NathanSpalding/wdd2-pick-and-place-arm/docs/datasheets.md

# Datasheets and sources

Datasheets and papers are not stored here because they are copyrighted. Download them from the manufacturer or the supplier pages below. The full reference list is at the end of the report.

## Components

| Part | Datasheet from | Bought from |
|---|---|---|
| ESP32-S3-WROOM-1 (N16R8) | Espressif | [Micro Robotics](https://www.robotics.org.za/ESP32-S3-N16R8) |
| AS5600 magnetic encoder | ams OSRAM | [Amazon](https://www.amazon.com/dp/B0CM3C8KFT) |
| TCA9548A I²C multiplexer | Texas Instruments | [Takealot](https://www.takealot.com/tca9548a-i2c-iic-multiplexer-breakout-board-8-channel-expansion/PLID101395334) |
| INA219 current sensor | Texas Instruments | [Micro Robotics](https://www.robotics.org.za/INA219-MOD) |
| XL4016 buck converter | XLSEMI | [Micro Robotics](https://www.robotics.org.za/XL4016) |
| DS5180 servo (shoulder) | DSServo / ANNIMOS | [Micro Robotics](https://www.robotics.org.za/DS5180-270-FB) |
| DS3240 servo (base, elbow) | DSServo | [Micro Robotics](https://www.robotics.org.za/DS3240-270-FB) |
| DS3225 servo (wrist) | DSServo | [Amazon](https://www.amazon.com/dp/B0CNTG877G) |
| MG996R servo (gripper) | Tower Pro | [Takealot](https://www.takealot.com/cmu-mg996r-towerpro-11kg-metal-gear-rc-servo-motor-180-4-8-6-6v/PLID100881340) |
| KP08 pillow block | — | [Netram](https://www.netram.co.za/bearings/8997-kp08-pillow-block-8mm-bore-2-pack.html) |
| PBME16TR-M4AL emergency stop | — | [Communica](https://www.communica.co.za/products/pbme16tr-m4al) |
| Hyper PLA-CF filament | Creality technical data sheet | DIYElectronics |

## Key references

- Al Tahtawi et al. (2021), *Small-scale robot arm design with pick and place mission based on inverse kinematics*, https://doi.org/10.18196/jrc.26124 (the 54 mm benchmark).
- Budynas and Nisbett (2015), *Shigley's Mechanical Engineering Design*, 10th ed. (stress and bearing life).
- Craig (2005), *Introduction to Robotics: Mechanics and Control* (kinematics).
- ISO 9283:1998, *Manipulating industrial robots: performance criteria and related test methods* (accuracy and repeatability).
- Carpentier et al. (2019), Pinocchio, and Caron, Pink (inverse kinematics libraries used by the software).
