NathanSpalding/wdd2-pick-and-place-arm/electronics/schematic/ESP_S3_N16R8_Pinout.png

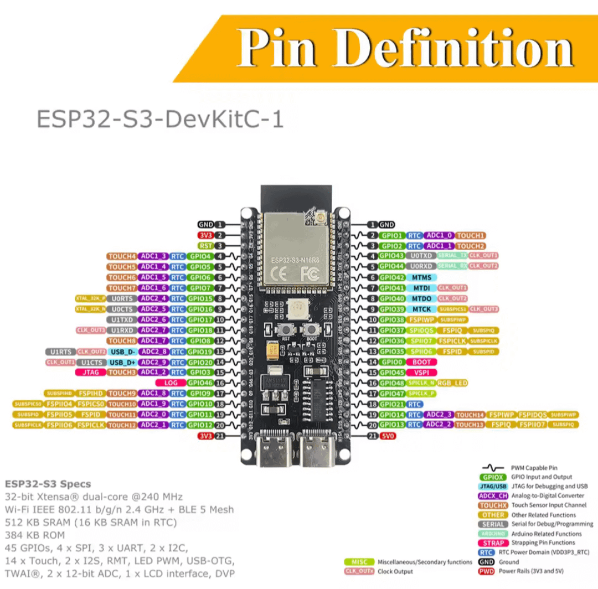
electronics/schematic/ESP_S3_N16R8_Pinout.png
