NathanSpalding/wdd2-pick-and-place-arm/electronics/BOM.xlsx

BOM
Description | QTY | UNIT PRICE | LINK | MATERIAL | INFILL | MASS PER PART (g) | LINE TOTAL (R)
Servo Motors
MG996R | 1 | R 129 | https://www.takealot.com/cmu-mg996r-towerpro-11kg-metal-gear-rc-servo-motor-180-4-8-6-6v/PLID100881340 |  |  |  | R 129.00
DS3225 | 1 | R 295 | https://www.amazon.com/dp/B0CNTG877G?ref=ppx_yo2ov_dt_b_fed_asin_title&th=1 |  |  |  | R 295.00
DS3240 | 2 | R 238 | https://www.robotics.org.za/DS3240-270-FB |  |  |  | R 476.00
DS5180 | 1 | R 398 | https://www.robotics.org.za/DS5180-270-FB |  |  |  | R 398.00
Servo Horns
25T for DS32 series | 3
18T for DS51 series | 1
Electrical
ESP S3 - N16R8 | 1 | R 178 | https://www.robotics.org.za/ESP32-S3-N16R8 |  |  |  | R 178.00
XL4016 Voltage Regulator | 3 | R 58 | https://www.robotics.org.za/XL4016 |  |  |  | R 174.00
INA219 Current Sensor | 1 | R 28 | https://www.robotics.org.za/INA219-MOD |  |  |  | R 28.00
TCA9548A I2C mux | 1 | R 63 | https://www.takealot.com/tca9548a-i2c-iic-multiplexer-breakout-board-8-channel-expansion/PLID101395334 |  |  |  | R 63.00
XT60 Connector | 1 | R 23 | https://www.robotics.org.za/XT60-KIT |  |  |  | R 23.00
3 Prong Plug | 1 | R 59 | https://www.builders.co.za/Electrical-and-Electronics/Plugs-Sockets-and-Switches/Multi-Plugs/Electricmate-Solid-Rubber-3-Prong-Plug-Top-Black-10-A/p/000000000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 |  |  |  | R 59.00
Cabtyre 1.5mm X3 Core | 3m | R 35 | https://www.builders.co.za/Electrical-and-Electronics/Wiring/Pre-Cut-Cables/waco-cabtyre-cable-black-3000-x-1-mm/p/000000850032252001 |  |  |  | R 35.00
Blade 30 A Fuse holder | 1 | R 12 | https://www.robotics.org.za/BLADE-30A-CAP |  |  |  | R 12.00
PBME16TR-M4AL Emergency Stop Switch 16mm 2c/o Latching Twist Reset | 1 | R 158 | https://www.communica.co.za/products/pbme16tr-m4al?variant=30700683788361 |  |  |  | R 158.00
12V 20A 300W DC Power Supply | 1 | R 211 | https://www.takealot.com/12v-20a-300w-professional-dc-power-supply/PLID95767010 |  |  |  | R 211.00
15A Blade Fuse | 5 | R 6.5 | https://www.takealot.com/motoquip-blade-fuses-15-amp/PLID40661066 |  |  |  | R 32.50
AS5600 Magnetic Encoder | 4 | R 41 | https://www.amazon.com/dp/B0CM3C8KFT?ref=ppx_yo2ov_dt_b_fed_asin_title |  |  |  | R 164.00
5V 1A Buck Regulator | 1 | R 16 | https://www.robotics.org.za/5V1A-BUCK-REG |  |  |  | R 16.00
5-Pin 12V DC 40A Vehicle Car Relay | 1 | R 299 | https://www.takealot.com/5-pin-12v-dc-40a-vehicle-car-relay/PLID99141473 |  |  |  | R 299.00
470 uF Capacitor | 1 |  | Electrical Labs
100nF Capacitor | 2 |  | Electrical Labs
10k ohm Resistor | 1 |  | Electrical Labs
1N4007 Diode 10 Pack | 1 | R 15 | https://www.robotics.org.za/1N4007-10 |  |  |  | R 15.00
Servo Wire Extension Kit | 2 | R 18 | https://www.robotics.org.za/SERVO-KIT |  |  |  | R 36.00
KF120 Screw Terminal Block Kit - 2.54mm (50 Pieces) | 1 | R 158 | https://www.robotics.org.za/KF120-KIT-50 |  |  |  | R 158.00
KF120 Screw Terminal Block 16 Pin - 2.54mm | 2 | R 14 | https://www.robotics.org.za/KF120-16P-254 |  |  |  | R 28.00
Screw Terminal Block 4 Pin - 5mm (10 Pack) | 1 | R 23 | https://www.robotics.org.za/KF301-4P |  |  |  | R 23.00
14 AWG (2.5mm²) Silicone Wire - Red, 1 m | 2 | R 30 | https://electromannsa.co.za/products/1meter-high-temperature-resistant-2-5mm-14awg-silicone-cable-red |  |  |  | R 60.00
14 AWG (2.5mm²) Silicone Wire - Black, 1 m | 2 | R 30 | https://electromannsa.co.za/products/1meter-high-temperature-resistant-2-5mm-14awg-silicone-cable-black |  |  |  | R 60.00
Protoboard 70 x 90mm (4 Pack) | 1 | R 70 | https://www.robotics.org.za/DS-7090-254 |  |  |  | R 70.00
Fasteners + shafts
350Pcs Threaded Inserts, M2-M6 Heat Set Inserts for 3D Printing | 1 | R 163 | https://www.amazon.com/dp/B0FVKYJ83G?ref=ppx_yo2ov_dt_b_fed_asin_title&th=1 |  |  |  | R 163.00
860Pcs M2-M5 Metric Screws, 12.9 Alloy Steel Hex Bolts & Nuts Kit | 1 | R 163 | https://www.amazon.com/dp/B0DBLCHK48?ref=ppx_yo2ov_dt_b_fed_asin_title&th=1 |  |  |  | R 163.00
8mm Aluminium Shaft | 4 |  | Mechanical Labs
Bearings
683ZZ Ball Bearing 3 x 7 x 3mm (10 Pack) | 2 | R 98 | https://www.robotics.org.za/683ZZ |  |  |  | R 196.00
KP08 Pillow Block Bearing 8mm Bore with Locking Collar (2 Pack, all 4 used) | 2 | R 75 | https://www.netram.co.za/bearings/8997-kp08-pillow-block-8mm-bore-2-pack.html |  |  |  | R 150.00
3D Printing
PLA-CF | R500/kg | R 500/kg
PETG | R350/kg | R 350/kg
End Effector
Base1 | 1 |  |  | PLA-CF |  | 4 | R 2.00
Base2 | 1 |  |  | PLA-CF |  | 3 | R 1.50
Link | 6 |  |  | PLA-CF |  | 1 | R 3.00
Claw | 4 |  |  | PLA-CF |  | 1 | R 2.00
EndPad | 2 |  |  | PLA-CF |  | 2 | R 2.00
ServoGear | 1 |  |  | PLA-CF |  | 2 | R 1.00
GearArm | 2 |  |  | PLA-CF |  | 1 | R 1.00
MotorHousing | 1 |  |  | PLA-CF |  | 4 | R 2.00
Bracket | 2 |  |  | PLA-CF |  | 1 | R 1.00
AS5600 Cover | 1 |  |  | PLA-CF |  | 3 | R 1.50
Wrist | 1 |  |  | PLA-CF |  | 60 | R 30.00
Servo end | 1 |  |  | PLA-CF |  | 1 | R 0.50
Assembled total: end effector + wrist + MG996R |  |  |  |  |  | 148
ForeArm
Link1 | 1 |  |  | PLA-CF |  | 127 | R 63.50
AS5600 Cover | 1 |  |  | PLA-CF |  | 3 | R 1.50
UpperArm
Link2 | 1 |  |  | PLA-CF |  | 145 | R 72.50
AS5600 Cover | 1 |  |  | PLA-CF |  | 3 | R 1.50
Turntable
Shoulder | 1 |  |  | PLA-CF |  | 255 | R 127.50
AS5600 Cover | 1 |  |  | PLA-CF |  | 3 | R 1.50
Base Coupling | 1 |  |  | PLA-CF |  | 157 | R 78.50
Base
Electrical Housing | 1 |  |  | PETG | 60% | 390 | R 136.50
Housing Cover 1 | 1 |  |  | PETG | 60% | 68 | R 23.80
Housing Cover 2 | 1 |  |  | PETG | 60% | 57 | R 19.95
COST SUMMARY
Servo motors |  |  |  |  |  |  | R 1298.00
Electrical |  |  |  |  |  |  | R 1902.50
Fasteners + shafts |  |  |  |  |  |  | R 326.00
Bearings |  |  |  |  |  |  | R 346.00
3D printing - PLA-CF |  |  |  |  |  |  | R 394.00
3D printing - PETG |  |  |  |  |  |  | R 180.25
3D printing total |  |  |  |  |  |  | R 574.25
TOTAL COST |  |  |  |  |  |  | R 4446.75
Printed mass - PLA-CF (g) |  |  |  |  |  |  | 788 g
Printed mass - PETG (g) |  |  |  |  |  |  | 515 g
Not costed: servo horns (no price), lab-supplied parts (free), print supports/failed prints
