NathanSpalding/wdd2-pick-and-place-arm/test-data/2026-10-13/WDD2_Test_Log.xlsx

Sheet: Overview
WDD2 Chapter 8 test log
Requirement map: section, method and result. Results update from the test sheets.
Req. | What | Section | Method | Result | Status and notes
R8 | Encoder accuracy ±1° | 8.2 | Test |  | Sweep 1 (up) 12 Oct against iPhone level (±0.5°) and protractor: max error 0.37–0.61°, no zero change needed. Base hunted between ±30° (touched to settle). Repeat sweeps optional.
R9 | Encoder finer and more accurate than the servo | 8.3 | Test |  | 12 Oct: encoder noise ≤ 1 count (0.09°); servo step resolution 0.27–0.78°, reversal deadband 0.6–3.6°; encoder max error 0.37–0.61° vs servo open-loop max 0.74–3.51°.
R11 | Control loop ≥ 200 Hz | 8.4 | Test |  | Earlier T runs: I²C 1.54–1.57 ms, loop exec max 1.85–4.45 ms, 0 overruns. Step test with trim on/off to do.
R10 | Grasp detection 9/10 | 8.5 | Test |  | 12 Oct: detection (K line) correct in 70/70 trials, empty to 500 g. With the hold during a 20° lift also required: 400 g 9/10 and 500 g 9/10 (one rotation slip each), all others 10/10. Grip current 0.10–0.21 A vs 0.009 A empty.
R12 | Positioning ±10 mm | 8.6 | Test |  | 13 Oct: 9 targets (r 250–350 mm, ±35–50°), 10 approaches each (30 at T9), pen tip as tool. Accuracy 3.1–6.4 mm, repeatability 4.7–7.0 mm, worst single approach 9.1 mm. Mean radial error −0.8 to −5.7 mm (always short); radial error grows over successive approaches (T9: −1.4 → −8.2 mm over 30). 500 g targets (T10, T11) not done.
R13 | Pick-and-place 9/10 within 15 s | 8.7 | Test |  | 13 Oct: 50 g 10/10 and 500 g 10/10 (plus 5 extra 500 g cycles, all successful). Cycle time 11.7-12.5 s. Place error 50 g 1.0-5.0 mm (mean 2.8), 500 g 1.4-8.0 mm (mean 3.7 over 15). Oscillation before the drop seen in 2/10 (50 g) and 9/15 (500 g) cycles; no significant effect on place error (p = 0.38).
R1 | Reach ≥ 300 mm | 8.7 | Test |  | Pick and place stations both at r 300 mm (±45°).
R3 | Payload 500 g | 8.7 | Test |  | 13 Oct: 500 g carried and placed in 15/15 cycles.
R2 | Hold 500 g at full extension | 8.8 | Test |  | 13 Oct: held 500 g at full extension (all joints 0°) for 5 min. Tip sag 15 mm (pad 65 → 50 mm); shoulder −0.75°, elbow −0.63° by encoder, both trims at the +5° clamp.
R5 | Rails within servo ratings | 8.8 | Test |  | 13 Oct, 500 g: idle / holding extended / lowest in an 8.7 cycle: shoulder 8.12 / 8.05 / 7.78 V, base+elbow 6.67 / 6.63 / 6.65 V, wrist+gripper 6.54 / 6.50 / 6.51 V, 5 V logic 5.15 / 5.06 / 5.15 V. No rail rose above idle. Multimeter only (~3 readings/s).
R4 | Servo temperatures | 8.8 | Test |  | 13 Oct (room 19.0 °C): after 25 cycles servos 19.4–29.8 °C; after 5 min holding 500 g extended elbow 54.5 °C (+35.5), shoulder 32.1 °C, others ≤ 23.4 °C. E-stop relay 41.7–42.8 °C. Limit 60 °C is assumed; check the DS3240 rating.
R6 | Fuse and protection | 8.8 | Test + inspection |  | Fuse intact after all tests (13 Oct). Polarity protection and transient suppression by inspection.
R7 | E-stop cuts servo power | 8.8 | Test |  | 13 Oct: 10/10 presses during motion cut every servo rail to 0 V, GUI showed the E-stop, arm stopped in 0.20–0.34 s; ESP and 5 V stayed on; restart only after latch release + GUI Reset. GPIO 41 wire off: relay still cut the rails, but on release the arm jerked to its last pose with no reset (restart interlock relies on the signal wire).
R14 | GUI | 8.2–8.8 | Demonstration | shown | Used throughout the tests.
R15 | Cost | App. | Analysis | see appendix | Techno-economic appendix.
R16 | Local sourcing | App. | Analysis | see appendix | Techno-economic appendix.
Suggested order
1. 8.4 loop rate (5 min, Serial Monitor only)
2. 8.3 part 1 noise and part 2 deadband (30 min)
3. 8.2 encoder calibration: one sweep, send it to me, update the zeros, then 3 verification sweeps (2–3 h)
4. 8.4 step test with the trim on and off (45 min)
5. 8.5 grasp trials (1 h)
6. 8.6 accuracy and repeatability (2–3 h, needs the mat and the pointer)
7. 8.7 pick-and-place cycles (1 h, film them)
8. 8.8 power, temperatures and E-stop (1 h, E-stop runs last, over something soft)

Sheet: 8.1 Setup
8.1 Test setup
Record once per test day. Not a test.
Legend: yellow cells = fill in during the test. Green cells = already measured during bring-up (keep or overwrite). White cells are formulas; do not type in them. The grey example row is not counted.
Item | Make and model | Resolution | Notes
Digital angle gauge / inclinometer
Calipers
Steel ruler
Kitchen scale
Multimeter
IR thermometer (if borrowed)
Phone (video)
Printed target mat |  |  | print at 100 %
Printed protractor for the base |  |  | 1° marks
Conditions
Item | Value | Unit | Notes
Test date
Room temperature |  | °C
12 V supply voltage (at the fuse) |  | V
Firmware |  |  | WDD2_firmware.ino, 12 Oct 2026 (S-curve, trim, X/O/T commands)
GUI |  |  | ui_app.py, 11 Oct 2026 (50 Hz J sender, 50 Hz log)
Encoder zeros (ZERO_RAW) |  |  | 1055, 117, 645, 444 (base, shoulder, elbow, wrist)
Export naming: save every GUI export as WDD2_<section>_<what>_<yyyymmdd>.xlsx, e.g. WDD2_8.6_accuracy_20261013.xlsx, and every Serial Monitor log as a .txt with the same name.

Sheet: 8.2 Encoder cal
8.2 Encoder calibration (R8: ±1°, Objective 3)
Shows that each AS5600 reads the true joint angle within ±1°, against an independent reference.
Method:
1. Serial Monitor, GUI closed. Move a joint with M,joint,angle,40 (0 base, 1 shoulder, 2 elbow, 3 wrist). Wait 2 s, then type O,joint,2: the "mean" it prints is the encoder angle (2 s average).
2. Reference: iPhone Measure → Level, phone on its long edge, zeroed on the table (±0.5°). The level shows magnitude only: readings below horizontal are entered as negative. Positive = up.
Shoulder: gauge on the upper arm. Elbow: gauge on the forearm AND on the upper arm (elbow = forearm − upper arm). Wrist: gauge on the gripper AND on the forearm. Base: printed protractor under the turntable with a pointer.
3. First do ONE upward sweep and send it to me: I work out any zero offset and update ZERO_RAW (and the servo fits, which use the same zero). Upload, then do the 3 verification sweeps below.
4. Each sweep: step up through the listed angles, then back down. Always approach in the stated direction.
Pass: maximum |error| ≤ 1.0° on every joint after calibration.
Legend: yellow cells = fill in during the test. Green cells = already measured during bring-up (keep or overwrite). White cells are formulas; do not type in them. The grey example row is not counted.
Joint | Sweep | Dir | Nominal (°) | Gauge on this link (°) | Gauge on parent link (°) | Reference (°) | Encoder (°) | Error (°) | |Error| | Error² | Note
elbow | ex | up | 20 | 21.6 | 1.2 |  | 20.6
base | 1 | up | -60 | -60.2 | — |  | -59.59
base | 1 | up | -50 | -49.7 | — |  | -50.19
base | 1 | up | -40 | -39.9 | — |  | -40.15
base | 1 | up | -30 | -30.2 | — |  | -30.06 |  |  |  | hunted; touched to settle
base | 1 | up | -20 | -19.7 | — |  | -20.13 |  |  |  | hunted; touched to settle
base | 1 | up | -10 | -9.9 | — |  | -10.02 |  |  |  | hunted; touched to settle
base | 1 | up | 0 | 0.2 | — |  | 0.26 |  |  |  | hunted; touched to settle
base | 1 | up | 10 | 9.8 | — |  | 9.93 |  |  |  | hunted; touched to settle
base | 1 | up | 20 | 19.8 | — |  | 19.61 |  |  |  | hunted; touched to settle
base | 1 | up | 30 | 29.7 | — |  | 29.79 |  |  |  | hunted; touched to settle
base | 1 | up | 40 | 40.2 | — |  | 40.08
base | 1 | up | 50 | 49.8 | — |  | 50.01
base | 1 | up | 60 | 60.1 | — |  | 60.03
base | 1 | down | 60 |  | —
base | 1 | down | 50 |  | —
base | 1 | down | 40 |  | —
base | 1 | down | 30 |  | —
base | 1 | down | 20 |  | —
base | 1 | down | 10 |  | —
base | 1 | down | 0 |  | —
base | 1 | down | -10 |  | —
base | 1 | down | -20 |  | —
base | 1 | down | -30 |  | —
base | 1 | down | -40 |  | —
base | 1 | down | -50 |  | —
base | 1 | down | -60 |  | —
base | 2 | up | -60 |  | —
base | 2 | up | -50 |  | —
base | 2 | up | -40 |  | —
base | 2 | up | -30 |  | —
base | 2 | up | -20 |  | —
base | 2 | up | -10 |  | —
base | 2 | up | 0 |  | —
base | 2 | up | 10 |  | —
base | 2 | up | 20 |  | —
base | 2 | up | 30 |  | —
base | 2 | up | 40 |  | —
base | 2 | up | 50 |  | —
base | 2 | up | 60 |  | —
base | 2 | down | 60 |  | —
base | 2 | down | 50 |  | —
base | 2 | down | 40 |  | —
base | 2 | down | 30 |  | —
base | 2 | down | 20 |  | —
base | 2 | down | 10 |  | —
base | 2 | down | 0 |  | —
base | 2 | down | -10 |  | —
base | 2 | down | -20 |  | —
base | 2 | down | -30 |  | —
base | 2 | down | -40 |  | —
base | 2 | down | -50 |  | —
base | 2 | down | -60 |  | —
base | 3 | up | -60 |  | —
base | 3 | up | -50 |  | —
base | 3 | up | -40 |  | —
base | 3 | up | -30 |  | —
base | 3 | up | -20 |  | —
base | 3 | up | -10 |  | —
base | 3 | up | 0 |  | —
base | 3 | up | 10 |  | —
base | 3 | up | 20 |  | —
base | 3 | up | 30 |  | —
base | 3 | up | 40 |  | —
base | 3 | up | 50 |  | —
base | 3 | up | 60 |  | —
base | 3 | down | 60 |  | —
base | 3 | down | 50 |  | —
base | 3 | down | 40 |  | —
base | 3 | down | 30 |  | —
base | 3 | down | 20 |  | —
base | 3 | down | 10 |  | —
base | 3 | down | 0 |  | —
base | 3 | down | -10 |  | —
base | 3 | down | -20 |  | —
base | 3 | down | -30 |  | —
base | 3 | down | -40 |  | —
base | 3 | down | -50 |  | —
base | 3 | down | -60 |  | —
shoulder | 1 | up | -30 | -29.6 | — |  | -29.97
shoulder | 1 | up | -20 | -20.4 | — |  | -20.31
shoulder | 1 | up | -10 | -9.8 | — |  | -9.76
shoulder | 1 | up | 0 | 0.5 | — |  | 0.22
shoulder | 1 | up | 10 | 10.3 | — |  | 10.64
shoulder | 1 | up | 20 | 19.8 | — |  | 19.92
shoulder | 1 | up | 30 | 29.8 | — |  | 30.08
shoulder | 1 | up | 40 | 40.2 | — |  | 40.34
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
wrist | 3 | up | -10
wrist | 3 | up | 0
wrist | 3 | up | 10
wrist | 3 | up | 20
wrist | 3 | up | 30
wrist | 3 | up | 40
wrist | 3 | up | 50
wrist | 3 | up | 60
wrist | 3 | up | 70
wrist | 3 | up | 80
wrist | 3 | up | 90
wrist | 3 | down | 90
wrist | 3 | down | 80
wrist | 3 | down | 70
wrist | 3 | down | 60
wrist | 3 | down | 50
wrist | 3 | down | 40
wrist | 3 | down | 30
wrist | 3 | down | 20
wrist | 3 | down | 10
wrist | 3 | down | 0
wrist | 3 | down | -10
wrist | 3 | down | -20
wrist | 3 | down | -30
wrist | 3 | down | -40
wrist | 3 | down | -50
wrist | 3 | down | -60
wrist | 3 | down | -70
wrist | 3 | down | -80
Summary
Joint | Points | RMS error (°) | Max |error| (°) | Hysteresis (°): mean down − mean up | Result
base
shoulder
elbow
wrist
All joints

Sheet: 8.3 Encoder vs servo
8.3 Encoder versus servo command (R9, Objective 4)
There is no servo feedback wire, so the encoder is compared with the servo command. Say so in the text.
Part 1, encoder resolution (firmware, Serial Monitor):
Move the joint to a mid pose (M,joint,angle,40), wait 3 s, then type O,joint,60. Record the std and peak-to-peak it prints.
Part 2, servo deadband (BRING-UP sketch, because it takes pulse widths in µs):
Approach the start pulse from 20 µs below (e.g. p2 1542 then p2 1562), type m<n>, then step DOWN 1 µs at a time (about 3 s each). The first pulse where the raw count changes and stays changed is the reversal point (deadband plus backlash). Keep stepping and note the µs between the next jumps: that is the step resolution.
Part 3, open-loop servo error: from the bring-up fits (pre-filled, green).
Pass: encoder std (part 1) < servo step resolution (part 2, in degrees), and encoder max error (8.2) < open-loop servo max error.
Legend: yellow cells = fill in during the test. Green cells = already measured during bring-up (keep or overwrite). White cells are formulas; do not type in them. The grey example row is not counted.
Part 1: encoder resolution (60 s hold)
Joint | Pose (°) | Std (°) | Peak-to-peak (°) | Theory: 1 count (°) | Note
example | 30 | 0.03 | 0.09
base | 30.000 | 0.000 | 0.090 |  | 12 Oct 2026, 60 s re-run (fixed firmware): std 0.00, p2p 0.00. First run flickered 1 count (0.09), kept as worst case
shoulder | 30.000 | 0.000 | 0.090 |  | 12 Oct 2026, 60 s re-run (fixed firmware): std 0.00, p2p 0.00. First run flickered 1 count (0.09), kept as worst case
elbow | 0.000 | 0.000 | 0.000 |  | 12 Oct 2026, 60 s
wrist | 0.000 | 0.000 | 0.000 |  | 12 Oct 2026, 60 s
Part 2: servo deadband (1 µs steps)
Joint | Start pulse (µs) | Reversal: first move (µs) | Step resolution (µs) | Slope k (°/µs) | Reversal deadband (°) | Step resolution (°) | Note
example | 1562 | 1556 | 2 | 0.1358
base | 1623 | 1618 | 4 | 0.1276 |  |  | Hunts ±0.7° for several s after each step (horn play); jumps every 3–5 µs
shoulder | 1558 | 1530 | 6 | 0.1292 |  |  | Stick-slip: 0.5–0.8° jumps, up to 2 s delay
elbow | 1582 | 1576 | 2 | 0.1358 |  |  | Start 1582 approached from below; step size from 1562→1564 up test
wrist | 1548 | 1539 | 3.5 | 0.1361 |  |  | 1 count creep at 1541; jumps every 3–4 µs
Slope k: magnitude of the bring-up fits (9 and 11 Oct 2026). Measured 12 Oct 2026 with the bring-up sketch, shoulder and elbow at 0°.
Part 3: open-loop servo error (bring-up fits) against encoder error (8.2)
Joint | Servo fit RMS (°) | Servo fit max (°) | Servo hysteresis (°) | Encoder max error, 8.2 (°) | Encoder std, part 1 (°) | Servo step resolution, part 2 (°) | Result
base | 0.45 | 0.74 | 0.5
shoulder | 1.60 | 2.96 | 3.2
elbow | 0.41 | 0.90 | 1.3
wrist | 1.26 | 3.51 | 0.7
All joints
Green: base fit 11 Oct (11 points, 2200 µs point excluded); shoulder, elbow and wrist fits 9 Oct 2026. Hysteresis = spread of readings at the same pulse.

Sheet: 8.4 Control loop
8.4 Control loop (R11: ≥ 200 Hz, Objective 6)
Loop timing, then a step test with the trim loop on and off.
Part 1, loop rate: Serial Monitor. Type T, wait at least 60 s (12 000 loops), type T again and copy the second output here. The firmware times every loop with micros().
Pass: mean period ≤ 5000 µs (≥ 200 Hz), every loop finishes inside its 5 ms (exec max < 5000 µs) and 0 overruns.
Part 2, step test (shoulder, elbow, wrist with and without 500 g; base without load, from 35° because it hunts inside ±30°):
X,joint,1 (trim on). M,joint,start,180, wait 3 s. M,joint,start+10,180, wait 5 s. Back to start. Repeat 3 times. Then X,joint,0 (trim off) and repeat. Then with 500 g in the gripper. Send me the Serial Monitor log: I extract settling time, overshoot and final error from the A lines and fill the yellow cells (or read final error with P).
Settling time: until the joint stays within ±0.5° of its final value. Final error: encoder − target, 5 s after the step.
Legend: yellow cells = fill in during the test. Green cells = already measured during bring-up (keep or overwrite). White cells are formulas; do not type in them. The grey example row is not counted.
Part 1: loop timing (from T)
Quantity | Value | Unit | Note
Loops measured | 22773
Mean loop period | 5000 | µs | 12 Oct 2026, 114 s run incl. moves
Min loop period | 4717 | µs
Max loop period | 5283 | µs
I²C read mean (4 encoders + INA219) | 1472 | µs | earlier: 1544–1565 µs
I²C read max | 1675 | µs | earlier: 1631–4062 µs
Loop exec max | 1965 | µs | earlier: 1852–4453 µs
Overruns | 0 |  | earlier: 0
Mean rate |  | Hz
Result
Part 2: step test (+10° steps)
Joint | Load | Trim | Rep | Start (°) | Settling time (s) | Overshoot (°) | Final error (°) | |Final error| | Return step (S+10 → S): settle s / overshoot / final error
example | 0 g | on | 1 | 20 | 0.45 | 0.6 | 0.2
base | 0 g | on | 1 | 35 | 0.32 | 1.01 | 0.08 |  | 0.52 s / 0.81° / -0.47°
base | 0 g | on | 2 | 35 | 0.36 | 1.03 | 0.11 |  | 0.7 s / 0.99° / -0.21°
base | 0 g | on | 3 | 35 | 0.30 | 0.83 | 0.18 |  | 0.52 s / 0.99° / -0.54°
base | 0 g | off | 1 | 35 | 0.32 | 1.08 | 0.00 |  | 0.76 s / 0.55° / -0.20°
base | 0 g | off | 2 | 35 | 0.28 | 0.79 | 0.18 |  | 0.78 s / 0.72° / -0.28°
base | 0 g | off | 3 | 35 | 0.28 | 0.79 | 0.26 |  | 0.78 s / 0.66° / -0.28°
shoulder | 0 g | on | 1 | 20 | 3.12 | 1.20 | -0.55 |  | 3.32 s / 1.19° / -1.12°
shoulder | 0 g | on | 2 | 20 | 2.62 | 1.29 | -0.38 |  | 0.4 s / 0.58° / -0.50°
shoulder | 0 g | on | 3 | 20 | 2.66 | 1.29 | -0.56 |  | 0.4 s / 0.0° / +0.30°
shoulder | 0 g | off | 1 | 20 | 0.42 | 0.00 | -2.40 |  | 0.32 s / 0.0° / +0.30°
shoulder | 0 g | off | 2 | 20 | 0.40 | 0.00 | -2.58 |  | 0.36 s / 0.22° / -0.22°
shoulder | 0 g | off | 3 | 20 | 0.38 | 0.00 | -2.40 |  | 0.36 s / 0.22° / -0.22°
shoulder | 500 g | on | 1 | 20 | 0.46 | 0.00 | -0.21 |  | 4.12 s / 1.1° / -1.02°
shoulder | 500 g | on | 2 | 20 | 0.48 | 0.00 | -0.47 |  | 0.36 s / 0.0° / +0.48°
shoulder | 500 g | on | 3 | 20 | 0.58 | 0.00 | -0.64 |  | 0.38 s / 0.0° / +0.57°
shoulder | 500 g | off | 1 | 20 | 0.42 | 0.00 | -5.65 |  | 0.34 s / 2.86° / -2.69°
shoulder | 500 g | off | 2 | 20 | 0.44 | 0.00 | -5.74 |  | 0.34 s / 2.77° / -2.68°
shoulder | 500 g | off | 3 | 20 | 0.44 | 0.00 | -5.57 |  | 0.36 s / 3.21° / -3.04°
elbow | 0 g | on | 1 | 20 | 0.36 | 0.17 | 0.13 |  | 0.24 s / 0.11° / +0.04°
elbow | 0 g | on | 2 | 20 | 0.28 | 0.50 | 0.15 |  | 0.24 s / 0.0° / +0.21°
elbow | 0 g | on | 3 | 20 | 0.36 | 0.50 | 0.32 |  | 0.24 s / 0.07° / +0.13°
elbow | 0 g | off | 1 | 20 | 0.26 | 0.00 | -3.72 |  | 0.22 s / 3.02° / -2.77°
elbow | 0 g | off | 2 | 20 | 0.26 | 0.00 | -3.49 |  | 0.22 s / 3.15° / -2.86°
elbow | 0 g | off | 3 | 20 | 0.26 | 0.00 | -3.63 |  | 0.22 s / 3.1° / -2.77°
elbow | 500 g | on | 1 | 20 | 0.50 | 1.29 | 0.27 |  | 0.38 s / 1.35° / -0.14°
elbow | 500 g | on | 2 | 20 | 1.74 | 1.03 | -0.03 |  | 0.64 s / 1.72° / -0.33°
elbow | 500 g | on | 3 | 20 | 0.76 | 1.38 | 0.23 |  | 0.64 s / 1.72° / -0.31°
elbow | 500 g | off | 1 | 20 | 0.30 | 0.00 | -4.07 |  | 0.38 s / 4.97° / -4.01°
elbow | 500 g | off | 2 | 20 | 0.30 | 0.00 | -4.34 |  | 0.38 s / 4.97° / -4.09°
elbow | 500 g | off | 3 | 20 | 0.30 | 0.00 | -4.60 |  | 0.38 s / 5.1° / -4.18°
wrist | 0 g | on | 1 | 20 | 0.24 | 0.15 | 0.15 |  | 0.32 s / 0.31° / -0.31°
wrist | 0 g | on | 2 | 20 | 2.76 | 0.41 | -0.21 |  | 0.68 s / 0.75° / -0.14°
wrist | 0 g | on | 3 | 20 | 1.80 | 0.41 | -0.21 |  | 0.84 s / 0.66° / -0.05°
wrist | 0 g | off | 1 | 20 | 0.26 | 0.00 | -1.00 |  | 0.26 s / 0.4° / -0.40°
wrist | 0 g | off | 2 | 20 | 0.24 | 0.00 | -1.79 |  | 0.26 s / 0.31° / -0.31°
wrist | 0 g | off | 3 | 20 | 0.22 | 0.00 | -1.41 |  | 0.26 s / 0.49° / -0.49°
wrist | 500 g | on | 1 | 20 | 0.28 | 0.39 | 0.35 |  | 0.4 s / 0.84° / -0.14°
wrist | 500 g | on | 2 | 20 | 0.48 | 1.29 | 0.11 |  | 0.4 s / 0.97° / -0.31°
wrist | 500 g | on | 3 | 20 | 0.54 | 1.11 | 0.06 |  | 0.28 s / 0.66° / -0.31°
wrist | 500 g | off | 1 | 20 | 0.28 | 0.00 | -1.61 |  | 0.56 s / 1.98° / -1.95°
wrist | 500 g | off | 2 | 20 | 0.30 | 0.00 | -1.88 |  | 0.26 s / 1.72° / -1.54°
wrist | 500 g | off | 3 | 20 | 1.42 | 0.00 | -1.70 |  | 0.24 s / 1.63° / -1.37°
Summary: mean |final error| (°)
Joint | Load | Trim on | Trim off | Improvement | Mean settle on (s) | Mean settle off (s)
base | 0 g
shoulder | 0 g
shoulder | 500 g
elbow | 0 g
elbow | 500 g
wrist | 0 g
wrist | 500 g
Improvement = error with the trim off − error with it on (positive = the trim loop helps).
Base (12 Oct): with the trim on, 3 of 6 holds hunted ±0.44° (0.56 s period) through the horn play; with it off, every hold was still (p2p ≤ 0.03°) and within 0.3°. The base trim is now off by default in the firmware.

Sheet: 8.5 Grasp
8.5 Grasp detection (R10: 9 of 10)
Detection rule in the firmware: wait 450 ms after G,1, then the median current over 200 ms must exceed 0.04 A.
Method (Serial Monitor): arm at the pick pose, gripper open (G,0). Place the payload between the jaws, send G,1 and note the K line (K,1 = grasp, K,0 = failed) and the median current it prints. Then lift 20° with the shoulder (M,1,<pose+20>,40), hold 3 s, come back, G,0.
Empty closures: G,1 with nothing in the jaws. Correct if the firmware answers K,0 (it re-opens by itself).
A "grasp detected" where the cube then slips counts as a failure.
Also export one current trace of a grasp and one of an empty closure (bring-up sketch: c 950) for the figure.
Pass: at least 9 of 10 correct for every payload and for the empty closures.
Legend: yellow cells = fill in during the test. Green cells = already measured during bring-up (keep or overwrite). White cells are formulas; do not type in them. The grey example row is not counted. |  |  |  |  |  |  |  | Payload make-up (masses weighed 12 Oct 2026)
Payload | Trial | K result (1 or 0) | Held during lift (Y/N) | Correct? | Median I (A) | Notes | Detection correct? | Payload | Items | Sum of items (g) | Weighed total (g)
50 g | ex | 1 | Y | yes | 0.11 |  |  | 50 g | cube + 1 oz #1
empty | 1 | 0 | — |  | 0.009 | 12 Oct 2026, all 10 K,0 and re-opened |  | 100 g | cube + bearing 1 + 2 oz
empty | 2 | 0 | — |  | 0.009 |  |  | 200 g | cube + 2 oz + 4 oz #3
empty | 3 | 0 | — |  | 0.009 |  |  | 300 g | cube + 4 oz #2 + 4 oz #3 + 2 oz
empty | 4 | 0 | — |  | 0.009 |  |  | 400 g | cube + 3 × 4 oz + 1 oz #2 + bearing 1
empty | 5 | 0 | — |  | 0.009 |  |  | 500 g | cube + 3 × 4 oz + 2 oz + 2 × 1 oz + 2 bearings
empty | 6 | 0 | — |  | 0.009 |  |  | Items: cube 24 g, bearings 10 g and 11 g, 1 oz 28 g and 27 g, 2 oz 60 g, 4 oz 116 g, 109 g, 113 g. Weigh each assembled payload (with its tape) and enter it in the yellow column.
empty | 7 | 0 | — |  | 0.009
empty | 8 | 0 | — |  | 0.009
empty | 9 | 0 | — |  | 0.009
empty | 10 | 0 | — |  | 0.009
50 g | 1 | 1 | Y |  | 0.115
50 g | 2 | 1 | Y |  | 0.128
50 g | 3 | 1 | Y |  | 0.134
50 g | 4 | 1 | Y |  | 0.145
50 g | 5 | 1 | Y |  | 0.128
50 g | 6 | 1 | Y |  | 0.118
50 g | 7 | 1 | Y |  | 0.114
50 g | 8 | 1 | Y |  | 0.102
50 g | 9 | 1 | Y |  | 0.122
50 g | 10 | 1 | Y |  | 0.116
100 g | 1 | 1 | Y |  | 0.116
100 g | 2 | 1 | Y |  | 0.109
100 g | 3 | 1 | Y |  | 0.14
100 g | 4 | 1 | Y |  | 0.111
100 g | 5 | 1 | Y |  | 0.121
100 g | 6 | 1 | Y |  | 0.11
100 g | 7 | 1 | Y |  | 0.105
100 g | 8 | 1 | Y |  | 0.124
100 g | 9 | 1 | Y |  | 0.122
100 g | 10 | 1 | Y |  | 0.115 | an 11th trial was also run: K,1, 0.108 A, held (11/11)
200 g | 1 | 1 | Y |  | 0.138
200 g | 2 | 1 | Y |  | 0.115
200 g | 3 | 1 | Y |  | 0.108
200 g | 4 | 1 | Y |  | 0.108
200 g | 5 | 1 | Y |  | 0.114
200 g | 6 | 1 | Y |  | 0.11
200 g | 7 | 1 | Y |  | 0.117
200 g | 8 | 1 | Y |  | 0.113
200 g | 9 | 1 | Y |  | 0.114
200 g | 10 | 1 | Y |  | 0.121
300 g | 1 | 1 | Y |  | 0.145
300 g | 2 | 1 | Y |  | 0.115
300 g | 3 | 1 | Y |  | 0.109
300 g | 4 | 1 | Y |  | 0.121
300 g | 5 | 1 | Y |  | 0.133
300 g | 6 | 1 | Y |  | 0.099
300 g | 7 | 1 | Y |  | 0.111
300 g | 8 | 1 | Y |  | 0.125
300 g | 9 | 1 | Y |  | 0.101
300 g | 10 | 1 | Y |  | 0.132
400 g | 1 | 1 | Y |  | 0.134
400 g | 2 | 1 | Y |  | 0.148
400 g | 3 | 1 | Y |  | 0.141
400 g | 4 | 1 | Y |  | 0.147
400 g | 5 | 1 | Y |  | 0.14
400 g | 6 | 1 | Y |  | 0.128
400 g | 7 | 1 | Y |  | 0.139
400 g | 8 | 1 | N |  | 0.12 | payload rotated about the jaw axis during the lift (no drop, no K,2)
400 g | 9 | 1 | Y |  | 0.124
400 g | 10 | 1 | Y |  | 0.125
500 g | 1 | 1 | Y |  | 0.16
500 g | 2 | 1 | Y |  | 0.162
500 g | 3 | 1 | Y |  | 0.212
500 g | 4 | 1 | Y |  | 0.167
500 g | 5 | 1 | Y |  | 0.14
500 g | 6 | 1 | N |  | 0.133 | payload slipped/rotated in the jaws during the lift (no drop, no K,2)
500 g | 7 | 1 | Y |  | 0.147
500 g | 8 | 1 | Y |  | 0.142
500 g | 9 | 1 | Y |  | 0.175
500 g | 10 | 1 | Y |  | 0.146
Summary
Payload | Trials done | Correct | Result | Detection only (K line right)
empty
50 g
100 g
200 g
300 g
400 g
500 g
All
Already measured (11 Oct 2026, c 950 capture): closing spike up to 2.5 A for 6–170 ms, a second burst at 195–240 ms (up to 3.1 A with no cube), empty closures back at idle (0.009 A) by about 350 ms; held cube 0.11–0.13 A. Hence the 450 ms delay.

Sheet: 8.6 Accuracy
8.6 Positioning accuracy and repeatability (R12: ±10 mm, Objective 7)
ISO 9283 style: accuracy = distance from the target to the mean position; repeatability = mean distance from the centroid + 3 standard deviations.
Setup: target mat with crosses measured from the BASE AXIS. A pointer (pin, dowel or pen) in the jaws with its tip at the TCP. Enter each target in the GUI (Cartesian target) and run it from the same home pose every time.
Each target: approaches from home via a point above the target. Read the tip offset from the cross along the target ray: radial (+ = beyond the target, − = short) and lateral (+ = right of the ray, − = left, seen from the base looking out along the ray), in mm.
Allow about 2 s for the base to settle before marking. T10 and T11 repeat T9 and T7 with 500 g in the gripper (sag).
Pass: accuracy ≤ 10 mm at every target. Compare with the 54 mm reported by Al Tahtawi et al.
Legend: yellow cells = fill in during the test. Green cells = already measured during bring-up (keep or overwrite). White cells are formulas; do not type in them. The grey example row is not counted.
Targets
Target |  | Radius (mm) | Base angle (°) | x (mm) | y (mm) | Gripper | Load | Notes
T1 |  | 250 | -50 |  |  | vertical | 0 g
T2 |  | 250 | -35 |  |  | vertical | 0 g
T3 |  | 250 | 35 |  |  | vertical | 0 g
T4 |  | 250 | 50 |  |  | vertical | 0 g
T5 |  | 350 | -50 |  |  | vertical | 0 g
T6 |  | 350 | -35 |  |  | vertical | 0 g
T7 |  | 350 | 35 |  |  | vertical | 0 g
T8 |  | 350 | 50 |  |  | vertical | 0 g
T9 |  | 300 | 45 |  |  | vertical | 0 g | R on the mat (repeatability target)
T10 |  | 300 | 45 |  |  | vertical | 500 g | T9 position with 500 g in the gripper
T11 |  | 350 | 35 |  |  | vertical | 500 g | T7 position (far) with 500 g: worst-case sag
Targets match WDD2_target_mat_A4x4.pdf. Robot frame: x forward from the base axis, y to the LEFT; base angle + = to the RIGHT (seen from behind the arm), so y = −r·sin(angle). All targets are outside ±30° on the base (horn-play hunting zone).
Approaches
Target | Trial | Radial (mm, + = beyond target) | Lateral (mm, + = right of ray) | Centroid radial | Centroid lateral | l = dist. to centroid | (l − mean l)² | Note
T1 | 1 | -2.0 | 6.0
T1 | 2 | -1.0 | 2.0
T1 | 3 | -1.0 | 4.0
T1 | 4 | -4.0 | 2.0
T1 | 5 | -5.0 | 2.0
T1 | 6 | -5.0 | 3.0
T1 | 7 | -6.0 | 2.0
T1 | 8 | -4.0 | 1.0
T1 | 9 | -2.0 | 0.0
T1 | 10 | 0.0 | 2.0
T2 | 1 | 0.0 | 0.0
T2 | 2 | -2.0 | -1.0
T2 | 3 | -3.0 | -3.0
T2 | 4 | -5.0 | -2.0
T2 | 5 | -3.0 | 0.0
T2 | 6 | -6.0 | 0.0
T2 | 7 | -1.0 | 2.0
T2 | 8 | -4.0 | 4.0
T2 | 9 | -4.0 | 2.0
T2 | 10 | -3.0 | 3.0
T3 | 1 | -1.0 | 0.0
T3 | 2 | -1.0 | -2.0
T3 | 3 | -4.0 | 0.0
T3 | 4 | -6.0 | 0.0
T3 | 5 | -6.0 | -2.0
T3 | 6 | -3.0 | 1.0
T3 | 7 | -5.0 | 1.0
T3 | 8 | -8.0 | 2.0
T3 | 9 | -4.0 | -2.0
T3 | 10 | -4.0 | 3.0
T4 | 1 | -4.0 | -1.0
T4 | 2 | -4.0 | 1.0
T4 | 3 | -4.0 | 3.0
T4 | 4 | -6.0 | 1.0
T4 | 5 | -5.0 | -1.0
T4 | 6 | -7.0 | 0.0
T4 | 7 | -8.0 | 2.0
T4 | 8 | -8.0 | 4.0
T4 | 9 | -3.0 | 4.0
T4 | 10 | -2.0 | 0.0
T5 | 1 | 1.0 | 4.0
T5 | 2 | 0.0 | 1.0
T5 | 3 | 0.0 | 3.0
T5 | 4 | 0.0 | 6.0
T5 | 5 | -2.0 | 3.0
T5 | 6 | -3.0 | 5.0
T5 | 7 | -4.0 | 7.0
T5 | 8 | -2.0 | 8.0
T5 | 9 | -4.0 | 4.0
T5 | 10 | -4.0 | 2.0
T6 | 1 | 1.0 | 5.0
T6 | 2 | 2.0 | 2.0
T6 | 3 | 3.0 | 4.0
T6 | 4 | 0.0 | 2.0
T6 | 5 | 0.0 | 4.0
T6 | 6 | -2.0 | 2.0
T6 | 7 | -2.0 | 4.0
T6 | 8 | -4.0 | 1.0
T6 | 9 | -4.0 | 3.0
T6 | 10 | -2.0 | 5.0
T7 | 1 | -2.0 | 2.0
T7 | 2 | -2.0 | 4.0
T7 | 3 | -2.0 | 1.0
T7 | 4 | -4.0 | 1.0
T7 | 5 | -4.0 | 3.0
T7 | 6 | -4.0 | 4.0
T7 | 7 | -6.0 | 3.0
T7 | 8 | -3.0 | -1.0
T7 | 9 | -6.0 | 5.0
T7 | 10 | -4.0 | -1.0
T8 | 1 | -6.0 | -1.0
T8 | 2 | -7.0 | 1.0
T8 | 3 | -6.0 | 2.0
T8 | 4 | -8.0 | 2.0
T8 | 5 | -4.0 | 2.0
T8 | 6 | -6.0 | 2.0
T8 | 7 | -7.0 | 4.0
T8 | 8 | -4.0 | 4.0
T8 | 9 | -6.0 | 6.0
T8 | 10 | -3.0 | 8.0
T9 | 1 | 0.0 | -2.0
T9 | 2 | -1.0 | -1.0
T9 | 3 | -2.0 | 1.0
T9 | 4 | -2.0 | -1.0
T9 | 5 | -2.0 | 3.0
T9 | 6 | -3.0 | -1.0
T9 | 7 | -3.0 | -2.0
T9 | 8 | -4.0 | -1.0
T9 | 9 | -4.0 | -3.0
T9 | 10 |  |  |  |  |  |  | lateral not recorded (radial −4); trial left out
T9 | 11 | -5.0 | 0.0
T9 | 12 | -5.0 | 2.0
T9 | 13 | -6.0 | -2.0
T9 | 14 | -6.0 | -1.0
T9 | 15 | -6.0 | 0.0
T9 | 16 | -6.0 | 1.0
T9 | 17 | -6.0 | 3.0
T9 | 18 | -6.0 | 4.0
T9 | 19 | -6.0 | 0.0
T9 | 20 | -6.0 | 1.0
T9 | 21 | -6.0 | 3.0
T9 | 22 | -7.0 | -4.0
T9 | 23 | -7.0 | -2.0
T9 | 24 | -7.0 | 0.0
T9 | 25 | -7.0 | 4.0
T9 | 26 | -8.0 | -3.0
T9 | 27 | -8.0 | 0.0
T9 | 28 | -8.0 | 2.0
T9 | 29 | -8.0 | 4.0
T9 | 30 | -9.0 | 1.0
T10 | 1
T10 | 2
T10 | 3
T10 | 4
T10 | 5
T10 | 6
T10 | 7
T10 | 8
T10 | 9
T10 | 10
T11 | 1
T11 | 2
T11 | 3
T11 | 4
T11 | 5
T11 | 6
T11 | 7
T11 | 8
T11 | 9
T11 | 10
Summary
Target | n | Mean radial (mm) | Mean lateral (mm) | Accuracy (mm) | Mean l (mm) | Std l (mm) | Repeatability (mm) | Result
T1
T2
T3
T4
T5
T6
T7
T8
T9
T10
T11
All (T1–T9)
"All" covers T1–T9 at 0 g (worst accuracy and worst repeatability). T10 and T11 (500 g) are reported separately to show the sag under load.
Measured 13 Oct 2026. Pen tip as tool point (185 mm from the wrist axis), gripper taped around the pen holder, targets commanded as joint angles (W command), each approach home → 50–70 mm above → target, tip hovering 6 mm above the mat. Readings to the nearest 1 mm by eye.

Sheet: 8.7 Cycles
8.7 Pick-and-place cycles (R13; also R1, R3, R14)
Saved JSON sequence in sequence mode, cycle times from the GUI cycle report.
Setup: pick spot ≥ 300 mm from the base axis (R1), place spot at another base angle (both beyond ±25° of base home). Mark both on the mat. Wait times at pick and place ≥ 2 s (base settling).
Success: the cube is picked, carried and released upright within the tolerance below of the place mark. Decide the tolerance before starting.
Runs: 10 cycles with 50 g, 10 with 500 g. Film them. Export the GUI data after each set.
Pass: at least 9 of 10 successful cycles per payload, each within 15 s.
Legend: yellow cells = fill in during the test. Green cells = already measured during bring-up (keep or overwrite). White cells are formulas; do not type in them. The grey example row is not counted.
Place tolerance (mm) |  | 10 | decide before testing
Max cycle time (s) |  | 15
Payload | Cycle | Picked and placed upright (Y/N) | Place error (mm) | Cycle time (s) | Success? | Notes
50 g | ex | Y | 6 | 12.4 | yes
50 g | 1 | Y | 2.8 | 11.7 |  | radial +2, lateral -2 mm; GUI cycle 3, finished 21:37:38; gripper holding 0.127 A (meas)
50 g | 2 | Y | 3.6 | 11.8 |  | radial +3, lateral -2 mm; GUI cycle 4, finished 21:39:12; gripper holding 0.129 A (meas)
50 g | 3 | Y | 2.8 | 11.8 |  | radial +2, lateral -2 mm; GUI cycle 5, finished 21:42:06; gripper holding 0.105 A (meas)
50 g | 4 | Y | 1.0 | 12.1 |  | radial +0, lateral -1 mm; GUI cycle 6, finished 21:42:52; gripper holding 0.115 A (meas)
50 g | 5 | Y | 3.0 | 11.8 |  | radial +3, lateral +0 mm; GUI cycle 7, finished 21:43:41; gripper holding 0.118 A (meas)
50 g | 6 | Y | 5.0 | 11.8 |  | radial +4, lateral -3 mm; GUI cycle 8, finished 21:44:30; gripper holding 0.127 A (meas); big oscillation on the way down
50 g | 7 | Y | 4.5 | 12.4 |  | radial +4, lateral -2 mm; GUI cycle 10, finished 21:45:34; gripper holding 0.122 A (meas); big oscillation on the way down
50 g | 8 | Y | 2.2 | 11.9 |  | radial +2, lateral -1 mm; GUI cycle 11, finished 21:46:27; gripper holding 0.125 A (meas)
50 g | 9 | Y | 1.0 | 12.2 |  | radial +0, lateral -1 mm; GUI cycle 12, finished 21:47:12; gripper holding 0.119 A (meas)
50 g | 10 | Y | 2.2 | 12.5 |  | radial +2, lateral -1 mm; GUI cycle 13, finished 21:48:17; gripper holding 0.103 A (meas)
500 g | 1 | Y | 5.7 | 12.4 |  | radial -4, lateral +4 mm; GUI cycle 1; gripper holding 0.131 A (meas); big oscillation before drop
500 g | 2 | Y | 2.0 | 12.0 |  | radial +0, lateral +2 mm; GUI cycle 3; gripper holding 0.157 A (meas)
500 g | 3 | Y | 8.0 | 11.9 |  | radial +0, lateral +8 mm; GUI cycle 4; gripper holding 0.139 A (meas); big oscillation before drop
500 g | 4 | Y | 2.2 | 12.4 |  | radial +1, lateral +2 mm; GUI cycle 5; gripper holding 0.145 A (meas)
500 g | 5 | Y | 4.0 | 11.9 |  | radial +0, lateral +4 mm; GUI cycle 6; gripper holding 0.136 A (meas)
500 g | 6 | Y | 4.2 | 12.2 |  | radial +3, lateral +3 mm; GUI cycle 7; gripper holding 0.141 A (meas); big oscillation before drop
500 g | 7 | Y | 5.7 | 12.1 |  | radial +4, lateral +4 mm; GUI cycle 8; gripper holding 0.138 A (meas); big oscillation before drop
500 g | 8 | Y | 2.8 | 12.3 |  | radial -2, lateral +2 mm; GUI cycle 9; gripper holding 0.317 A (meas); big oscillation before drop
500 g | 9 | Y | 1.4 | 11.9 |  | radial -1, lateral +1 mm; GUI cycle 11; gripper holding 0.129 A (meas); big oscillation before drop
500 g | 10 | Y | 2.8 | 12.2 |  | radial +2, lateral +2 mm; GUI cycle 12; gripper holding 0.132 A (meas); big oscillation before drop
Summary
Payload | Cycles done | Successes | Mean time (s) | Max time (s) | Result
50 g
500 g
All
13 Oct, 50 g, sequence test87_side_transfer (pick right station r 300 mm at -45 deg, place left station r 300 mm at +45 deg, above points z 100, 2 s waits). Export arm_export_20261013_215029.xlsx holds 13 GUI cycles: cycle 1 and 9 stopped (miss runs), cycle 2 = trial run before the set; cycles 3-8 and 10-13 are the 10 counted cycles. Model current columns in that export used cube mass 0.5 kg (GUI setting), not 50 g.
Place error = sqrt(radial^2 + lateral^2) from the two components measured on the mat (8.6 convention: radial + beyond / - short, lateral + right / - left of the ray, seen from the base).
Extra 500 g trials (run to check whether the oscillation affects accuracy; not counted in the summary above)
Payload | Cycle | Picked and placed upright (Y/N) | Place error (mm) | Cycle time (s) | Success? | Notes
500 g | 11 | Y | 2.0 | 12.3 |  | radial +0, lateral +2 mm; GUI cycle 13; gripper holding 0.132 A (meas)
500 g | 12 | Y | 3.0 | 12.4 |  | radial +0, lateral +3 mm; GUI cycle 14; gripper holding 0.134 A (meas); big oscillation before drop
500 g | 13 | Y | 3.6 | 11.9 |  | radial +2, lateral +3 mm; GUI cycle 15; gripper holding 0.134 A (meas)
500 g | 14 | Y | 5.0 | 12.0 |  | radial -3, lateral +4 mm; GUI cycle 16; gripper holding 0.239 A (meas)
500 g | 15 | Y | 3.0 | 12.0 |  | radial +0, lateral +3 mm; GUI cycle 17; gripper holding 0.139 A (meas); big oscillation before drop
Oscillation check (all 25 cycles, place error = sqrt(radial^2 + lateral^2))
Group | n | Mean error (mm) | Max error (mm) | Mean radial (mm) | Mean lateral (mm)
50 g, no oscillation seen | 8 | 2.3 | 3.6 | 1.8 | -1.3
50 g, oscillation seen | 2 | 4.7 | 5 | 4 | -2.5
500 g, no oscillation seen | 6 | 3.1 | 5 | 0 | 2.8
500 g, oscillation seen | 9 | 4.1 | 8 | 0.2 | 3.3
500 g with vs without oscillation: Mann-Whitney p = 0.38 (no significant difference). Every cycle is within the 10 mm tolerance. The GUI data log shows the commanded descent overshoots in every cycle (model tip dips 10-20 mm below the place height and rebounds; commanded shoulder swings 4-8 deg), and the release comes 0.6-1.0 s after the descent starts, so the cube is released while the arm is still settling. Lateral error differs between payloads (50 g mean -1.5 mm, 500 g mean +3.1 mm, p < 0.001) and follows the base encoder angle at release (Spearman 0.76): it is set by where the base settles (base trim off), not by the oscillation.

Sheet: 8.8 Power & safety
8.8 Power, temperature and safety (R2, R4, R5, R6, R7, Objective 2)
Do the E-stop runs over something soft: the arm drops when servo power is cut.
Full extension (R2): hold 500 g with the arm fully extended for 30 s. Record whether it holds, the sag and the servo case temperatures afterwards.
Rails (R5): multimeter at idle, while holding 500 g extended, and the lowest reading during a fast move. Check the rating limits against each datasheet before testing.
E-stop (R7): press it 10 times during motion. Then one run with the E-stop signal wire to GPIO 41 disconnected: the relay must still cut the servo power.
Fuse (R6): confirm it never blew. Polarity protection and transient suppression: by inspection only (do not reverse the supply).
Legend: yellow cells = fill in during the test. Green cells = already measured during bring-up (keep or overwrite). White cells are formulas; do not type in them. The grey example row is not counted.
Full extension hold (R2)
Quantity | Value | Unit | Note
Held 500 g for 30 s (Y/N) | Y |  | 13 Oct: W,0,0,0,0 (all joints horizontal), 500 g cube, grasp confirmed (median 0.142 A), still holding at the check (0.109 A).
Sag at the tip | 15 | mm | Pad centre 65 mm above table empty, 50 mm loaded (ruler).
Shoulder encoder change | -0.75 | ° | 0.13 -> -0.62 deg; trim at its +5.00 deg clamp (was +2.33 empty)
Elbow encoder change | -0.63 | ° | -0.25 -> -0.88 deg; trim at its +5.00 deg clamp (was +2.39 empty). Wrist -0.09 -> -0.18 deg, trim -0.23 -> +1.72.
Result
Encoder changes account for ~9 mm of the 15 mm sag (0.75 deg x 453 mm + 0.63 deg x 278 mm + 0.09 deg x 133 mm); the rest is bending/play downstream of the encoders (wrist bracket, gripper, cube in the pads). Shoulder and elbow trims saturate at the 5 deg clamp, so this pose with 500 g is at the limit of what the trim loop can correct.
Rail voltages (R5)
Rail | Rating min (V) | Rating max (V) | Idle (V) | Holding 500 g extended (V) | Lowest in fast move (V) | Result | Notes
#1 shoulder (DS5180), 8.0 V | 6.00 | 8.40 | 8.12 | 8.05 | 7.78 |  | idle: bring-up 9 Oct; holding: 13 Oct W,0,0,0,0 + 500 g; fast move: one 8.7 cycle with 500 g, phone video of the meter: min 7.78 V in the side transfer, max 8.08 V while lowering the cube
#2 base and elbow (DS3240), 6.7 V | 4.80 | 6.80 | 6.67 | 6.63 | 6.65 |  | idle: bring-up 9 Oct; holding: 13 Oct W,0,0,0,0 + 500 g; fast move: one 8.7 cycle with 500 g, phone video of the meter: 6.65-6.66 V throughout (elbow loads on the descents, base on the side transfer, so the peaks do not coincide)
#3 wrist and gripper (DS3225, MG996R), 6.5 V | 4.80 | 6.80 | 6.54 | 6.50 | 6.51 |  | idle: bring-up 9 Oct; holding: 13 Oct W,0,0,0,0 + 500 g; fast move: one 8.7 cycle with 500 g, phone video of the meter: min 6.51 V in the side transfer, max 6.53 V on the descents and pickup
5 V logic | 4.75 | 5.25 | 5.15 | 5.06 | 5.15 |  | idle: bring-up 9 Oct; holding: 13 Oct 5.06 V; fast move: flat at 5.15 V over one 8.7 cycle with 500 g (phone video of the meter)
All rails
Ratings B19:C22 are the typical published ranges (DS5180 6.0-8.4 V; DS3240 and DS3225 4.8-6.8 V; MG996R 4.8-7.2 V so rail 3 uses the narrower DS3225 range; 5 V USB-level input 4.75-5.25 V). Confirm each against your own datasheet before quoting. Fast-move values: lowest/highest reading on a handheld multimeter (display ~3 updates/s, phone video), so short transients are not captured.
Servo case temperatures
Servo | After 10 cycles (°C) | After 5 min hold extended (°C) | Limit (°C) | Result | Baseline, holding home (°C) | Rise over room (°C) | Rise over room after cycles (°C) | Rise over room after 5 min hold (°C)
Base (DS3240) | 19.5 | 21.3 | 60 |  | 21.3
Shoulder (DS5180) | 23.9 | 32.1 | 60 |  | 23.3
Elbow (DS3240) | 29.8 | 54.5 | 60 |  | 27.7
Wrist (DS3225) | 19.4 | 23.4 | 60 |  | 20.9
Gripper (MG996R) | 19.7 | 21.7 | 60 |  | 21.0
All servos
Limit 60 °C is an assumed safe case temperature for PLA-CF mounts and the servos; change it if you use a datasheet value. After 5 min hold = W,0,0,0,0 with 500 g for 5 min (13 Oct), room 19.0 °C (H54). Elbow 54.5 °C is the closest to the limit.
After 10 cycles = measured ~5 min after the last 8.7 cycle (13 Oct, 25 cycles in total incl. 15 with 500 g), room 19.0 °C (E54).
E-stop (R7)
Press | Servo rail after press (V) | 5 V logic stays on (Y/N) | GUI shows E-stop (Y/N) | No restart until Reset (Y/N) | Result | Stop time (s, phone video) | Notes
1 | 0.00 | Y | Y | Y |  | 0.20–0.34 over the 10 presses | 13 Oct: pressed during motion; 0 V on each servo rail every time, GUI showed E-stop every time; ESP and 5 V stayed on throughout; arm only resumed after the E-stop latch was released AND Reset was pressed in the GUI.
2 | 0.00 | Y | Y | Y
3 | 0.00 | Y | Y | Y
4 | 0.00 | Y | Y | Y
5 | 0.00 | Y | Y | Y
6 | 0.00 | Y | Y | Y
7 | 0.00 | Y | Y | Y
8 | 0.00 | Y | Y | Y
9 | 0.00 | Y | Y | Y
10 | 0.00 | Y | Y | Y
signal wire disconnected | 0.00 | Y | — | N |  |  | Relay still cut all servo rails to 0 V (hardware cut works without the ESP). GUI unaware (expected). On releasing the E-stop the rails came back with no reset and the arm jerked to its last commanded pose: the restart interlock depends on the GPIO 41 signal.
All presses
Bring-up 9 Oct 2026: with the E-stop pressed the servo rails read 0.01 V and the ESP kept running.
Fuse intact after all tests (Y/N) | Y |  | 13 Oct, after all tests
Thermal baseline (Fluke VT02, 13 Oct 2026, before testing) |  |  |  | After 8.7 (~5 min after the last cycle) |  |  | After 5 min hold, 500 g extended
Room (°C) | 19.9 |  | Rise over room (°C) → | 19 |  | ← rise over room (°C) | 19
Buck converter #1, shoulder rail (°C) | 27.3 |  |  | 28 |  |  | 29.1
Buck converter #2, base + elbow rail (°C) | 25.2 |  |  | 26.2 |  |  | 29.8
Buck converter #3, wrist + gripper rail (°C) | 22.6 |  |  | 27.1 |  |  | 24.8
Bench power supply (°C) | 30.3 |  |  | 30.2 |  |  | 31.3
ESP32 and INA219 not imaged: buried in the wiring loom. Both dissipate < 0.5 W (ESP32 ≈ 0.33 W, INA219 shunt ≈ 2 mW at 0.15 A).
E-stop relay (°C) |  |  |  | 42.8 |  |  | 41.7
Relay not imaged at baseline. Hottest part after 8.7 (42.8 °C, +23.8 °C over room): coil held energised the whole time the arm runs, plus servo current through the contacts.
