NathanSpalding/wdd2-pick-and-place-arm/test-data/2026-10-12/WDD2_Test_Log.xlsx

Sheet: Overview
WDD2 Chapter 8 test log
Requirement map: section, method and result. Results update from the test sheets.
Req. | What | Section | Method | Result | Status and notes
R8 | Encoder accuracy ±1° | 8.2 | Test | not done | Bring-up fits compared encoder with pulse (servo, not encoder): needs the gauge sweeps. Base zero re-set 11 Oct (raw 1055).
R9 | Encoder finer and more accurate than the servo | 8.3 | Test | not done | Open-loop servo error known from the bring-up fits. Encoder noise seen ≤ 1 count. Deadband test to do.
R11 | Control loop ≥ 200 Hz | 8.4 | Test | not done | Earlier T runs: I²C 1.54–1.57 ms, loop exec max 1.85–4.45 ms, 0 overruns. Step test with trim on/off to do.
R10 | Grasp detection 9/10 | 8.5 | Test | not done | Spike captured 11 Oct; settling delay 450 ms + 200 ms median, threshold 0.04 A. Trials to do.
R12 | Positioning ±10 mm | 8.6 | Test | not done | Needs the target mat and a TCP pointer.
R13 | Pick-and-place 9/10 within 15 s | 8.7 | Test | not done | Demo 2 sequence ran correctly on 12 Oct (informal).
R1 | Reach ≥ 300 mm | 8.7 | Test | not done | Pick spot placed ≥ 300 mm from the base axis.
R3 | Payload 500 g | 8.7 | Test | not done | 500 g cycle set.
R2 | Hold 500 g at full extension | 8.8 | Test | not done
R5 | Rails within servo ratings | 8.8 | Test | not done | Idle values from bring-up pre-filled; ratings to fill from datasheets.
R4 | Servo temperatures | 8.8 | Test | not done
R6 | Fuse and protection | 8.8 | Test + inspection | not done | Polarity protection and transient suppression by inspection.
R7 | E-stop cuts servo power | 8.8 | Test | not done | Bring-up: 0.01 V with E-stop pressed.
R14 | GUI | 8.2–8.8 | Demonstration | shown | Used throughout the tests.
R15 | Cost | App. | Analysis | see appendix | Techno-economic appendix.
R16 | Local sourcing | App. | Analysis | see appendix | Techno-economic appendix.
Suggested order
1. 8.4 loop rate (5 min, Serial Monitor only)
2. 8.3 part 1 noise and part 2 deadband (30 min)
3. 8.2 encoder calibration: one sweep, send it to me, update the zeros, then 3 verification sweeps (2–3 h)
4. 8.4 step test with the trim on and off (45 min)
5. 8.5 grasp trials (1 h)
6. 8.6 accuracy and repeatability (2–3 h, needs the mat and the pointer)
7. 8.7 pick-and-place cycles (1 h, film them)
8. 8.8 power, temperatures and E-stop (1 h, E-stop runs last, over something soft)

Sheet: 8.1 Setup
8.1 Test setup
Record once per test day. Not a test.
Legend: yellow cells = fill in during the test. Green cells = already measured during bring-up (keep or overwrite). White cells are formulas; do not type in them. The grey example row is not counted.
Item | Make and model | Resolution | Notes
Digital angle gauge / inclinometer
Calipers
Steel ruler
Kitchen scale
Multimeter
IR thermometer (if borrowed)
Phone (video)
Printed target mat |  |  | print at 100 %
Printed protractor for the base |  |  | 1° marks
Conditions
Item | Value | Unit | Notes
Test date
Room temperature |  | °C
12 V supply voltage (at the fuse) |  | V
Firmware |  |  | WDD2_firmware.ino, 12 Oct 2026 (S-curve, trim, X/O/T commands)
GUI |  |  | ui_app.py, 11 Oct 2026 (50 Hz J sender, 50 Hz log)
Encoder zeros (ZERO_RAW) |  |  | 1055, 117, 645, 444 (base, shoulder, elbow, wrist)
Export naming: save every GUI export as WDD2_<section>_<what>_<yyyymmdd>.xlsx, e.g. WDD2_8.6_accuracy_20261013.xlsx, and every Serial Monitor log as a .txt with the same name.

Sheet: 8.2 Encoder cal
8.2 Encoder calibration (R8: ±1°, Objective 3)
Shows that each AS5600 reads the true joint angle within ±1°, against an independent reference.
Method:
1. Serial Monitor, GUI closed. Move a joint with M,joint,angle,40 (0 base, 1 shoulder, 2 elbow, 3 wrist). Wait 2 s, then type O,joint,2: the "mean" it prints is the encoder angle (2 s average).
2. Reference, angles positive = up: zero the gauge on a level surface first.
Shoulder: gauge on the upper arm. Elbow: gauge on the forearm AND on the upper arm (elbow = forearm − upper arm). Wrist: gauge on the gripper AND on the forearm. Base: printed protractor under the turntable with a pointer.
3. First do ONE upward sweep and send it to me: I work out any zero offset and update ZERO_RAW (and the servo fits, which use the same zero). Upload, then do the 3 verification sweeps below.
4. Each sweep: step up through the listed angles, then back down. Always approach in the stated direction.
Pass: maximum |error| ≤ 1.0° on every joint after calibration.
Legend: yellow cells = fill in during the test. Green cells = already measured during bring-up (keep or overwrite). White cells are formulas; do not type in them. The grey example row is not counted.
Joint | Sweep | Dir | Nominal (°) | Gauge on this link (°) | Gauge on parent link (°) | Reference (°) | Encoder (°) | Error (°) | |Error| | Error²
elbow | ex | up | 20 | 21.6 | 1.2 | 20.40 | 20.6 | 0.20
base | 1 | up | -60 |  | —
base | 1 | up | -50 |  | —
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
wrist | 3 | down | -80
Summary
Joint | Points | RMS error (°) | Max |error| (°) | Hysteresis (°): mean down − mean up | Result
base | 0 |  |  |  | not done
shoulder | 0 |  |  |  | not done
elbow | 0 |  |  |  | not done
wrist | 0 |  |  |  | not done
All joints |  |  |  |  | not done

Sheet: 8.3 Encoder vs servo
8.3 Encoder versus servo command (R9, Objective 4)
There is no servo feedback wire, so the encoder is compared with the servo command. Say so in the text.
Part 1, encoder resolution (firmware, Serial Monitor):
Move the joint to a mid pose (M,joint,angle,40), wait 3 s, then type O,joint,60. Record the std and peak-to-peak it prints.
Part 2, servo deadband (BRING-UP sketch, because it takes pulse widths in µs):
Start the joint near 0° (p1 1558, p2 1562, p3 1548, p0 1623), type m<n>, then raise the pulse 1 µs at a time (e.g. p2 1563, p2 1564, …) until the encoder angle changes. Record the pulse where it first moved. Repeat going down.
Part 3, open-loop servo error: from the bring-up fits (pre-filled, green).
Pass: encoder std < servo deadband (in degrees), and encoder max error (8.2) < open-loop servo max error.
Legend: yellow cells = fill in during the test. Green cells = already measured during bring-up (keep or overwrite). White cells are formulas; do not type in them. The grey example row is not counted.
Part 1: encoder resolution (60 s hold)
Joint | Pose (°) | Std (°) | Peak-to-peak (°) | Theory: 1 count (°) | Note
example | 30 | 0.03 | 0.09 | 0.088
base |  |  |  | 0.088
shoulder |  |  |  | 0.088
elbow |  |  |  | 0.088
wrist |  |  |  | 0.088
Part 2: servo deadband (1 µs steps)
Joint | Start pulse (µs) | First move going up (µs) | First move going down (µs) | Slope k (°/µs) | Deadband up (°) | Deadband down (°) | Mean (°)
example | 1562 | 1565 | 1558 | 0.1358
base | 1623 |  |  | 0.1276
shoulder | 1558 |  |  | 0.1292
elbow | 1562 |  |  | 0.1358
wrist | 1548 |  |  | 0.1361
Slope k: magnitude of the bring-up fits (9 and 11 Oct 2026).
Part 3: open-loop servo error (bring-up fits) against encoder error (8.2)
Joint | Servo fit RMS (°) | Servo fit max (°) | Servo hysteresis (°) | Encoder max error, 8.2 (°) | Encoder std, part 1 (°) | Servo deadband, part 2 (°) | Result
base | 0.45 | 0.74 | 0.5 |  | 0.000 |  | not done
shoulder | 1.60 | 2.96 | 3.2 |  | 0.000 |  | not done
elbow | 0.41 | 0.90 | 1.3 |  | 0.000 |  | not done
wrist | 1.26 | 3.51 | 0.7 |  | 0.000 |  | not done
All joints |  |  |  |  |  |  | not done
Green: base fit 11 Oct (11 points, 2200 µs point excluded); shoulder, elbow and wrist fits 9 Oct 2026. Hysteresis = spread of readings at the same pulse.

Sheet: 8.4 Control loop
8.4 Control loop (R11: ≥ 200 Hz, Objective 6)
Loop timing, then a step test with the trim loop on and off.
Part 1, loop rate: Serial Monitor. Type T, wait at least 60 s (12 000 loops), type T again and copy the second output here. The firmware times every loop with micros().
Pass: mean period ≤ 5000 µs (≥ 200 Hz), every loop finishes inside its 5 ms (exec max < 5000 µs) and 0 overruns.
Part 2, step test (shoulder, elbow, wrist; base without load only):
X,joint,1 (trim on). M,joint,start,180, wait 3 s. M,joint,start+10,180, wait 5 s. Back to start. Repeat 3 times. Then X,joint,0 (trim off) and repeat. Then with 500 g in the gripper. Send me the Serial Monitor log: I extract settling time, overshoot and final error from the A lines and fill the yellow cells (or read final error with P).
Settling time: until the joint stays within ±0.5° of its final value. Final error: encoder − target, 5 s after the step.
Legend: yellow cells = fill in during the test. Green cells = already measured during bring-up (keep or overwrite). White cells are formulas; do not type in them. The grey example row is not counted.
Part 1: loop timing (from T)
Quantity | Value | Unit | Note
Loops measured
Mean loop period |  | µs
Min loop period |  | µs
Max loop period |  | µs
I²C read mean (4 encoders + INA219) |  | µs | earlier: 1544–1565 µs
I²C read max |  | µs | earlier: 1631–4062 µs
Loop exec max |  | µs | earlier: 1852–4453 µs
Overruns |  |  | earlier: 0
Mean rate |  | Hz
Result | not done
Part 2: step test (+10° steps)
Joint | Load | Trim | Rep | Start (°) | Settling time (s) | Overshoot (°) | Final error (°) | |Final error
example | 0 g | on | 1 | 20 | 0.45 | 0.6 | 0.2
base | 0 g | on | 1 | 0
base | 0 g | on | 2 | 0
base | 0 g | on | 3 | 0
base | 0 g | off | 1 | 0
base | 0 g | off | 2 | 0
base | 0 g | off | 3 | 0
shoulder | 0 g | on | 1 | 20
shoulder | 0 g | on | 2 | 20
shoulder | 0 g | on | 3 | 20
shoulder | 0 g | off | 1 | 20
shoulder | 0 g | off | 2 | 20
shoulder | 0 g | off | 3 | 20
shoulder | 500 g | on | 1 | 20
shoulder | 500 g | on | 2 | 20
shoulder | 500 g | on | 3 | 20
shoulder | 500 g | off | 1 | 20
shoulder | 500 g | off | 2 | 20
shoulder | 500 g | off | 3 | 20
elbow | 0 g | on | 1 | 20
elbow | 0 g | on | 2 | 20
elbow | 0 g | on | 3 | 20
elbow | 0 g | off | 1 | 20
elbow | 0 g | off | 2 | 20
elbow | 0 g | off | 3 | 20
elbow | 500 g | on | 1 | 20
elbow | 500 g | on | 2 | 20
elbow | 500 g | on | 3 | 20
elbow | 500 g | off | 1 | 20
elbow | 500 g | off | 2 | 20
elbow | 500 g | off | 3 | 20
wrist | 0 g | on | 1 | 20
wrist | 0 g | on | 2 | 20
wrist | 0 g | on | 3 | 20
wrist | 0 g | off | 1 | 20
wrist | 0 g | off | 2 | 20
wrist | 0 g | off | 3 | 20
wrist | 500 g | on | 1 | 20
wrist | 500 g | on | 2 | 20
wrist | 500 g | on | 3 | 20
wrist | 500 g | off | 1 | 20
wrist | 500 g | off | 2 | 20
wrist | 500 g | off | 3 | 20
Summary: mean |final error| (°)
Joint | Load | Trim on | Trim off | Improvement | Mean settle on (s) | Mean settle off (s)
base | 0 g
shoulder | 0 g
shoulder | 500 g
elbow | 0 g
elbow | 500 g
wrist | 0 g
wrist | 500 g
Improvement = error with the trim off − error with it on (positive = the trim loop helps).

Sheet: 8.5 Grasp
8.5 Grasp detection (R10: 9 of 10)
Detection rule in the firmware: wait 450 ms after G,1, then the median current over 200 ms must exceed 0.04 A.
Method (Serial Monitor or GUI): place the cube between the open jaws, send G,1 and note the K line (K,1 = grasp, K,0 = failed). Then lift (e.g. M,1,<current + 15>,40) and note whether the cube stays held. G,0 to release.
Empty closures: G,1 with nothing in the jaws. Correct if the firmware answers K,0 (it re-opens by itself).
A "grasp detected" where the cube then slips counts as a failure.
Also export one current trace of a grasp and one of an empty closure (bring-up sketch: c 950) for the figure.
Pass: at least 9 of 10 correct for every payload and for the empty closures.
Legend: yellow cells = fill in during the test. Green cells = already measured during bring-up (keep or overwrite). White cells are formulas; do not type in them. The grey example row is not counted.
Payload | Trial | K result (1 or 0) | Held during lift (Y/N) | Correct? | Median I (A) | Notes
50 g | ex | 1 | Y | yes | 0.11
empty | 1 |  | —
empty | 2 |  | —
empty | 3 |  | —
empty | 4 |  | —
empty | 5 |  | —
empty | 6 |  | —
empty | 7 |  | —
empty | 8 |  | —
empty | 9 |  | —
empty | 10 |  | —
50 g | 1
50 g | 2
50 g | 3
50 g | 4
50 g | 5
50 g | 6
50 g | 7
50 g | 8
50 g | 9
50 g | 10
100 g | 1
100 g | 2
100 g | 3
100 g | 4
100 g | 5
100 g | 6
100 g | 7
100 g | 8
100 g | 9
100 g | 10
200 g | 1
200 g | 2
200 g | 3
200 g | 4
200 g | 5
200 g | 6
200 g | 7
200 g | 8
200 g | 9
200 g | 10
500 g | 1
500 g | 2
500 g | 3
500 g | 4
500 g | 5
500 g | 6
500 g | 7
500 g | 8
500 g | 9
500 g | 10
Summary
Payload | Trials done | Correct | Result
empty | 0 | 0 | not done
50 g | 0 | 0 | not done
100 g | 0 | 0 | not done
200 g | 0 | 0 | not done
500 g | 0 | 0 | not done
All |  |  | not done
Already measured (11 Oct 2026, c 950 capture): closing spike up to 2.5 A for 6–170 ms, a second burst at 195–240 ms (up to 3.1 A with no cube), empty closures back at idle (0.009 A) by about 350 ms; held cube 0.11–0.13 A. Hence the 450 ms delay.

Sheet: 8.6 Accuracy
8.6 Positioning accuracy and repeatability (R12: ±10 mm, Objective 7)
ISO 9283 style: accuracy = distance from the target to the mean position; repeatability = mean distance from the centroid + 3 standard deviations.
Setup: target mat with crosses measured from the BASE AXIS. A pointer (pin, dowel or pen) in the jaws with its tip at the TCP. Enter each target in the GUI (Cartesian target) and run it from the same home pose every time.
Each target: 10 approaches from home. Measure the tip offset from the cross: dx along the radius (away from the base = +), dy across it (counter-clockwise seen from above = +), in mm. Or dot the paper with a pen and measure later.
Allow about 2 s for the base to settle before marking. T11 = the far target again with 500 g in the gripper (sag).
Pass: accuracy ≤ 10 mm at every target. Compare with the 54 mm reported by Al Tahtawi et al.
Legend: yellow cells = fill in during the test. Green cells = already measured during bring-up (keep or overwrite). White cells are formulas; do not type in them. The grey example row is not counted.
Targets
Target |  | Radius (mm) | Base angle (°) | x (mm) | y (mm) | Gripper | Load | Notes
T1 |  | 280 | 0 | 280.0 | 0.0 | vertical | 0 g
T2 |  | 280 | 45 | 198.0 | 198.0 | vertical | 0 g
T3 |  | 280 | -45 | 198.0 | -198.0 | vertical | 0 g
T4 |  | 320 | 0 | 320.0 | 0.0 | vertical | 0 g
T5 |  | 320 | 45 | 226.3 | 226.3 | vertical | 0 g
T6 |  | 320 | -45 | 226.3 | -226.3 | vertical | 0 g
T7 |  | 360 | 0 | 360.0 | 0.0 | vertical | 0 g
T8 |  | 360 | 45 | 254.6 | 254.6 | vertical | 0 g
T9 |  | 360 | -45 | 254.6 | -254.6 | vertical | 0 g
T10 |  | 450 | 0 | 450.0 | 0.0 | tilted | 0 g
T11 |  | 360 | 0 | 360.0 | 0.0 | vertical | 500 g
Base angle 0° = straight ahead. ±45° keeps well clear of the base home angle, where it can still wobble.
Approaches
Target | Trial | dx (mm) | dy (mm) | Centroid dx | Centroid dy | l = dist. to centroid | (l − mean l)²
ex | 1 | 2.5 | -1
T1 | 1
T1 | 2
T1 | 3
T1 | 4
T1 | 5
T1 | 6
T1 | 7
T1 | 8
T1 | 9
T1 | 10
T2 | 1
T2 | 2
T2 | 3
T2 | 4
T2 | 5
T2 | 6
T2 | 7
T2 | 8
T2 | 9
T2 | 10
T3 | 1
T3 | 2
T3 | 3
T3 | 4
T3 | 5
T3 | 6
T3 | 7
T3 | 8
T3 | 9
T3 | 10
T4 | 1
T4 | 2
T4 | 3
T4 | 4
T4 | 5
T4 | 6
T4 | 7
T4 | 8
T4 | 9
T4 | 10
T5 | 1
T5 | 2
T5 | 3
T5 | 4
T5 | 5
T5 | 6
T5 | 7
T5 | 8
T5 | 9
T5 | 10
T6 | 1
T6 | 2
T6 | 3
T6 | 4
T6 | 5
T6 | 6
T6 | 7
T6 | 8
T6 | 9
T6 | 10
T7 | 1
T7 | 2
T7 | 3
T7 | 4
T7 | 5
T7 | 6
T7 | 7
T7 | 8
T7 | 9
T7 | 10
T8 | 1
T8 | 2
T8 | 3
T8 | 4
T8 | 5
T8 | 6
T8 | 7
T8 | 8
T8 | 9
T8 | 10
T9 | 1
T9 | 2
T9 | 3
T9 | 4
T9 | 5
T9 | 6
T9 | 7
T9 | 8
T9 | 9
T9 | 10
T10 | 1
T10 | 2
T10 | 3
T10 | 4
T10 | 5
T10 | 6
T10 | 7
T10 | 8
T10 | 9
T10 | 10
T11 | 1
T11 | 2
T11 | 3
T11 | 4
T11 | 5
T11 | 6
T11 | 7
T11 | 8
T11 | 9
T11 | 10
Summary
Target | n | Mean dx (mm) | Mean dy (mm) | Accuracy (mm) | Mean l (mm) | Std l (mm) | Repeatability (mm) | Result
T1 | 0 |  |  |  |  |  |  | not done
T2 | 0 |  |  |  |  |  |  | not done
T3 | 0 |  |  |  |  |  |  | not done
T4 | 0 |  |  |  |  |  |  | not done
T5 | 0 |  |  |  |  |  |  | not done
T6 | 0 |  |  |  |  |  |  | not done
T7 | 0 |  |  |  |  |  |  | not done
T8 | 0 |  |  |  |  |  |  | not done
T9 | 0 |  |  |  |  |  |  | not done
T10 | 0 |  |  |  |  |  |  | not done
T11 | 0 |  |  |  |  |  |  | not done
All |  |  |  |  |  |  |  | not done
"All" covers T1–T10 (worst accuracy and worst repeatability). T11 (500 g) shows the sag and is reported separately.

Sheet: 8.7 Cycles
8.7 Pick-and-place cycles (R13; also R1, R3, R14)
Saved JSON sequence in sequence mode, cycle times from the GUI cycle report.
Setup: pick spot ≥ 300 mm from the base axis (R1), place spot at another base angle (both beyond ±25° of base home). Mark both on the mat. Wait times at pick and place ≥ 2 s (base settling).
Success: the cube is picked, carried and released upright within the tolerance below of the place mark. Decide the tolerance before starting.
Runs: 10 cycles with 50 g, 10 with 500 g. Film them. Export the GUI data after each set.
Pass: at least 9 of 10 successful cycles per payload, each within 15 s.
Legend: yellow cells = fill in during the test. Green cells = already measured during bring-up (keep or overwrite). White cells are formulas; do not type in them. The grey example row is not counted.
Place tolerance (mm) |  | 10 | decide before testing
Max cycle time (s) |  | 15
Payload | Cycle | Picked and placed upright (Y/N) | Place error (mm) | Cycle time (s) | Success? | Notes
50 g | ex | Y | 6 | 12.4 | yes
50 g | 1
50 g | 2
50 g | 3
50 g | 4
50 g | 5
50 g | 6
50 g | 7
50 g | 8
50 g | 9
50 g | 10
500 g | 1
500 g | 2
500 g | 3
500 g | 4
500 g | 5
500 g | 6
500 g | 7
500 g | 8
500 g | 9
500 g | 10
Summary
Payload | Cycles done | Successes | Mean time (s) | Max time (s) | Result
50 g | 0 | 0 |  |  | not done
500 g | 0 | 0 |  |  | not done
All |  |  |  |  | not done

Sheet: 8.8 Power & safety
8.8 Power, temperature and safety (R2, R4, R5, R6, R7, Objective 2)
Do the E-stop runs over something soft: the arm drops when servo power is cut.
Full extension (R2): hold 500 g with the arm fully extended for 30 s. Record whether it holds, the sag and the servo case temperatures afterwards.
Rails (R5): multimeter at idle, while holding 500 g extended, and the lowest reading during a fast move. Check the rating limits against each datasheet before testing.
E-stop (R7): press it 10 times during motion. Then one run with the E-stop signal wire to GPIO 41 disconnected: the relay must still cut the servo power.
Fuse (R6): confirm it never blew. Polarity protection and transient suppression: by inspection only (do not reverse the supply).
Legend: yellow cells = fill in during the test. Green cells = already measured during bring-up (keep or overwrite). White cells are formulas; do not type in them. The grey example row is not counted.
Full extension hold (R2)
Quantity | Value | Unit | Note
Held 500 g for 30 s (Y/N)
Sag at the tip |  | mm
Shoulder encoder change |  | °
Elbow encoder change |  | °
Result | not done
Rail voltages (R5)
Rail | Rating min (V) | Rating max (V) | Idle (V) | Holding 500 g extended (V) | Lowest in fast move (V) | Result | Notes
#1 shoulder (DS5180), 8.0 V |  |  | 8.12 |  |  | not done | idle: bring-up 9 Oct 2026
#2 base and elbow (DS3240), 6.7 V |  |  | 6.67 |  |  | not done | idle: bring-up 9 Oct 2026
#3 wrist and gripper (DS3225, MG996R), 6.5 V |  |  | 6.54 |  |  | not done | idle: bring-up 9 Oct 2026
5 V logic |  |  | 5.15 |  |  | not done | idle: bring-up 9 Oct 2026
All rails |  |  |  |  |  | not done
Servo case temperatures
Servo | After 10 cycles (°C) | After 5 min hold extended (°C) | Limit (°C) | Result
Base (DS3240) |  |  | 60 | not done
Shoulder (DS5180) |  |  | 60 | not done
Elbow (DS3240) |  |  | 60 | not done
Wrist (DS3225) |  |  | 60 | not done
Gripper (MG996R) |  |  | 60 | not done
All servos |  |  |  | not done
Limit 60 °C is an assumed safe case temperature for PLA-CF mounts and the servos; change it if you use a datasheet value.
E-stop (R7)
Press | Servo rail after press (V) | 5 V logic stays on (Y/N) | GUI shows E-stop (Y/N) | No restart until Reset (Y/N) | Result |  | Notes
1 |  |  |  |  | not done
2 |  |  |  |  | not done
3 |  |  |  |  | not done
4 |  |  |  |  | not done
5 |  |  |  |  | not done
6 |  |  |  |  | not done
7 |  |  |  |  | not done
8 |  |  |  |  | not done
9 |  |  |  |  | not done
10 |  |  |  |  | not done
signal wire disconnected |  |  | — |  | not done |  | GUI cannot see it with the wire off
All presses |  |  |  |  | not done
Bring-up 9 Oct 2026: with the E-stop pressed the servo rails read 0.01 V and the ESP kept running.
Fuse intact after all tests (Y/N) |  | not done
