NathanSpalding/wdd2-pick-and-place-arm/cad/prints/MotorHousing-Print.stl

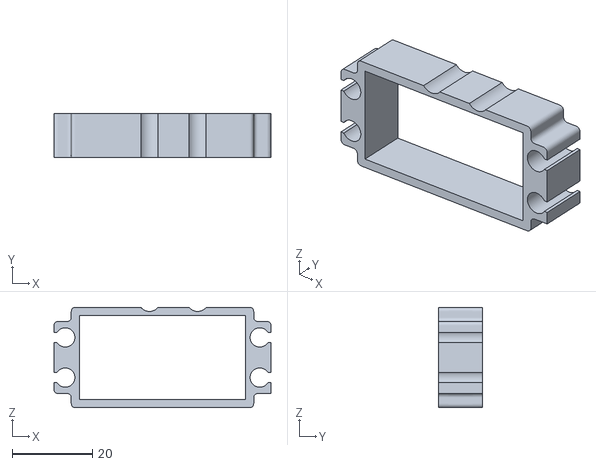
[picture p3: CAD file, 2026-10-21]
cad/prints/MotorHousing-Print.stl
54.1 x 11.0 x 25.0
