NathanSpalding/wdd2-pick-and-place-arm/software/arm_sim/WDD2_URDF_Export_description/meshes/base_link.stl

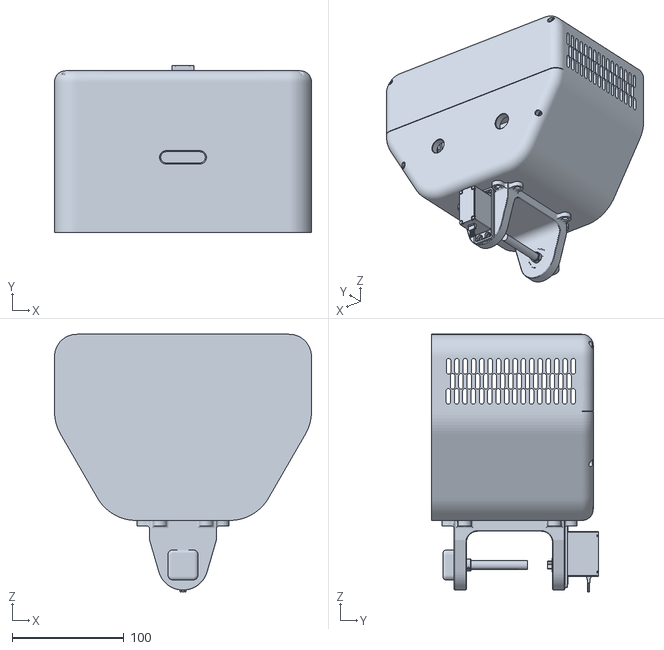
[picture p4: CAD file, 2026-10-21]
software/arm_sim/WDD2_URDF_Export_description/meshes/base_link.stl
230.0 x 149.9 x 230.5
