NathanSpalding/wdd2-pick-and-place-arm/cad/prints/EndPad-Print.stl

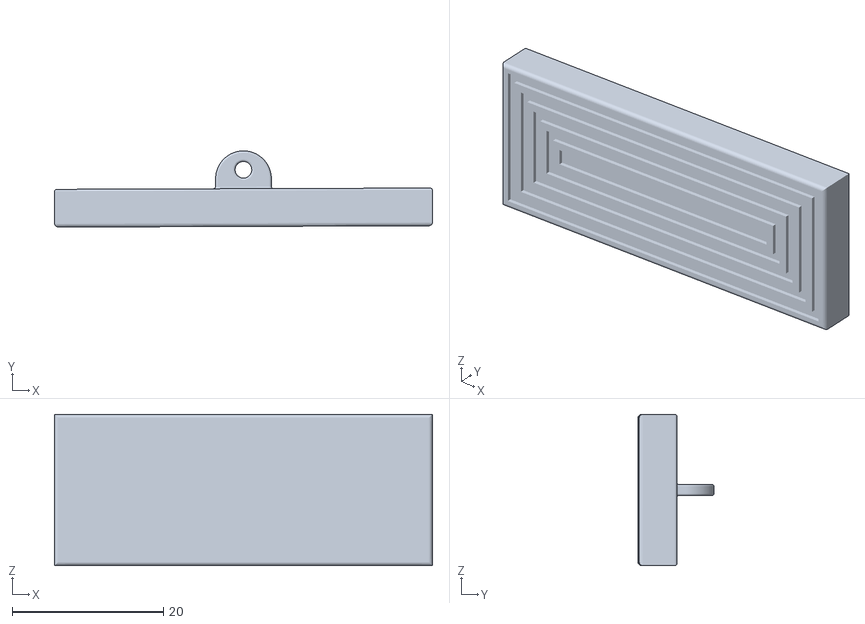
[picture p5: CAD file, 2026-10-21]
cad/prints/EndPad-Print.stl
50.0 x 10.1 x 20.0
