NathanSpalding/wdd2-pick-and-place-arm/software/arm_sim/WDD2_URDF_Export_description/meshes/turntable_link_1.stl

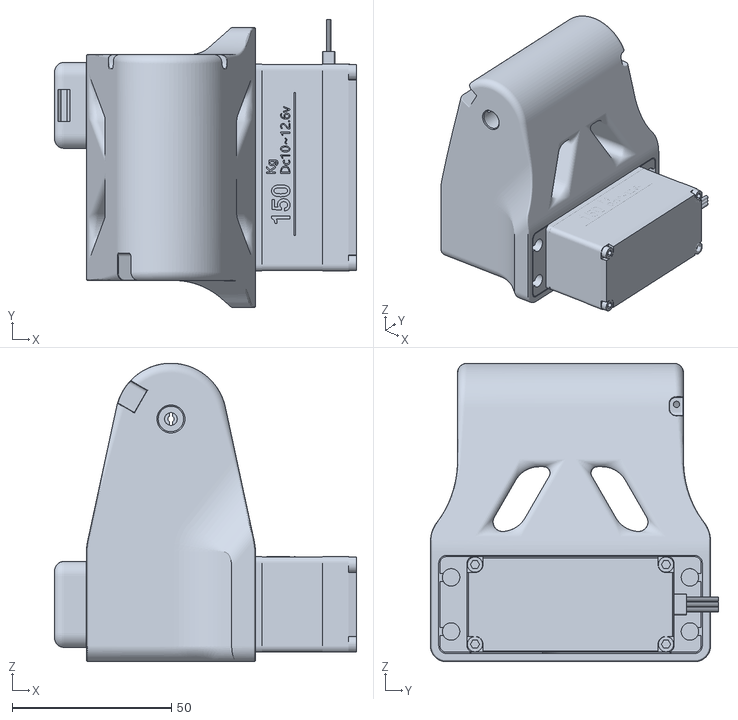
[picture p6: CAD file, 2026-10-21]
software/arm_sim/WDD2_URDF_Export_description/meshes/turntable_link_1.stl
94.8 x 90.5 x 93.7
