NathanSpalding/wdd2-pick-and-place-arm/cad/prints/Part8 - Print.stl

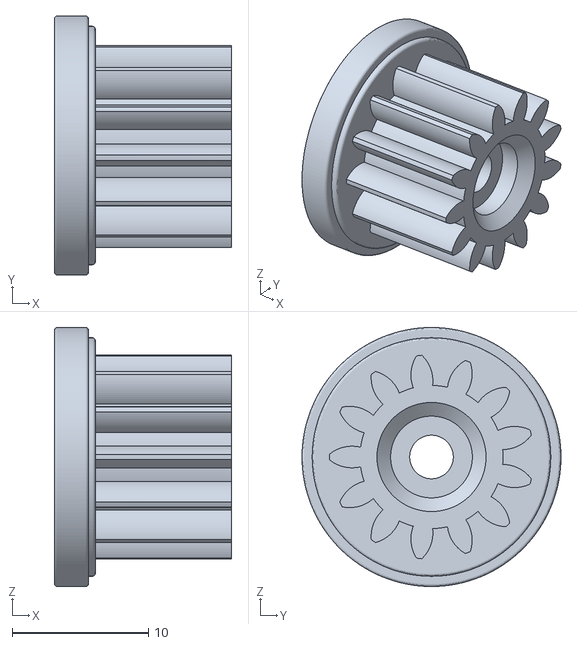
[picture p7: CAD file, 2026-10-21]
cad/prints/Part8 - Print.stl
13.0 x 19.0 x 19.0
