NathanSpalding/wdd2-pick-and-place-arm/software/arm_sim/WDD2_URDF_Export_description/meshes/gripper_link_1.stl

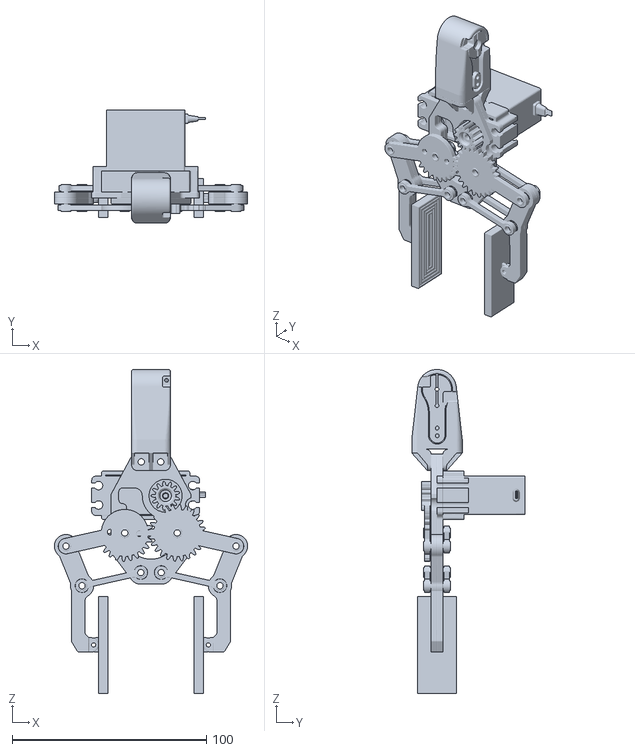
[picture p8: CAD file, 2026-10-21]
software/arm_sim/WDD2_URDF_Export_description/meshes/gripper_link_1.stl
99.5 x 58.4 x 166.7
