NathanSpalding/wdd2-pick-and-place-arm/cad/prints/ElecHousing-print.step

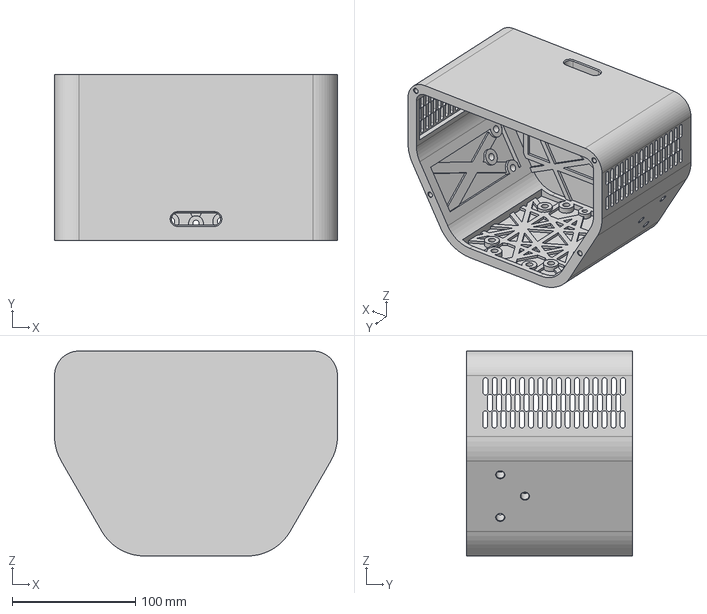
[picture p9: CAD file, 2026-10-21]
cad/prints/ElecHousing-print.step
230.0 x 135.0 x 166.6 mm
