NathanSpalding/wdd2-pick-and-place-arm/software/arm_sim/WDD2_URDF_Export_description/meshes/forearm_link_1.stl

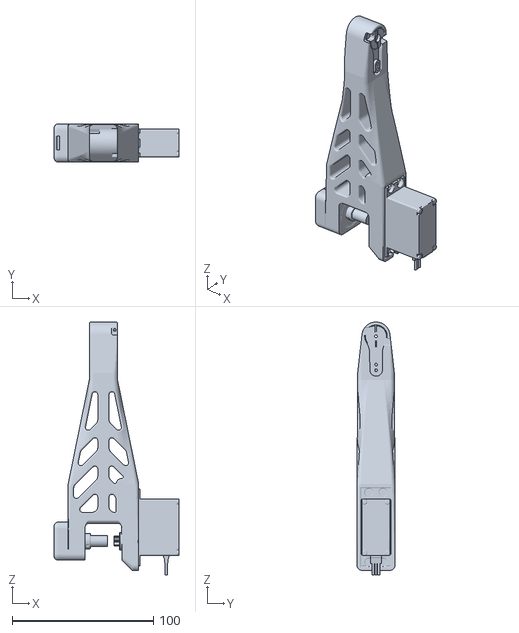
[picture p10: CAD file, 2026-10-21]
software/arm_sim/WDD2_URDF_Export_description/meshes/forearm_link_1.stl
88.5 x 27.0 x 179.1
