NathanSpalding/wdd2-pick-and-place-arm/cad/prints/Base2-Print.stl

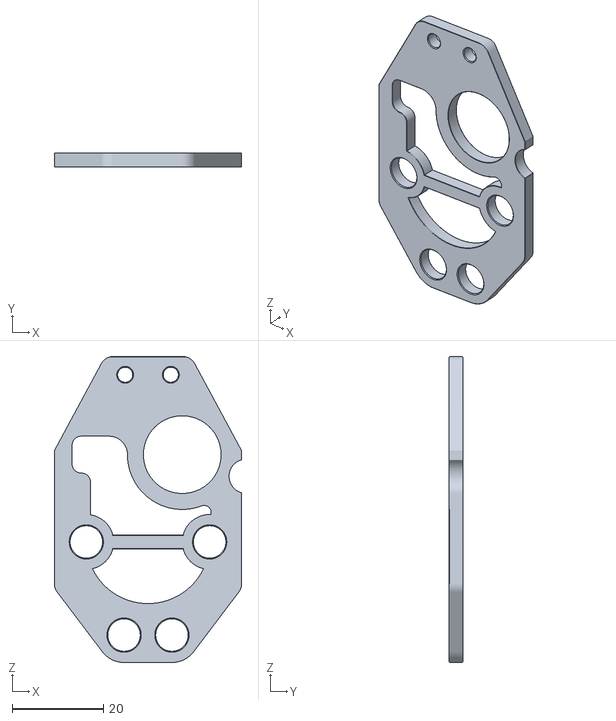
[picture p11: CAD file, 2026-10-21]
cad/prints/Base2-Print.stl
41.0 x 3.00 x 67.0
