NathanSpalding/wdd2-pick-and-place-arm/software/arm_sim/WDD2_URDF_Export_description/meshes/upper_arm_link_1.stl

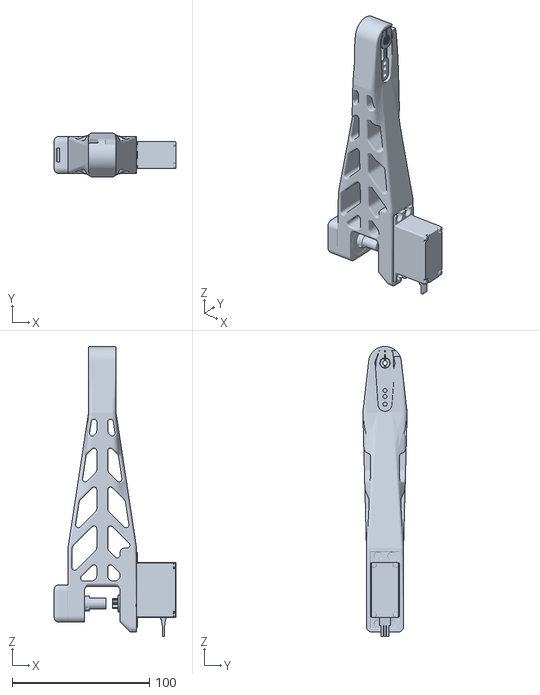
[picture p12: CAD file, 2026-10-21]
software/arm_sim/WDD2_URDF_Export_description/meshes/upper_arm_link_1.stl
88.5 x 32.3 x 211.1
