NathanSpalding/wdd2-pick-and-place-arm/cad/prints/EndPad_Body1_print.stl

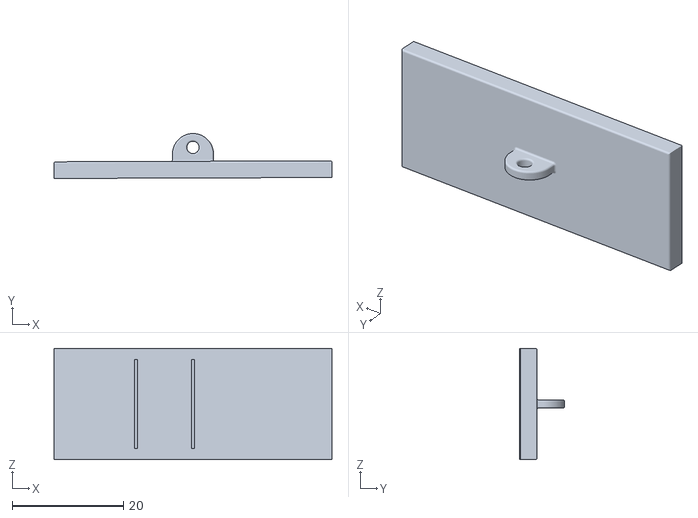
[picture p13: CAD file, 2026-10-21]
cad/prints/EndPad_Body1_print.stl
50.0 x 8.09 x 20.0
