NathanSpalding/wdd2-pick-and-place-arm/cad/prints/EndPad-Body2-Print.stl

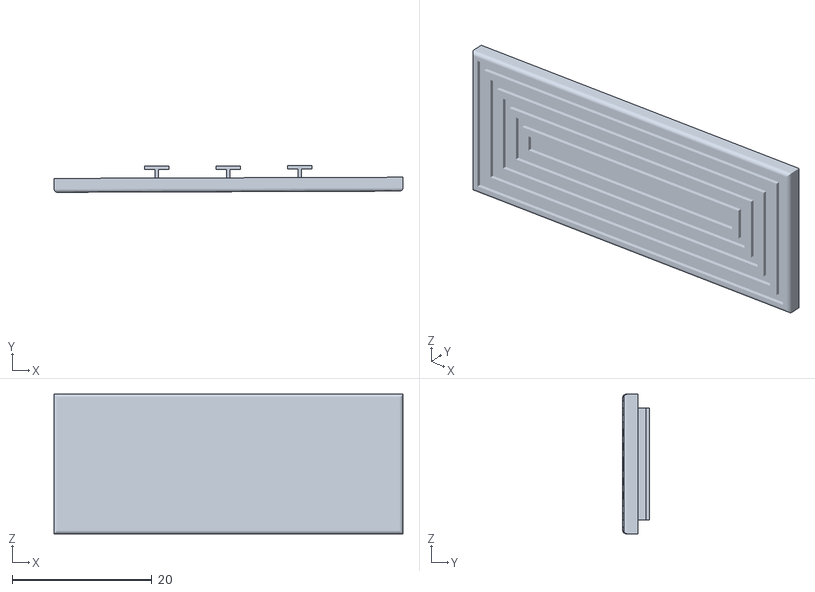
[picture p14: CAD file, 2026-10-21]
cad/prints/EndPad-Body2-Print.stl
50.0 x 3.83 x 20.0
