NathanSpalding/wdd2-pick-and-place-arm/cad/prints/ElecHousing2-print.step

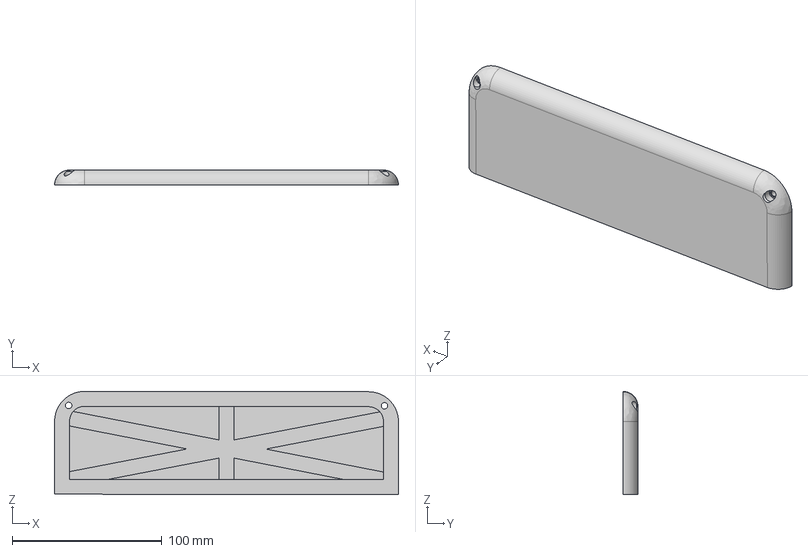
[picture p15: CAD file, 2026-10-21]
cad/prints/ElecHousing2-print.step
230.1 x 10.0 x 69.0 mm
