NathanSpalding/wdd2-pick-and-place-arm/cad/prints/Link-Print.stl

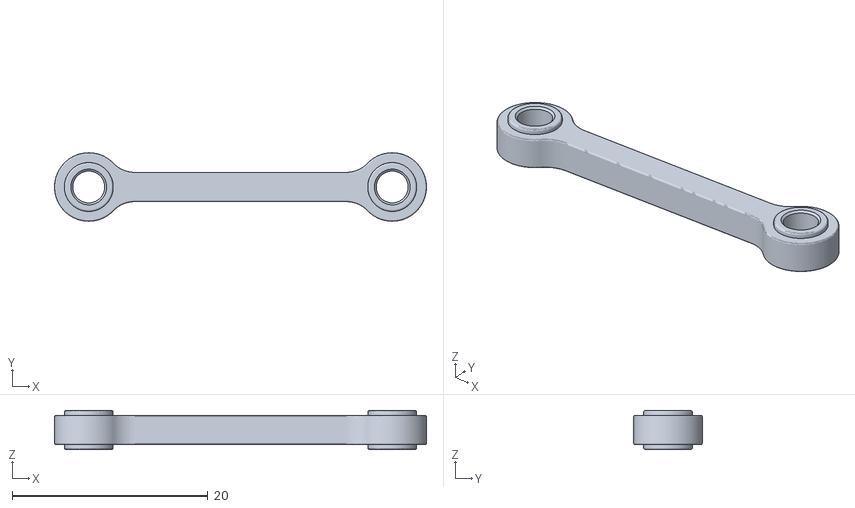
[picture p16: CAD file, 2026-10-21]
cad/prints/Link-Print.stl
38.0 x 7.00 x 4.00
