NathanSpalding/wdd2-pick-and-place-arm/cad/prints/Base1.stp

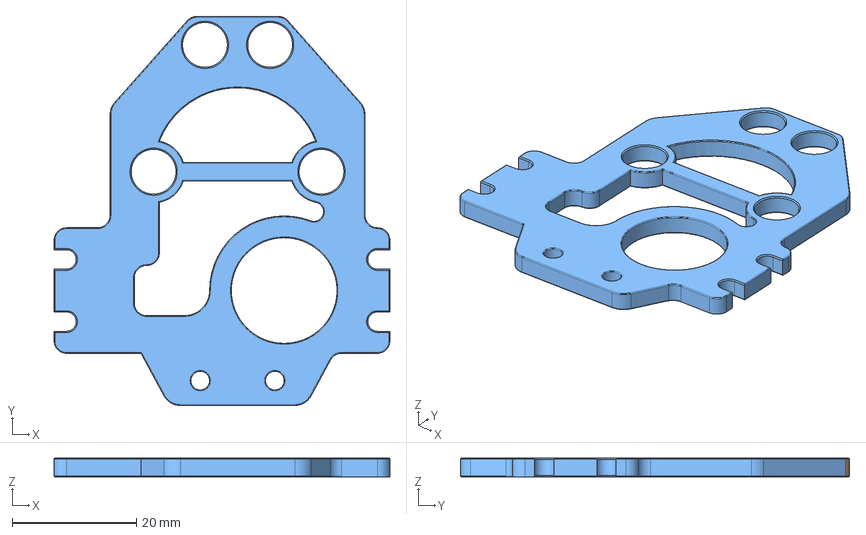
[picture p17: CAD file, 2026-10-21]
cad/prints/Base1.stp
54.0 x 62.6 x 3.00 mm
