NathanSpalding/wdd2-pick-and-place-arm/cad/prints/Part5-1 - ISO - Spur Gear .stp

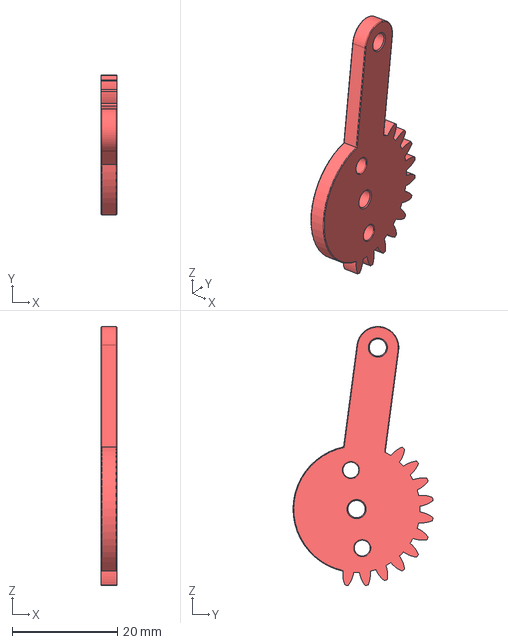
[picture p18: CAD file, 2026-10-21]
cad/prints/Part5-1 - ISO - Spur Gear .stp
3.00 x 26.6 x 49.3 mm
