NathanSpalding/wdd2-pick-and-place-arm/cad/prints/Part5 - ISO - Spur Gear- Print.stl

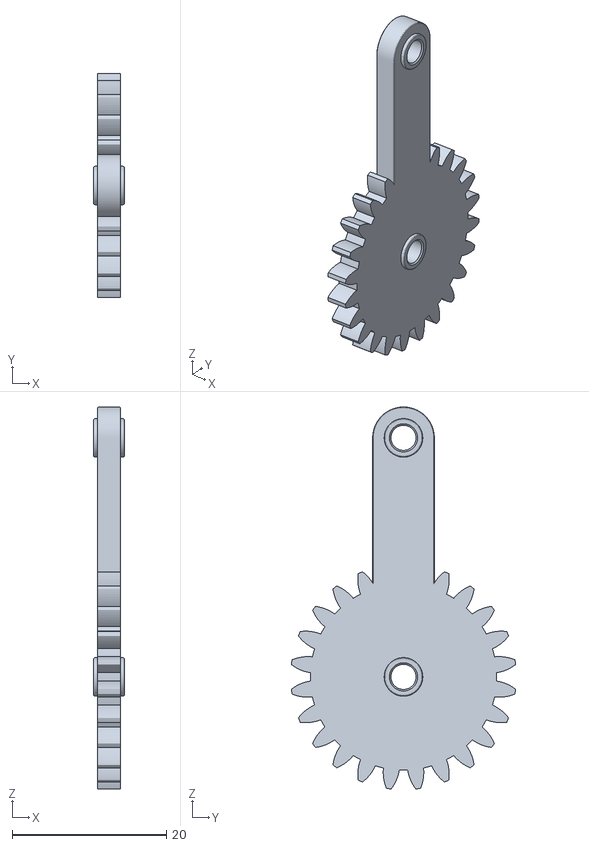
[picture p19: CAD file, 2026-10-21]
cad/prints/Part5 - ISO - Spur Gear- Print.stl
4.00 x 29.1 x 49.5
