NathanSpalding/wdd2-pick-and-place-arm/cad/prints/Part7-Print.stl

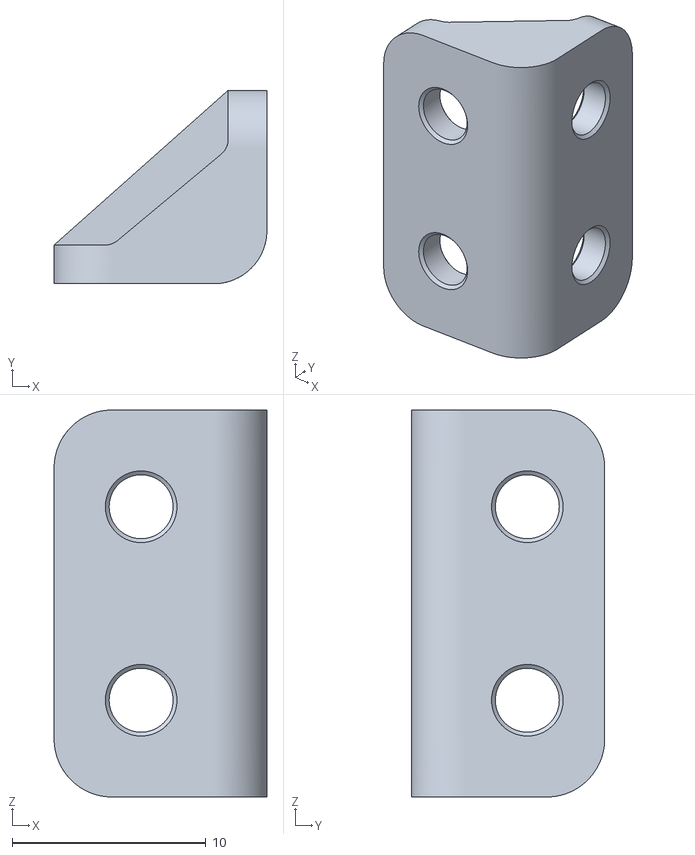
[picture p20: CAD file, 2026-10-21]
cad/prints/Part7-Print.stl
11.0 x 10.0 x 20.0
