NathanSpalding/wdd2-pick-and-place-arm/cad/prints/Wrist-Print.stl

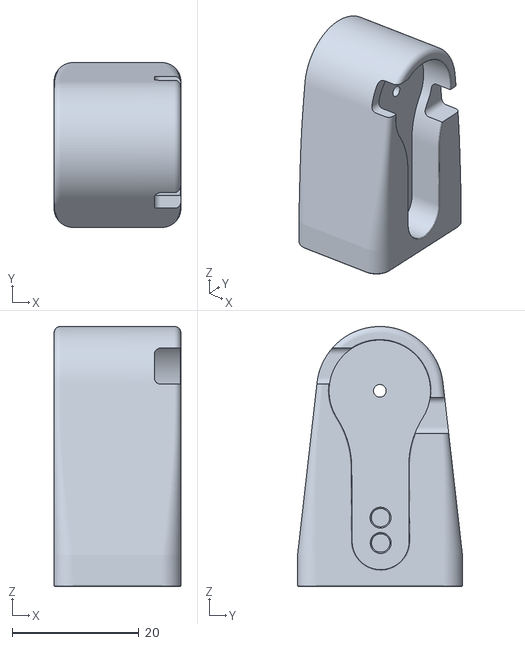
[picture p21: CAD file, 2026-10-21]
cad/prints/Wrist-Print.stl
20.0 x 26.0 x 41.0
