NathanSpalding/wdd2-pick-and-place-arm/cad/prints/SupportLeg_L.step

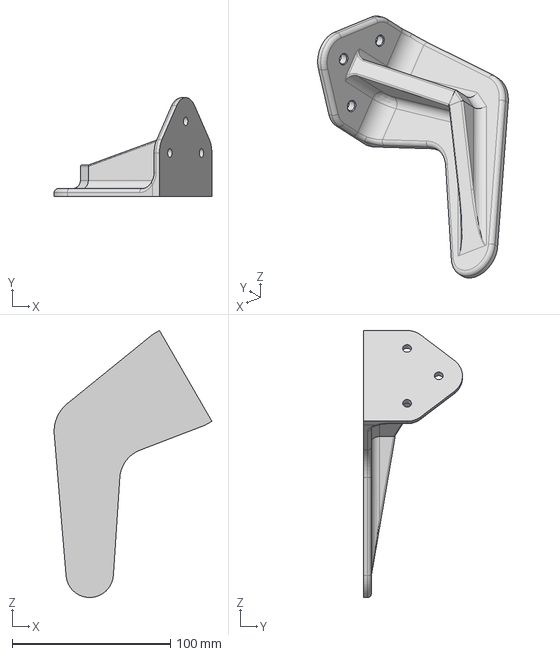
[picture p22: CAD file, 2026-10-21]
cad/prints/SupportLeg_L.step
99.7 x 62.5 x 168.7 mm
