NathanSpalding/wdd2-pick-and-place-arm/cad/prints/AS5600Cover-print.step

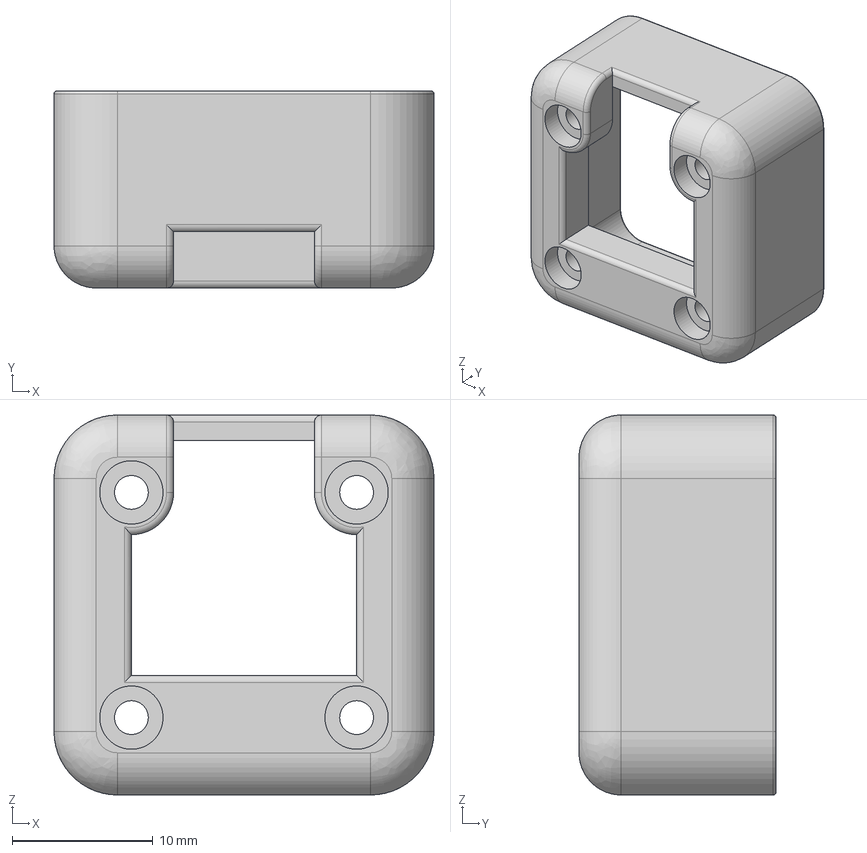
[picture p23: CAD file, 2026-10-21]
cad/prints/AS5600Cover-print.step
27.0 x 14.0 x 27.0 mm
