NathanSpalding/wdd2-pick-and-place-arm/cad/prints/Claw.stp

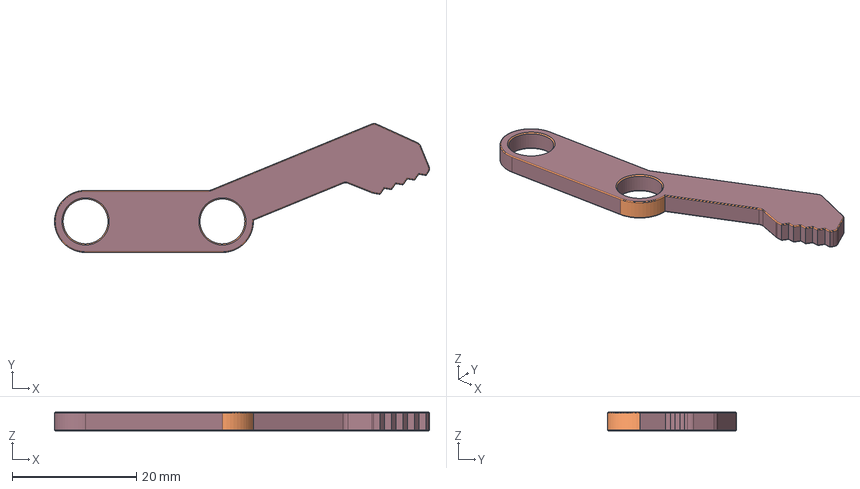
[picture p24: CAD file, 2026-10-21]
cad/prints/Claw.stp
60.3 x 20.7 x 3.00 mm
