NathanSpalding/wdd2-pick-and-place-arm/cad/prints/BaseCoupling-print.step

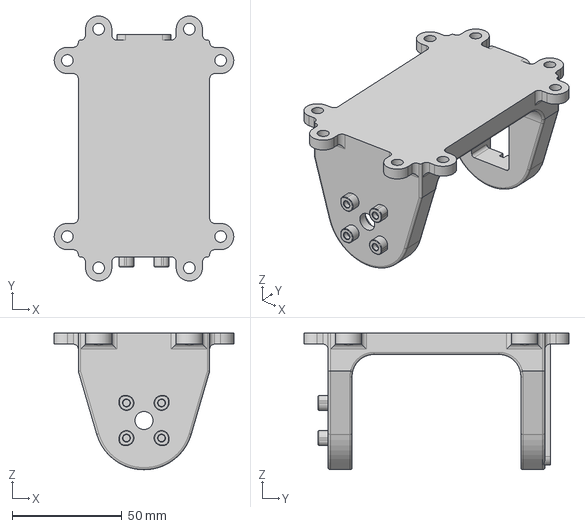
[picture p25: CAD file, 2026-10-21]
cad/prints/BaseCoupling-print.step
82.0 x 121.0 x 62.3 mm
