NathanSpalding/wdd2-pick-and-place-arm/cad/prints/Base1-print1.stl

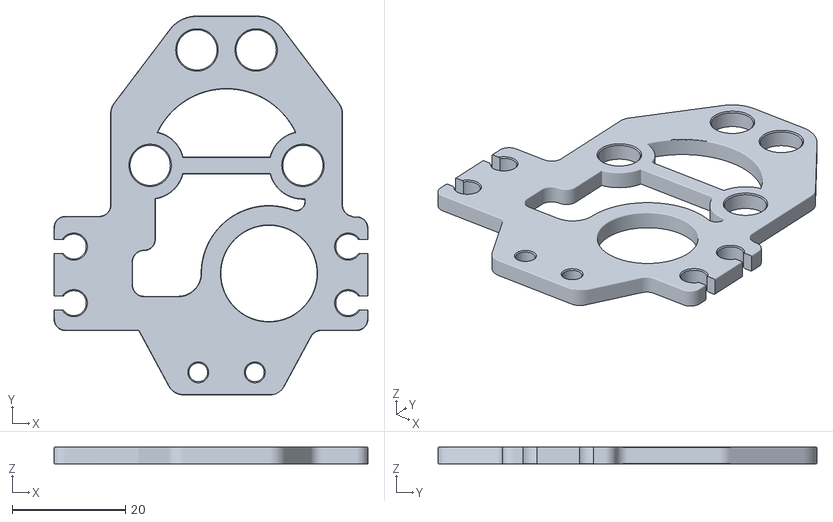
[picture p26: CAD file, 2026-10-21]
cad/prints/Base1-print1.stl
55.5 x 67.0 x 3.00
