NathanSpalding/wdd2-pick-and-place-arm/cad/prints/ElecHousing1-print.step

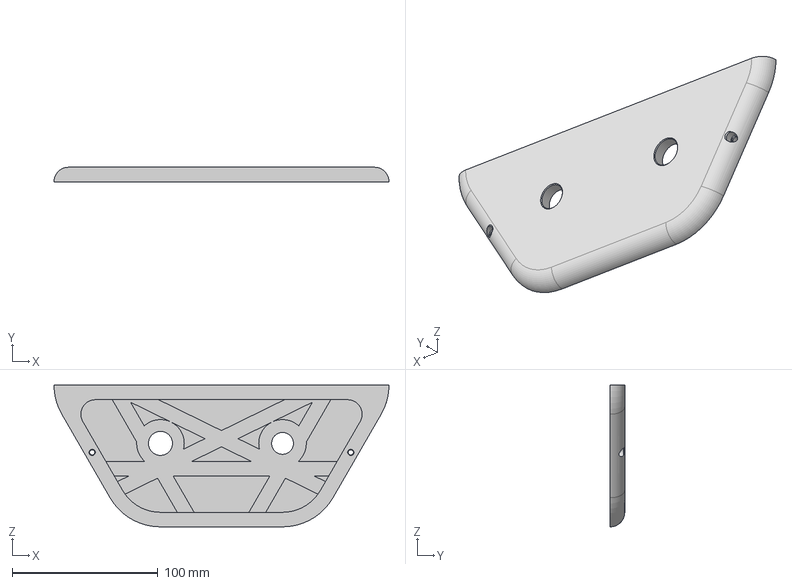
[picture p27: CAD file, 2026-10-21]
cad/prints/ElecHousing1-print.step
230.0 x 10.0 x 97.3 mm
