NathanSpalding/wdd2-pick-and-place-arm/cad/prints/Claw-Print.stl

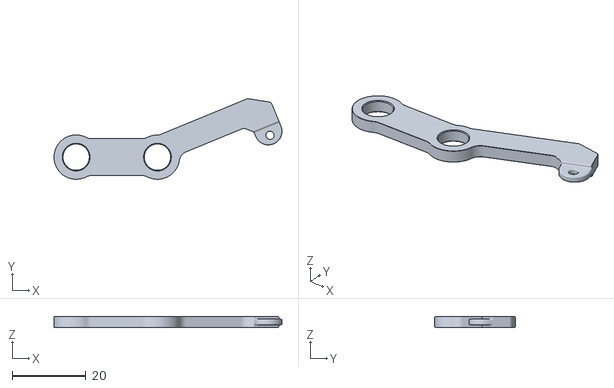
[picture p28: CAD file, 2026-10-21]
cad/prints/Claw-Print.stl
61.7 x 21.8 x 3.00
