NathanSpalding/wdd2-pick-and-place-arm/cad/prints/Pin-Print.stl

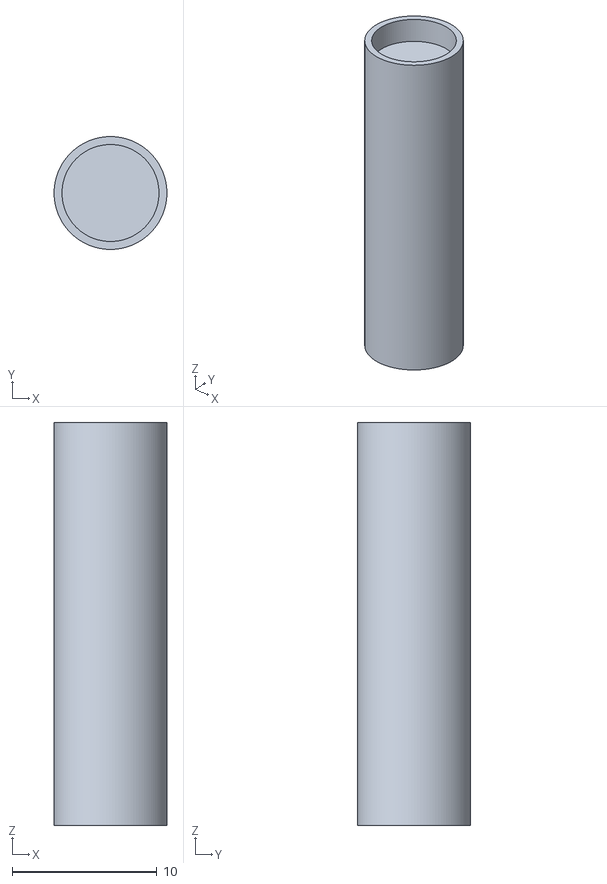
[picture p29: CAD file, 2026-10-21]
cad/prints/Pin-Print.stl
7.80 x 7.80 x 27.9
