NathanSpalding/wdd2-pick-and-place-arm/cad/prints/Link.stp

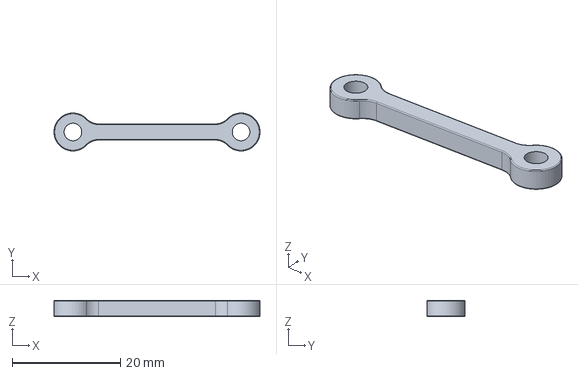
[picture p30: CAD file, 2026-10-21]
cad/prints/Link.stp
38.0 x 6.99 x 3.00 mm
