NathanSpalding/wdd2-pick-and-place-arm/cad/prints/Link2-Print.stl

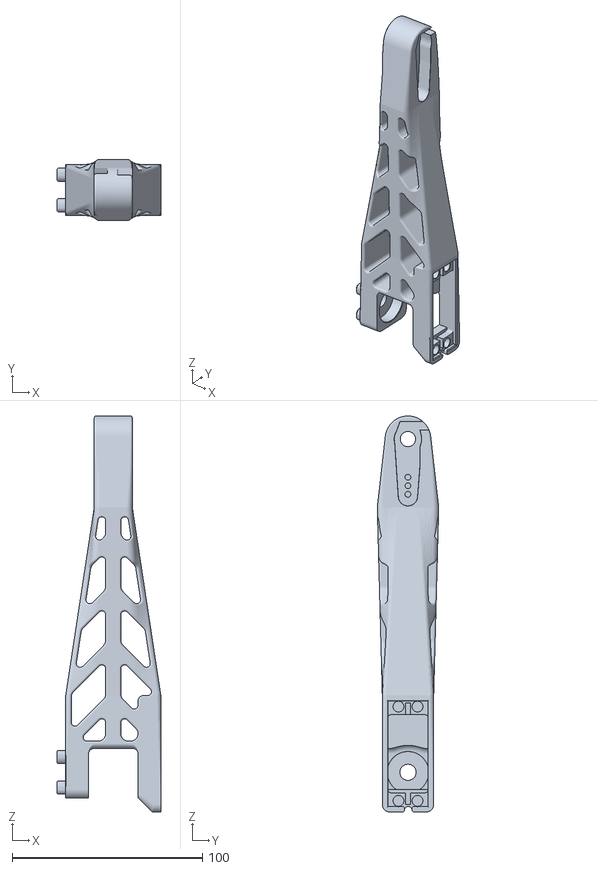
[picture p31: CAD file, 2026-10-21]
cad/prints/Link2-Print.stl
54.5 x 32.3 x 208.0
