NathanSpalding/wdd2-pick-and-place-arm/cad/prints/Part5-1 - ISO - Spur Gear - Print.stl

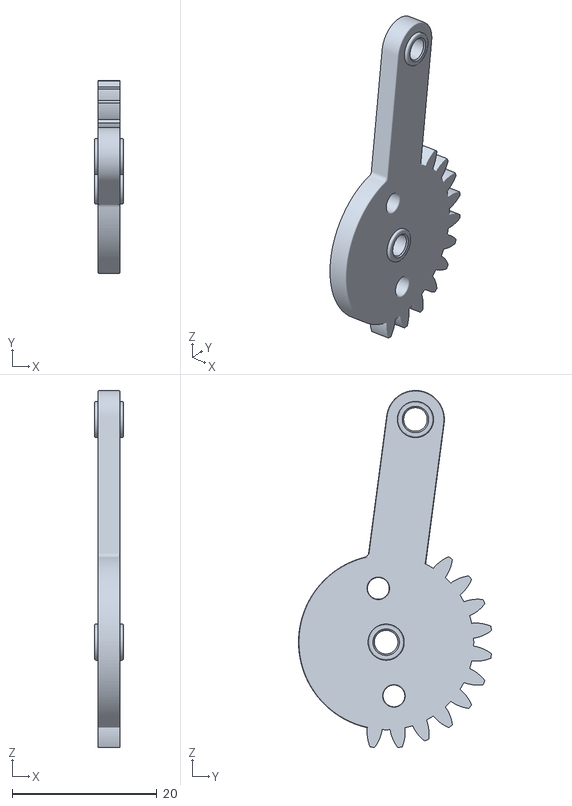
[picture p32: CAD file, 2026-10-21]
cad/prints/Part5-1 - ISO - Spur Gear - Print.stl
4.00 x 26.6 x 49.3
