NathanSpalding/wdd2-pick-and-place-arm/cad/prints/Shoulder-print.step

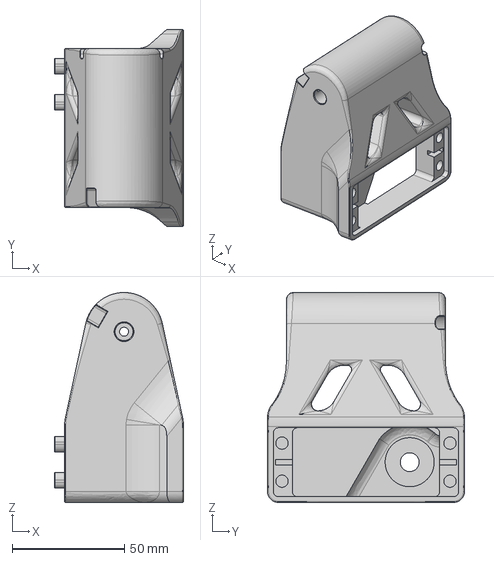
[picture p33: CAD file, 2026-10-21]
cad/prints/Shoulder-print.step
57.6 x 88.0 x 93.7 mm
