NathanSpalding/wdd2-pick-and-place-arm/cad/prints/End.stp

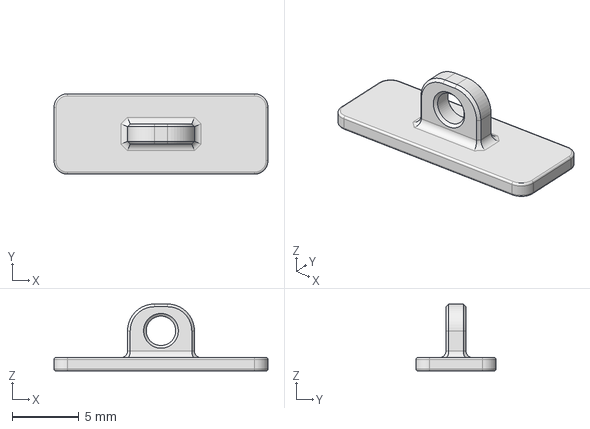
[picture p34: CAD file, 2026-10-21]
cad/prints/End.stp
16.0 x 6.00 x 5.00 mm
