NathanSpalding/wdd2-pick-and-place-arm/cad/prints/Motorhousing.stp

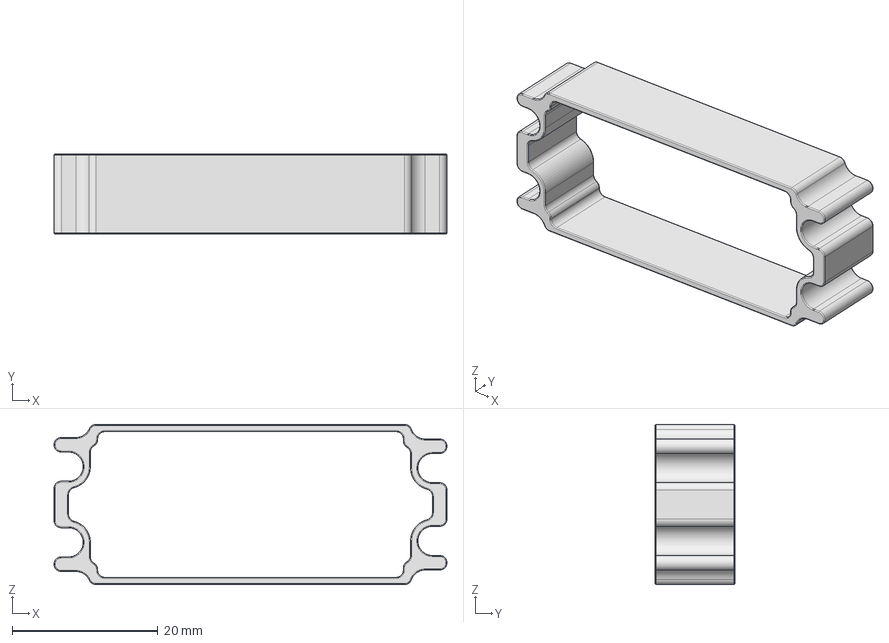
[picture p35: CAD file, 2026-10-21]
cad/prints/Motorhousing.stp
54.0 x 11.0 x 22.0 mm
