NathanSpalding/wdd2-pick-and-place-arm/cad/prints/Base2.stp

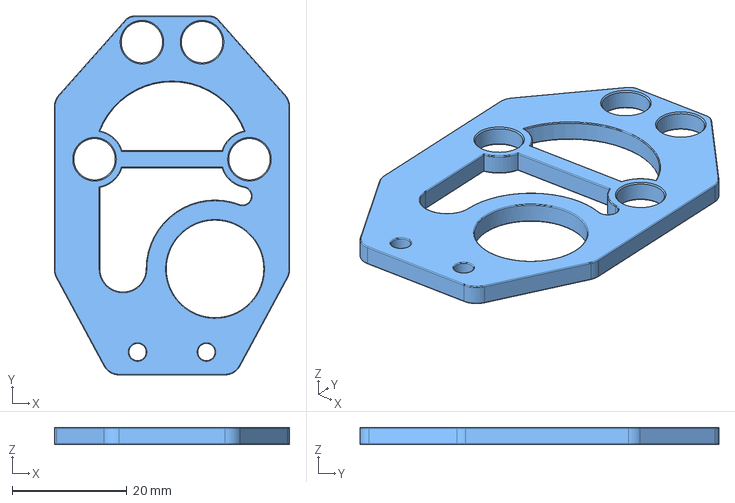
[picture p36: CAD file, 2026-10-21]
cad/prints/Base2.stp
41.0 x 62.6 x 3.00 mm
