NathanSpalding/wdd2-pick-and-place-arm/cad/prints/Link1-Print.stl

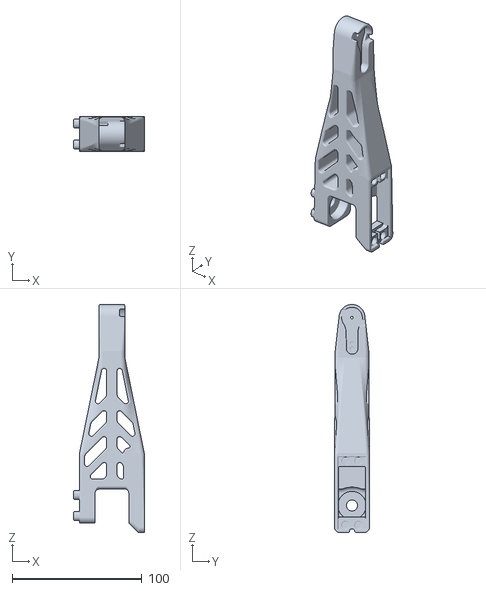
[picture p37: CAD file, 2026-10-21]
cad/prints/Link1-Print.stl
54.5 x 27.0 x 176.0
