NathanSpalding/wdd2-pick-and-place-arm/(list of files, cad)

Other CAD files:
cad/prints/Part8 - ISO - Spur gear 1M 13T 20PA 10FW ---S13A75H50L0.8N.stp
cad/prints/SupportLeg_R.step
cad/fusion/wdd2-pick-and-place-arm.f3z
cad/prints/AS5600Cover-Print.stl
cad/prints/Link (1).stp
