NathanSpalding/wdd2-pick-and-place-arm/test-data/2026-10-12/raw_logs/8.4_step_base_0g.txt

step_base_0g
# test move: shoulder to 30.0 deg at 40 deg/s
# test move: elbow to 0.0 deg at 40 deg/s
# test move: wrist to 0.0 deg at 40 deg/s
# trim loop: base on, shoulder on, elbow on, wrist on
# test move: base to 35.0 deg at 40 deg/s
# telemetry (A and I lines, 1 s E heartbeat): on
E,0
A,34.80,30.23,0.00,0.07
I,0.009
A,34.80,30.23,0.02,0.07
I,0.009
A,34.80,30.23,0.00,0.07
I,0.009
A,34.80,30.23,0.02,0.09
I,0.009
A,34.78,30.23,0.00,0.09
I,0.009
A,34.78,30.23,0.04,0.07
I,0.009
A,34.80,30.23,0.04,0.09
I,0.009
A,34.80,30.23,0.00,0.07
I,0.009
A,34.80,30.23,0.02,0.09
I,0.009
A,34.76,30.23,0.07,0.09
I,0.009
A,34.80,30.23,0.00,0.07
I,0.009
A,34.80,30.23,0.02,0.09
I,0.009
A,34.80,30.23,0.00,0.02
I,0.009
A,34.80,30.23,0.00,0.07
I,0.009
A,34.80,30.23,0.00,0.09
I,0.009
A,34.80,30.23,0.00,0.09
I,0.009
A,34.80,30.23,0.04,0.07
I,0.009
A,34.80,30.23,0.00,0.07
I,0.009
A,34.80,30.23,0.04,0.09
I,0.009
A,34.78,30.23,0.00,0.07
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
# test move: base to 45.0 deg at 180 deg/s
A,34.80,30.23,0.00,0.04
I,0.009
A,34.80,30.23,0.00,0.04
I,0.009
A,34.80,30.23,0.00,0.07
I,0.009
A,34.80,30.23,0.00,0.07
I,0.009
A,34.83,30.23,0.07,0.07
I,0.009
A,35.18,30.28,0.07,0.07
I,0.009
A,35.93,30.32,0.09,0.04
I,0.009
A,37.20,30.34,0.09,0.09
I,0.009
A,38.80,30.32,0.09,0.04
I,0.009
A,40.69,30.30,0.09,0.09
I,0.009
A,42.65,30.21,0.07,0.02
I,0.009
A,44.45,30.15,0.00,0.04
I,0.009
A,45.57,30.06,0.09,0.07
I,0.009
A,46.01,30.06,0.09,0.02
I,0.009
A,45.90,30.08,0.09,0.04
I,0.009
A,45.66,30.15,0.09,0.04
I,0.009
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
I,0.009
A,34.72,30.23,0.09,0.00
I,0.009
A,34.72,30.23,0.09,0.00
I,0.009
A,34.72,30.23,0.09,0.00
I,0.009
A,34.72,30.23,0.09,0.00
I,0.009
A,34.72,30.23,0.09,0.00
I,0.009
A,34.72,30.23,0.09,0.00
I,0.009
A,34.72,30.23,0.09,0.00
I,0.009
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
# telemetry (A and I lines, 1 s E heartbeat): off
