NathanSpalding/wdd2-pick-and-place-arm/test-data/2026-10-12/raw_logs/8.4_step_elbow_0g.txt

step_elbow_0g
# trim loop: base on, shoulder on, elbow on, wrist on
# test move: shoulder to 20.0 deg at 40 deg/s
K,1
# grasp confirmed, median 0.133 A
K,1
# grasp confirmed, median 0.107 A
# telemetry (A and I lines, 1 s E heartbeat): on
E,0
A,41.31,19.64,-0.44,-0.18
I,0.074
A,41.31,19.64,-0.48,-0.18
I,0.072
A,41.31,19.62,-0.46,-0.18
I,0.073
A,41.31,19.67,-0.46,-0.18
I,0.071
A,41.31,19.67,-0.44,-0.18
I,0.073
A,41.31,19.62,-0.48,-0.18
I,0.072
A,41.31,19.62,-0.46,-0.18
I,0.072
A,41.31,19.69,-0.46,-0.18
I,0.074
A,41.31,19.64,-0.44,-0.18
I,0.071
A,41.31,19.60,-0.48,-0.18
I,0.075
A,41.31,19.64,-0.51,-0.18
I,0.131
A,41.31,19.62,-0.48,-0.18
I,0.073
A,41.31,19.69,-0.46,-0.18
I,0.073
A,41.31,19.60,-0.51,-0.18
I,0.072
A,41.31,19.62,-0.46,-0.18
I,0.072
A,41.31,19.64,-0.44,-0.18
I,0.073
A,41.31,19.64,-0.46,-0.18
I,0.139
A,41.31,19.67,-0.44,-0.18
I,0.092
A,41.31,19.69,-0.46,-0.18
I,0.071
A,41.31,19.67,-0.46,-0.18
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
# test move: shoulder to 30.0 deg at 180 deg/s
A,41.31,19.67,-0.44,-0.18
I,0.072
A,41.31,19.64,-0.44,-0.18
I,0.074
A,41.31,19.64,-0.44,-0.18
I,0.072
A,41.31,19.69,-0.44,-0.18
I,0.073
A,41.31,19.64,-0.44,-0.18
I,0.076
A,41.31,19.67,-0.48,-0.18
I,0.072
A,41.31,19.82,-0.66,-0.26
I,0.078
A,41.31,20.13,-0.83,-0.26
I,0.071
A,41.31,20.57,-0.97,-0.35
I,0.072
A,41.31,21.12,-1.05,-0.42
I,0.075
A,41.31,21.71,-1.03,-0.44
I,0.070
A,41.31,22.35,-0.97,-0.35
I,0.072
A,41.31,23.12,-0.86,-0.35
I,0.074
A,41.31,23.91,-0.79,-0.35
I,0.070
A,41.31,24.76,-0.75,-0.35
I,0.075
A,41.31,25.58,-0.57,-0.35
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
I,0.009
A,41.31,29.88,17.69,0.00
I,0.009
A,41.31,29.88,17.73,0.00
I,0.009
A,41.31,29.88,17.75,0.00
I,0.009
A,41.31,29.88,17.84,0.00
I,0.009
A,41.31,29.88,17.86,0.00
I,0.009
A,41.31,29.88,17.93,0.00
I,0.009
A,41.31,29.88,18.02,0.00
I,0.009
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
# telemetry (A and I lines, 1 s E heartbeat): off
