NathanSpalding/wdd2-pick-and-place-arm/test-data/2026-10-12/raw_logs/8.4_step_elbow_500g.txt

step_elbow_500g
# test move: shoulder to 30.0 deg at 40 deg/s
# test move: wrist to 0.0 deg at 40 deg/s
# trim loop: base on, shoulder on, elbow on, wrist on
# test move: elbow to 20.0 deg at 40 deg/s
K,1
# grasp confirmed, median 0.146 A
# telemetry (A and I lines, 1 s E heartbeat): on
E,0
A,41.40,29.44,19.78,-0.18
I,0.115
A,41.40,29.44,19.78,-0.18
I,0.115
A,41.40,29.44,19.78,-0.18
I,0.117
A,41.40,29.44,19.78,-0.18
I,0.118
A,41.40,29.44,19.78,-0.18
I,0.124
A,41.40,29.44,19.78,-0.18
I,0.118
A,41.40,29.44,19.78,-0.18
I,0.119
A,41.40,29.44,19.78,-0.18
I,0.122
A,41.40,29.44,19.78,-0.18
I,0.122
A,41.40,29.44,19.78,-0.18
I,0.121
A,41.40,29.44,19.78,-0.18
I,0.115
A,41.40,29.44,19.78,-0.18
I,0.194
A,41.40,29.44,19.78,-0.18
I,0.120
A,41.40,29.44,19.78,-0.18
I,0.121
A,41.40,29.44,19.78,-0.18
I,0.125
A,41.40,29.44,19.78,-0.18
I,0.116
A,41.40,29.44,19.78,-0.18
I,0.117
A,41.40,29.44,19.78,-0.18
I,0.116
A,41.40,29.44,19.78,-0.18
I,0.119
A,41.40,29.44,19.78,-0.18
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
# test move: elbow to 30.0 deg at 180 deg/s
A,41.40,29.44,19.78,-0.18
I,0.118
A,41.40,29.44,19.78,-0.18
I,0.117
A,41.40,29.44,19.73,-0.18
I,0.126
A,41.40,29.44,19.78,-0.18
I,0.119
A,41.40,29.44,19.82,-0.18
I,0.117
A,41.40,29.44,20.06,-0.18
I,0.126
A,41.40,29.40,20.52,-0.26
I,0.102
A,41.40,29.29,21.27,-0.40
I,0.097
A,41.40,29.18,22.35,-0.53
I,0.114
A,41.40,29.14,23.55,-0.62
I,0.119
A,41.40,29.20,24.81,-0.57
I,0.113
A,41.40,29.31,26.19,-0.51
I,0.114
A,41.40,29.49,27.60,-0.37
I,0.123
A,41.40,29.75,28.72,-0.18
I,0.120
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
I,0.075
A,41.40,28.83,16.11,0.00
I,0.137
A,41.40,28.83,16.17,0.00
I,0.074
A,41.40,28.83,16.26,0.00
I,0.073
A,41.40,28.83,16.46,0.00
I,0.072
A,41.40,28.83,16.66,0.00
I,0.075
A,41.40,28.83,16.79,0.00
I,0.076
A,41.40,28.83,16.98,0.00
I,0.076
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
# telemetry (A and I lines, 1 s E heartbeat): off
