NathanSpalding/wdd2-pick-and-place-arm/test-data/2026-10-12/raw_logs/8.4_step_shoulder_0g.txt

mands: J,b,s,e,w | G,1 | G,0 | S | R | M,j,deg,v test move | D,j,gain damping | Q,j,amp re-settle | O,j[,s] swing | X,j,0/1 trim | V,0/1 telemetry | T timing | P status | H help
E,1
E,0
# E-stop released: servos limp until the next J or R
# WDD2 firmware ready, mode IDLE, telemetry off (V,1 = on)
# commands: J,b,s,e,w | G,1 | G,0 | S | R | M,j,deg,v test move | D,j,gain damping | Q,j,amp re-settle | O,j[,s] swing | X,j,0/1 trim | V,0/1 telemetry | T timing | P status | H help
# WDD2 firmware ready: servos limp until the first J or R
# commands: J,b,s,e,w | G,1 | G,0 | S | R | M,j,deg,v test move | D,j,gain damping | Q,j,amp re-settle | O,j[,s] swing | X,j,0/1 trim | V,0/1 telemetry | T timing | P status | H help
E,0

# armed
# test move: shoulder to 30.0 deg at 40 deg/s
# test move: elbow to 0.0 deg at 40 deg/s
# test move: wrist to 0.0 deg at 40 deg/s
# telemetry (A and I lines, 1 s E heartbeat): on
E,0
A,41.31,29.88,0.02,0.00
I,0.004
A,41.31,29.88,0.04,0.00
I,0.004
A,41.31,29.88,0.04,0.00
I,0.004
A,41.31,29.88,0.00,0.00
I,0.004
A,41.31,29.88,0.02,0.00
I,0.004
A,41.31,29.88,0.04,0.00
I,0.004
A,41.31,29.88,0.02,0.00
I,0.004
A,41.31,29.88,0.02,0.00
I,0.004
A,41.31,29.88,0.02,0.00
I,0.004
A,41.31,29.88,0.02,0.00
I,0.004
A,41.31,29.88,0.02,0.00
I,0.004
A,41.31,29.88,0.04,0.00
I,0.004
A,41.31,29.88,0.07,0.00
I,0.004
A,41.31,29.88,0.04,0.00
I,0.004
A,41.31,29.88,0.04,0.00
I,0.004
A,41.31,29.88,0.02,0.00
I,0.004
A,41.31,29.88,0.00,0.00
I,0.004
A,41.31,29.88,0.07,0.00
I,0.004
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
A,41.31,23.93,0.18,0.00
I,0.004
A,41.31,24.70,0.18,0.00
I,0.004
A,41.31,25.29,0.18,0.00
I,0.004
A,41.31,25.73,0.18,0.00
I,0.004
A,41.31,26.15,0.18,0.00
I,0.004
A,41.31,26.39,0.18,0.00
I,0.004
A,41.31,26.65,0.18,0.00
I,0.004
A,41.31,26.89,0.18,0.00
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
# test move: shoulder to 20.0 deg at 180 deg/s
A,41.31,27.42,0.18,0.00
I,0.004
A,41.31,27.42,0.18,0.00
I,0.004
A,41.31,27.42,0.18,0.00
I,0.004
A,41.31,27.42,0.18,0.00
I,0.004
A,41.31,27.42,0.18,0.00
I,0.004
A,41.31,27.42,0.18,0.00
I,0.004
A,41.31,27.42,0.18,0.00
I,0.004
A,41.31,27.20,0.24,0.00
I,0.004
A,41.31,26.74,0.42,0.00
I,0.004
A,41.31,26.02,0.46,0.00
I,0.004
A,41.31,25.00,0.40,0.00
I,0.004
A,41.31,23.88,0.24,0.00
I,0.004
A,41.31,22.83,0.00,0.00
I,0.004
A,41.31,21.97,-0.09,0.00
I,0.004
A,41.31,21.31,-0.09,0.00
I,0.004
A,41.31,20.87,-0.04,0.00
I,0.004
A,41.31,20.63,0.00,0.00
I,0.004
A,41.31,20.41,0.00,0.00
I,0.004
A,41.31,20.21,0.00,0.00
I,0.004
A,41.31,20.04,0.00,0.00
I,0.004
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
