NathanSpalding/wdd2-pick-and-place-arm/test-data/2026-10-12/raw_logs/8.4_step_wrist_0g.txt

step_wrist_0g
# test move: shoulder to 30.0 deg at 40 deg/s
# test move: elbow to 0.0 deg at 40 deg/s
# trim loop: base on, shoulder on, elbow on, wrist on
# test move: wrist to 20.0 deg at 40 deg/s
# telemetry (A and I lines, 1 s E heartbeat): on
E,0
A,41.40,30.06,0.18,20.17
I,0.009
A,41.40,30.08,0.18,20.19
I,0.009
A,41.40,30.08,0.18,20.21
I,0.009
A,41.40,30.06,0.18,20.15
I,0.009
A,41.40,30.08,0.18,20.17
I,0.009
A,41.40,30.06,0.18,20.19
I,0.009
A,41.40,30.08,0.18,20.17
I,0.009
A,41.40,30.10,0.18,20.15
I,0.009
A,41.40,30.06,0.18,20.21
I,0.009
A,41.40,30.08,0.18,20.17
I,0.009
A,41.40,30.10,0.18,20.19
I,0.009
A,41.40,30.08,0.18,20.21
I,0.009
A,41.40,30.06,0.18,20.21
I,0.009
A,41.40,30.06,0.18,20.21
I,0.009
A,41.40,30.08,0.18,20.19
I,0.009
A,41.40,30.10,0.18,20.19
I,0.009
A,41.40,30.15,0.18,20.21
I,0.009
A,41.40,30.06,0.18,20.21
I,0.009
A,41.40,30.10,0.18,20.21
I,0.009
A,41.40,30.10,0.18,20.19
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
# test move: wrist to 30.0 deg at 180 deg/s
A,41.40,30.08,0.18,20.21
I,0.009
A,41.40,30.08,0.18,20.21
I,0.009
A,41.40,30.10,0.18,20.21
I,0.009
A,41.40,30.08,0.18,20.24
I,0.009
A,41.40,30.08,0.18,20.43
I,0.009
A,41.40,30.08,0.18,20.81
I,0.009
A,41.40,30.08,0.18,21.82
I,0.009
A,41.40,30.06,0.18,23.40
I,0.009
A,41.40,30.06,0.18,25.11
I,0.009
A,41.40,30.12,0.18,26.48
I,0.009
A,41.40,30.15,0.18,27.73
I,0.009
A,41.40,30.10,0.18,28.89
I,0.009
A,41.40,30.12,0.18,29.69
I,0.009
A,41.40,30.10,0.18,29.95
I,0.009
E,0
A,41.40,30.10,0.18,29.97
I,0.009
A,41.40,30.12,0.18,29.97
I,0.009
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
I,0.009
A,41.40,30.15,0.18,19.51
I,0.009
A,41.40,30.15,0.18,19.51
I,0.009
A,41.40,30.15,0.18,19.51
I,0.009
A,41.40,30.15,0.18,19.51
I,0.009
A,41.40,30.15,0.18,19.51
I,0.009
A,41.40,30.15,0.18,19.51
I,0.009
A,41.40,30.15,0.18,19.51
I,0.009
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
# telemetry (A and I lines, 1 s E heartbeat): off
