NathanSpalding/wdd2-pick-and-place-arm/test-data/2026-10-12/raw_logs/8.4_step_wrist_500g.txt

step_wrist_500g
# test move: shoulder to 30.0 deg at 40 deg/s
# test move: elbow to 0.0 deg at 40 deg/s
# trim loop: base on, shoulder on, elbow on, wrist on
# test move: wrist to 20.0 deg at 40 deg/s
K,1
# grasp confirmed, median 0.148 A
# telemetry (A and I lines, 1 s E heartbeat): on
E,0
A,41.33,29.71,-0.15,19.86
I,0.118
A,41.33,29.71,-0.13,19.86
I,0.116
A,41.31,29.71,-0.15,19.86
I,0.124
A,41.31,29.71,-0.13,19.86
I,0.124
A,41.33,29.71,-0.13,19.86
I,0.116
A,41.31,29.71,-0.11,19.86
I,0.119
A,41.31,29.71,-0.13,19.86
I,0.120
A,41.31,29.71,-0.11,19.86
I,0.120
A,41.31,29.71,-0.15,19.86
I,0.119
A,41.31,29.71,-0.15,19.86
I,0.117
A,41.31,29.71,-0.09,19.86
I,0.118
A,41.31,29.71,-0.13,19.86
I,0.121
A,41.31,29.71,-0.15,19.86
I,0.117
A,41.31,29.71,-0.13,19.86
I,0.121
A,41.31,29.71,-0.11,19.86
I,0.118
A,41.31,29.71,-0.11,19.86
I,0.117
A,41.31,29.71,-0.11,19.86
I,0.123
A,41.31,29.71,-0.13,19.86
I,0.120
A,41.31,29.71,-0.15,19.86
I,0.123
A,41.31,29.71,-0.11,19.86
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
# test move: wrist to 30.0 deg at 180 deg/s
A,41.31,29.71,-0.11,19.86
I,0.116
A,41.31,29.71,-0.13,19.86
I,0.114
A,41.31,29.71,-0.11,19.89
I,0.118
A,41.31,29.71,-0.13,20.04
I,0.117
A,41.31,29.71,-0.09,20.24
I,0.119
A,41.31,29.71,-0.13,20.52
I,0.119
A,41.31,29.71,-0.15,21.16
I,0.119
A,41.31,29.66,-0.26,22.52
I,0.110
A,41.31,29.55,-0.35,23.99
I,0.190
A,41.31,29.53,-0.35,25.40
I,0.119
A,41.31,29.55,-0.33,26.65
I,0.119
A,41.33,29.62,-0.22,27.58
I,0.115
A,41.31,29.71,-0.09,28.85
I,0.120
A,41.31,29.71,0.09,29.77
I,0.120
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
I,0.089
A,41.31,30.23,-0.11,18.98
I,0.092
A,41.31,30.23,-0.09,18.98
I,0.094
A,41.31,30.23,-0.09,18.98
I,0.088
A,41.31,30.23,-0.09,18.98
I,0.094
A,41.31,30.23,-0.09,18.98
I,0.091
A,41.31,30.23,-0.09,18.98
I,0.088
A,41.31,30.23,-0.09,18.98
I,0.097
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
# telemetry (A and I lines, 1 s E heartbeat): off
