NathanSpalding/wdd2-pick-and-place-arm/test-data/2026-10-12/csv/8.3_encoder_noise_60s.csv

joint | pose_deg | std_deg | peak_to_peak_deg | one_count_deg | note
base | 30 | 0 | 0.09 | 0.0879 | 12 Oct 2026, 60 s re-run (fixed firmware): std 0.00, p2p 0.00. First run flickered 1 count (0.09), kept as worst case
shoulder | 30 | 0 | 0.09 | 0.0879 | 12 Oct 2026, 60 s re-run (fixed firmware): std 0.00, p2p 0.00. First run flickered 1 count (0.09), kept as worst case
elbow | 0 | 0 | 0 | 0.0879 | 12 Oct 2026, 60 s
wrist | 0 | 0 | 0 | 0.0879 | 12 Oct 2026, 60 s
