NathanSpalding/wdd2-pick-and-place-arm/test-data/2026-10-09_bringup/WDD2_bringup_data_2026-10-09.xlsx

Sheet: Wrist
Wrist (DS3225, 6.5 V), after horn re-seat. Fit: angle = 210.70 + (-0.1361) x pulse; 0 deg at 1548 us; RMS 1.26 deg
Step | Pulse (us) | Measured angle (deg) | Fit angle (deg) | Residual (deg) | Used in fit
1 | 1500 | 6.68 | 6.56 | 0.12 | yes
2 | 1200 | 47.37 | 47.39 | -0.02 | yes
3 | 1100 | 60.29 | 61 | -0.71 | yes
4 | 1000 | 74.09 | 74.61 | -0.52 | yes
5 | 950 | 80.16 | 81.41 | -1.25 | yes
6 | 900 | 88.07 | 88.22 | -0.15 | yes
7 | 875 | 91.67 | 91.62 | 0.05 | yes
8 | 850 | 94.66 | 95.02 | -0.36 | yes
9 | 825 | 99.49 | 98.43 | 1.06 | yes
10 | 1500 | 7.38 | 6.56 | 0.82 | yes
11 | 1800 | -30.76 | -34.27 | 3.51 | yes
12 | 2000 | -60.38 | -61.49 | 1.11 | yes
13 | 2100 | -75.41 | -75.1 | -0.31 | yes
14 | 2200 | -90 | -88.71 | -1.29 | yes
15 | 2150 | -83.94 | -81.9 | -2.04 | yes
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
