NathanSpalding/wdd2-pick-and-place-arm/test-data/2026-10-11_gui-trials/arm_export_20261011_154308.xlsx

Sheet: Summary
Item | Value
Exported | 2026-10-11 15:43:06

Sheet: Data log
time_s | mode | estop | holding_cube | target_x_mm | target_y_mm | target_z_mm | tip_x_mm | tip_y_mm | tip_z_mm | base_cmd_deg | shoulder_cmd_deg | elbow_cmd_deg | wrist_cmd_deg | base_meas_deg | shoulder_meas_deg | elbow_meas_deg | wrist_meas_deg | base_torque_Nm | shoulder_torque_Nm | elbow_torque_Nm | wrist_torque_Nm | base_I_model_A | shoulder_I_model_A | elbow_I_model_A | wrist_I_model_A | gripper_I_model_A | gripper_I_meas_A | I_total_model_A | gripper_angle_deg | angles_source | gripper_current_source
0 | Manual | 0 | 0 | 255.1 | 7.1 | 96.9 | 255.1 | 7.1 | 96.9 | 0 | 72 | -82 | -80 | 0.35 | 72.25 | -82 | -79.98 | 0 | 0.7772 | 0.4871 | 0.013 | 0.15 | 0.6514 | 0.5857 | 0.1622 | 0.009 | 0.004 | 1.5584 | -90 | ESP | ESP
0.021 | Manual | 0 | 0 | 255.1 | 7.1 | 96.9 | 255.1 | 7.1 | 96.9 | 0 | 72 | -82 | -80 | 0.35 | 72.25 | -82 | -79.98 | 0 | 0.7772 | 0.4871 | 0.013 | 0.15 | 0.6514 | 0.5857 | 0.1622 | 0.009 | 0.004 | 1.5584 | -90 | ESP | ESP
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
