NathanSpalding/wdd2-pick-and-place-arm/test-data/2026-10-16_base-ringing/arm_export_20261016_230755.xlsx

Sheet: Summary
Item | Value
Exported | 2026-10-16 23:07:54
Units | positions in mm, angles in degrees, currents in A

Sheet: Data log
time_s | mode | estop | holding_cube | target_x_mm | target_y_mm | target_z_mm | tip_x_mm | tip_y_mm | tip_z_mm | base_cmd_deg | shoulder_cmd_deg | elbow_cmd_deg | wrist_cmd_deg | base_meas_deg | shoulder_meas_deg | elbow_meas_deg | wrist_meas_deg | base_torque_Nm | shoulder_torque_Nm | elbow_torque_Nm | wrist_torque_Nm | base_I_model_A | shoulder_I_model_A | elbow_I_model_A | wrist_I_model_A | gripper_I_model_A | gripper_I_meas_A | I_total_model_A | gripper_angle_deg | angles_source | gripper_current_source
3.02 | Manual | 0 | 0 | 255.1 | 7.1 | 96.9 | 255.1 | 7.1 | 96.9 | 0 | 72 | -82 | -80 | 1.07 | 70.35 | -83.07 | -78.83 | 0 | 0.7772 | 0.4871 | 0.013 | 0.15 | 0.6514 | 0.5857 | 0.1622 | 0.009 | 0.032 | 1.5584 | -90 | fictitious | fictitious
3.646 | Manual | 0 | 0 | 255.1 | 7.1 | 96.9 | 255.1 | 7.1 | 96.9 | 0 | 72 | -82 | -80 | 1.09 | 70.17 | -82.86 | -78.63 | 0 | 0.7772 | 0.4871 | 0.013 | 0.15 | 0.6514 | 0.5857 | 0.1622 | 0.009 | 0.0261 | 1.5584 | -90 | fictitious | fictitious
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
