NathanSpalding/wdd2-pick-and-place-arm/test-data/2026-10-12/csv/8.2_encoder_vs_reference_sweep1.csv

joint | commanded_deg | gauge_this_link_deg | gauge_parent_link_deg | reference_deg | encoder_deg | error_deg | note
base | -60 | -60.2 |  | -60.2 | -59.59 | 0.61
base | -50 | -49.7 |  | -49.7 | -50.19 | -0.49
base | -40 | -39.9 |  | -39.9 | -40.15 | -0.25
base | -30 | -30.2 |  | -30.2 | -30.06 | 0.14 | hunted; touched to settle
base | -20 | -19.7 |  | -19.7 | -20.13 | -0.43 | hunted; touched to settle
base | -10 | -9.9 |  | -9.9 | -10.02 | -0.12 | hunted; touched to settle
base | 0 | 0.2 |  | 0.2 | 0.26 | 0.06 | hunted; touched to settle
base | 10 | 9.8 |  | 9.8 | 9.93 | 0.13 | hunted; touched to settle
base | 20 | 19.8 |  | 19.8 | 19.61 | -0.19 | hunted; touched to settle
base | 30 | 29.7 |  | 29.7 | 29.79 | 0.09 | hunted; touched to settle
base | 40 | 40.2 |  | 40.2 | 40.08 | -0.12
base | 50 | 49.8 |  | 49.8 | 50.01 | 0.21
base | 60 | 60.1 |  | 60.1 | 60.03 | -0.07
shoulder | -30 | -29.6 |  | -29.6 | -29.97 | -0.37
shoulder | -20 | -20.4 |  | -20.4 | -20.31 | 0.09
shoulder | -10 | -9.8 |  | -9.8 | -9.76 | 0.04
shoulder | 0 | 0.5 |  | 0.5 | 0.22 | -0.28
shoulder | 10 | 10.3 |  | 10.3 | 10.64 | 0.34
shoulder | 20 | 19.8 |  | 19.8 | 19.92 | 0.12
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
