NathanSpalding/wdd2-pick-and-place-arm/test-data/2026-10-12/csv/8.4_timeseries_base_0g.csv

t_s | base_deg | shoulder_deg | elbow_deg | wrist_deg | gripper_A | event
0.0 | 34.80 | 30.23 | 0.00 | 0.07 |  | test move: shoulder to 30.0 deg at 40 deg/s | test move: elbow to 0.0 deg at 40 deg/s | test move: wrist to 0.0 deg at 40 deg/s | trim loop: base on, shoulder on, elbow on, wrist on | test move: base to 35.0 deg at 40 deg/s | telemetry (A and I lines, 1 s E heartbeat): on
0.02 | 34.80 | 30.23 | 0.02 | 0.07 | 0.009
0.04 | 34.80 | 30.23 | 0.00 | 0.07 | 0.009
0.06 | 34.80 | 30.23 | 0.02 | 0.09 | 0.009
0.08 | 34.78 | 30.23 | 0.00 | 0.09 | 0.009
0.1 | 34.78 | 30.23 | 0.04 | 0.07 | 0.009
0.12 | 34.80 | 30.23 | 0.04 | 0.09 | 0.009
0.14 | 34.80 | 30.23 | 0.00 | 0.07 | 0.009
0.16 | 34.80 | 30.23 | 0.02 | 0.09 | 0.009
0.18 | 34.76 | 30.23 | 0.07 | 0.09 | 0.009
0.2 | 34.80 | 30.23 | 0.00 | 0.07 | 0.009
0.22 | 34.80 | 30.23 | 0.02 | 0.09 | 0.009
0.24 | 34.80 | 30.23 | 0.00 | 0.02 | 0.009
0.26 | 34.80 | 30.23 | 0.00 | 0.07 | 0.009
0.28 | 34.80 | 30.23 | 0.00 | 0.09 | 0.009
0.3 | 34.80 | 30.23 | 0.00 | 0.09 | 0.009
0.32 | 34.80 | 30.23 | 0.04 | 0.07 | 0.009
0.34 | 34.80 | 30.23 | 0.00 | 0.07 | 0.009
0.36 | 34.80 | 30.23 | 0.04 | 0.09 | 0.009
0.38 | 34.78 | 30.23 | 0.00 | 0.07 | 0.009
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
