NathanSpalding/wdd2-pick-and-place-arm/test-data/2026-10-12/csv/8.4_timeseries_elbow_0g.csv

t_s | base_deg | shoulder_deg | elbow_deg | wrist_deg | gripper_A | event
0.0 | 41.31 | 19.64 | -0.44 | -0.18 |  | trim loop: base on, shoulder on, elbow on, wrist on | test move: shoulder to 20.0 deg at 40 deg/s | K,1 | grasp confirmed, median 0.133 A | K,1 | grasp confirmed, median 0.107 A | telemetry (A and I lines, 1 s E heartbeat): on
0.02 | 41.31 | 19.64 | -0.48 | -0.18 | 0.074
0.04 | 41.31 | 19.62 | -0.46 | -0.18 | 0.072
0.06 | 41.31 | 19.67 | -0.46 | -0.18 | 0.073
0.08 | 41.31 | 19.67 | -0.44 | -0.18 | 0.071
0.1 | 41.31 | 19.62 | -0.48 | -0.18 | 0.073
0.12 | 41.31 | 19.62 | -0.46 | -0.18 | 0.072
0.14 | 41.31 | 19.69 | -0.46 | -0.18 | 0.072
0.16 | 41.31 | 19.64 | -0.44 | -0.18 | 0.074
0.18 | 41.31 | 19.60 | -0.48 | -0.18 | 0.071
0.2 | 41.31 | 19.64 | -0.51 | -0.18 | 0.075
0.22 | 41.31 | 19.62 | -0.48 | -0.18 | 0.131
0.24 | 41.31 | 19.69 | -0.46 | -0.18 | 0.073
0.26 | 41.31 | 19.60 | -0.51 | -0.18 | 0.073
0.28 | 41.31 | 19.62 | -0.46 | -0.18 | 0.072
0.3 | 41.31 | 19.64 | -0.44 | -0.18 | 0.072
0.32 | 41.31 | 19.64 | -0.46 | -0.18 | 0.073
0.34 | 41.31 | 19.67 | -0.44 | -0.18 | 0.139
0.36 | 41.31 | 19.69 | -0.46 | -0.18 | 0.092
0.38 | 41.31 | 19.67 | -0.46 | -0.18 | 0.071
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
