NathanSpalding/wdd2-pick-and-place-arm/electronics/schematic_redrawn.pdf

## 1. Supply and power input

## 3. Servo rails

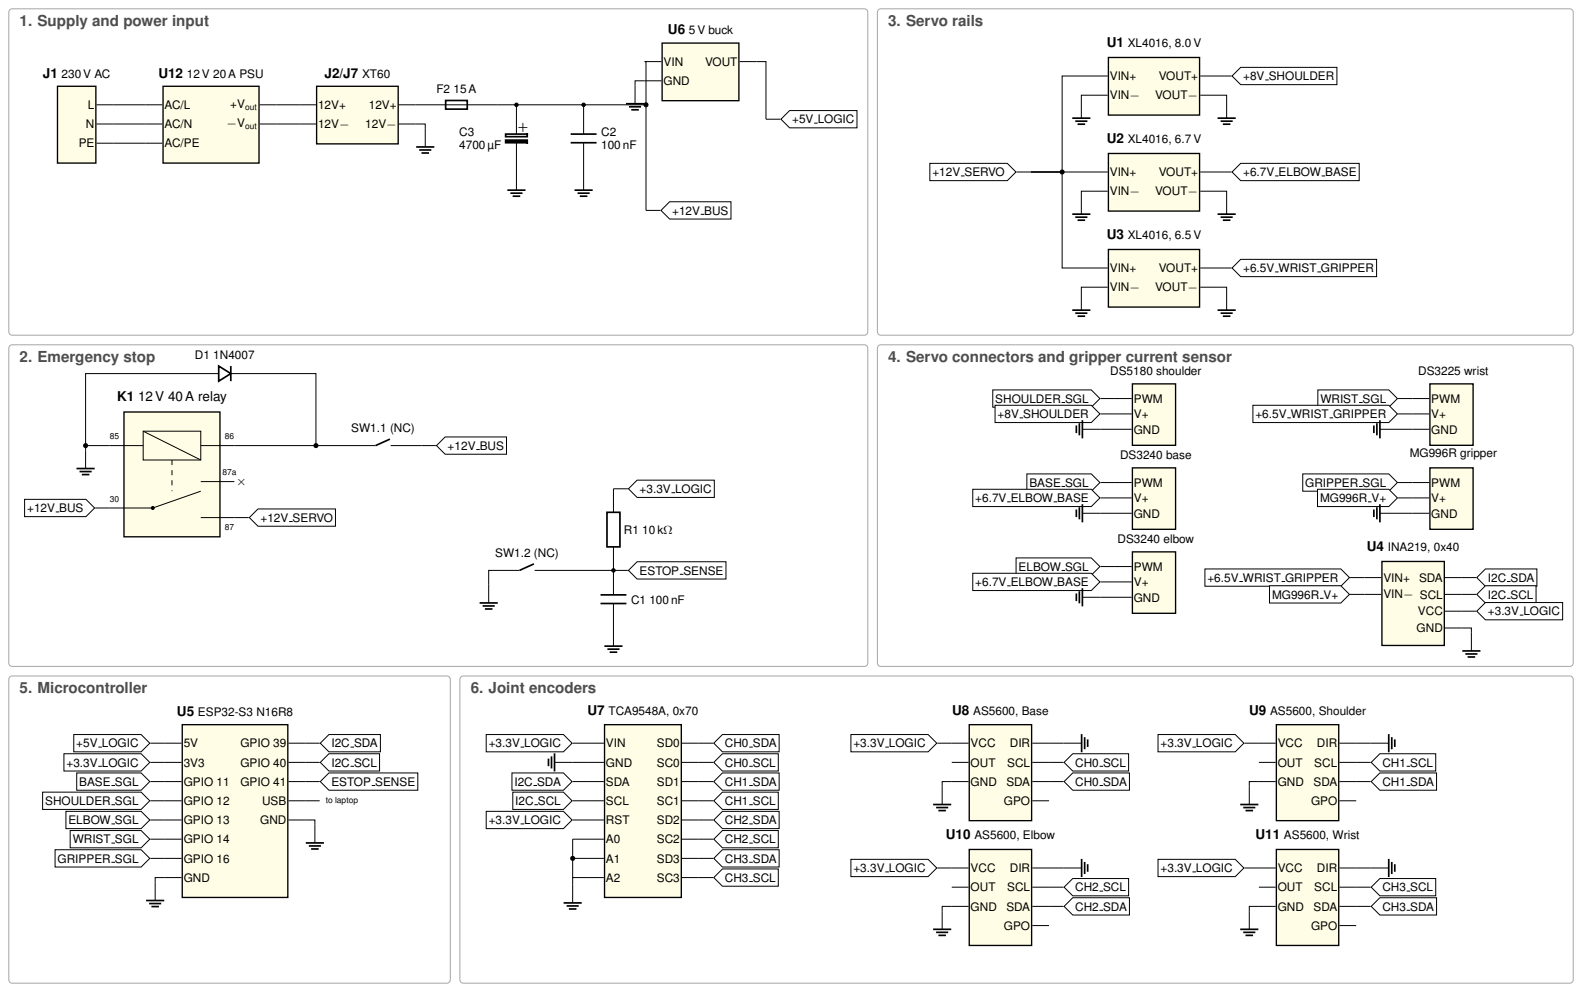
[picture p38: page 1]

4. Servo connectors and gripper current sensor
