NathanSpalding/wdd2-pick-and-place-arm/test-data/2026-10-12/WDD2_target_mat_A4x4.pdf

T1

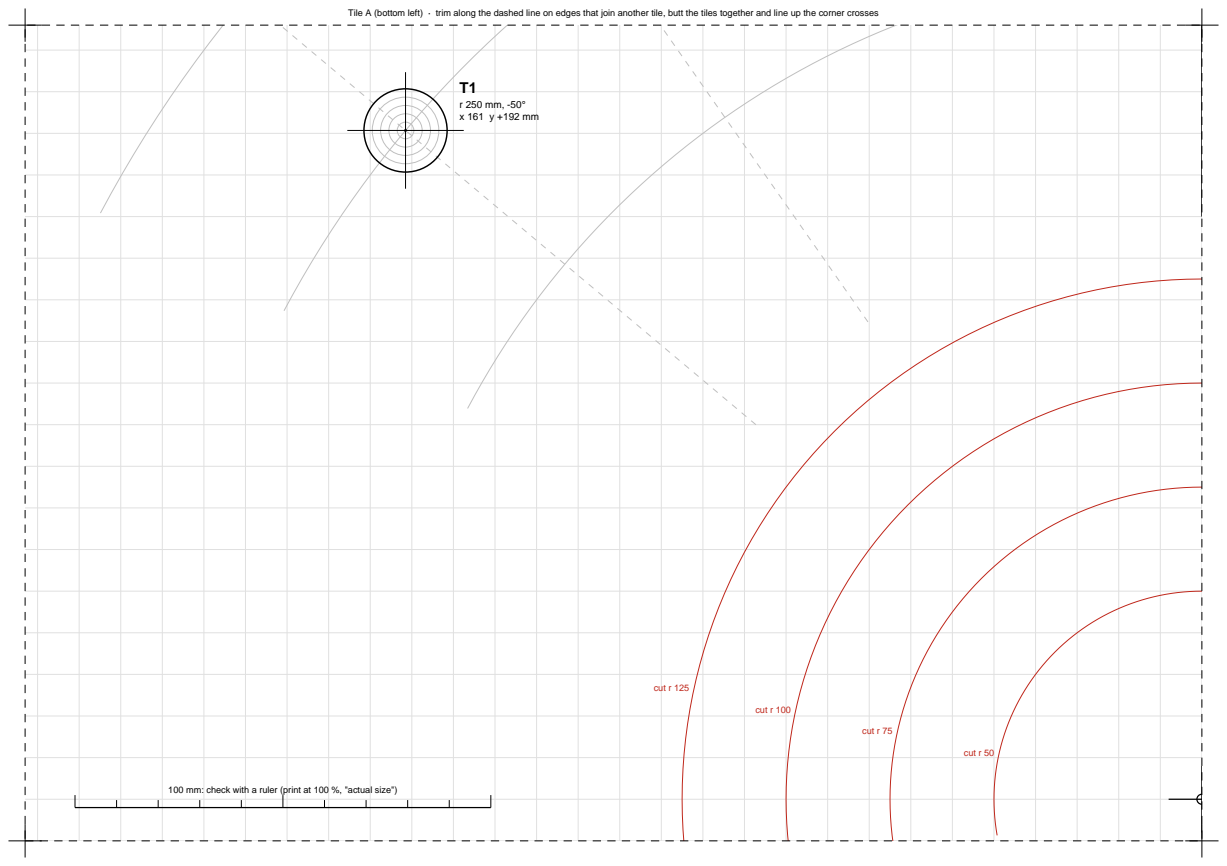
[picture p39: page 1]
BASE AXIS; cut r 50; cut r 75; cut r 100; cut r 125

Tile A (bottom left) · trim along the dashed line on edges that join another tile, butt the tiles together and line up the corner crosses

100 mm: check with a ruler (print at 100 %, "actual size")

T4

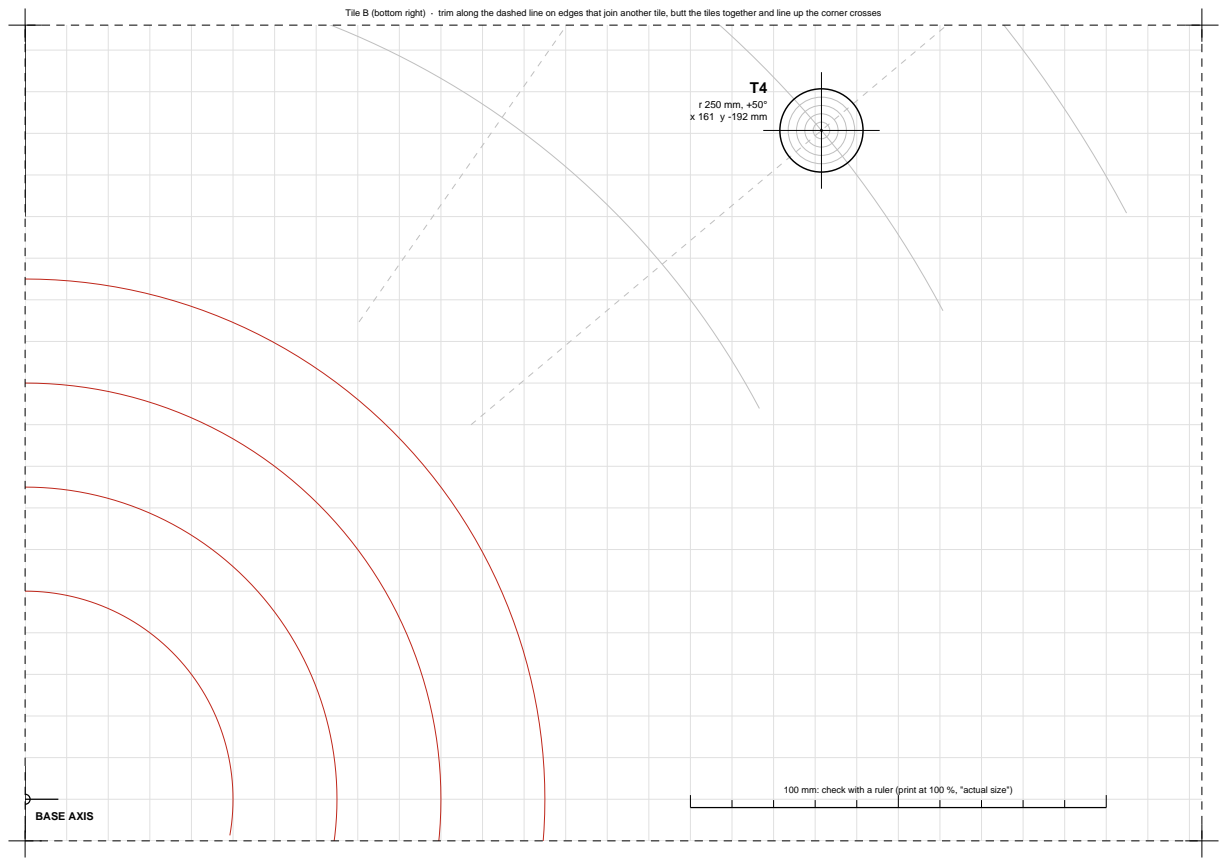
[picture p40: page 2]
BASE AXIS

Tile B (bottom right) · trim along the dashed line on edges that join another tile, butt the tiles together and line up the corner crosses

100 mm: check with a ruler (print at 100 %, "actual size")

# WDD2 target mat: test 8.6 (accuracy and repeatability)

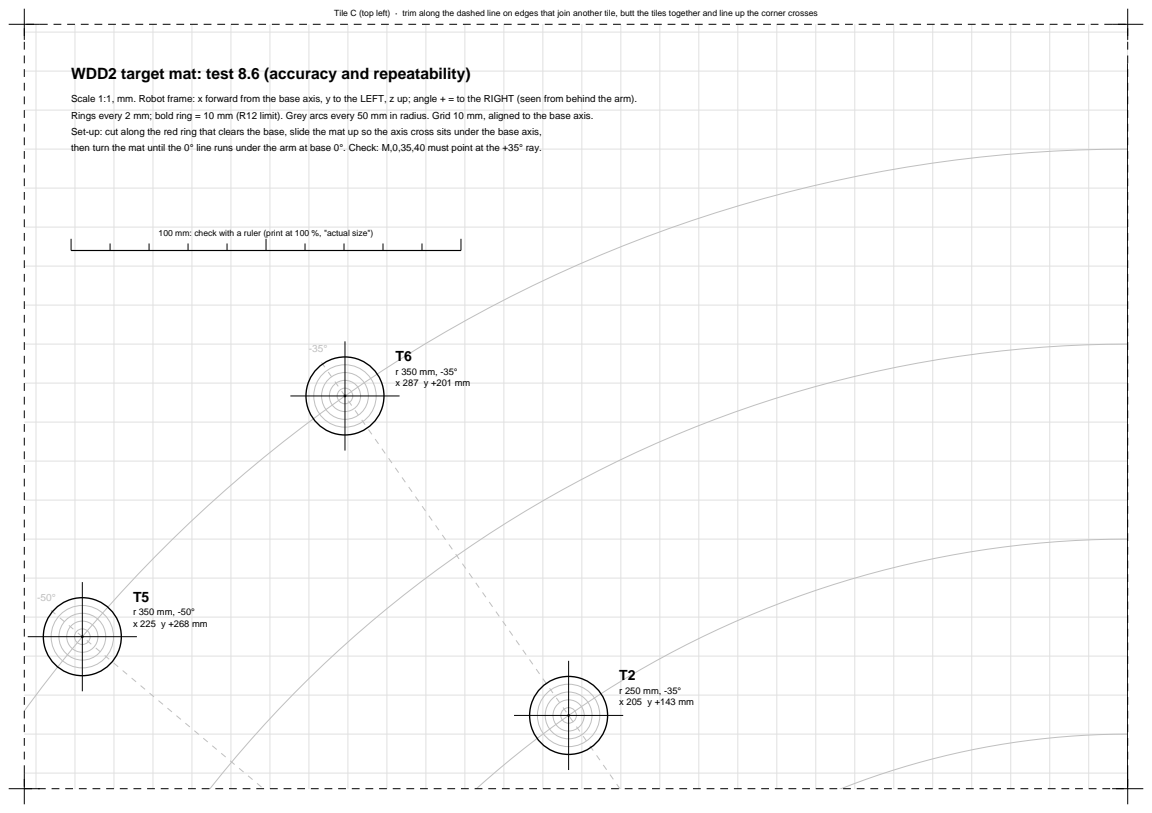
[picture p41: page 3]

Tile C (top left) · trim along the dashed line on edges that join another tile, butt the tiles together and line up the corner crosses

Scale 1:1, mm. Robot frame: x forward from the base axis, y to the LEFT, z up; angle + = to the RIGHT (seen from behind the arm).
Rings every 2 mm; bold ring = 10 mm (R12 limit). Grey arcs every 50 mm in radius. Grid 10 mm, aligned to the base axis.
Set-up: cut along the red ring that clears the base, slide the mat up so the axis cross sits under the base axis,
then turn the mat until the 0° line runs under the arm at base 0°. Check: M,0,35,40 must point at the +35° ray.

0° (arm straight forward)

100 mm: check with a ruler (print at 100 %, "actual size")

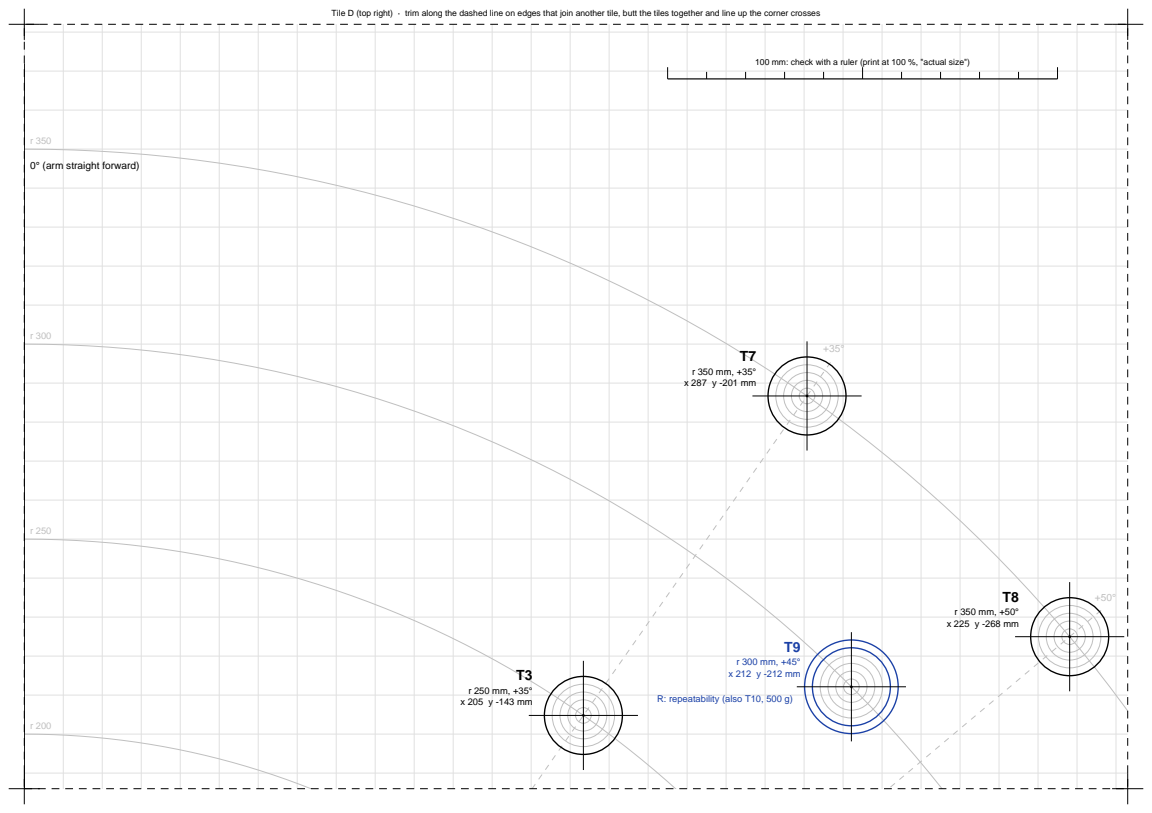
[picture p42: page 4]
R: repeatability (also T10, 500 g)

Tile D (top right) · trim along the dashed line on edges that join another tile, butt the tiles together and line up the corner crosses

100 mm: check with a ruler (print at 100 %, "actual size")

0° (arm straight forward)
