NathanSpalding/wdd2-pick-and-place-arm/electronics/schematic/wdd2-pick-and-place-schematic/wdd2-pick-and-place-schematic.kicad_pcb

## KiCad design DroneFlightController/DroneFlightController.kicad_sch

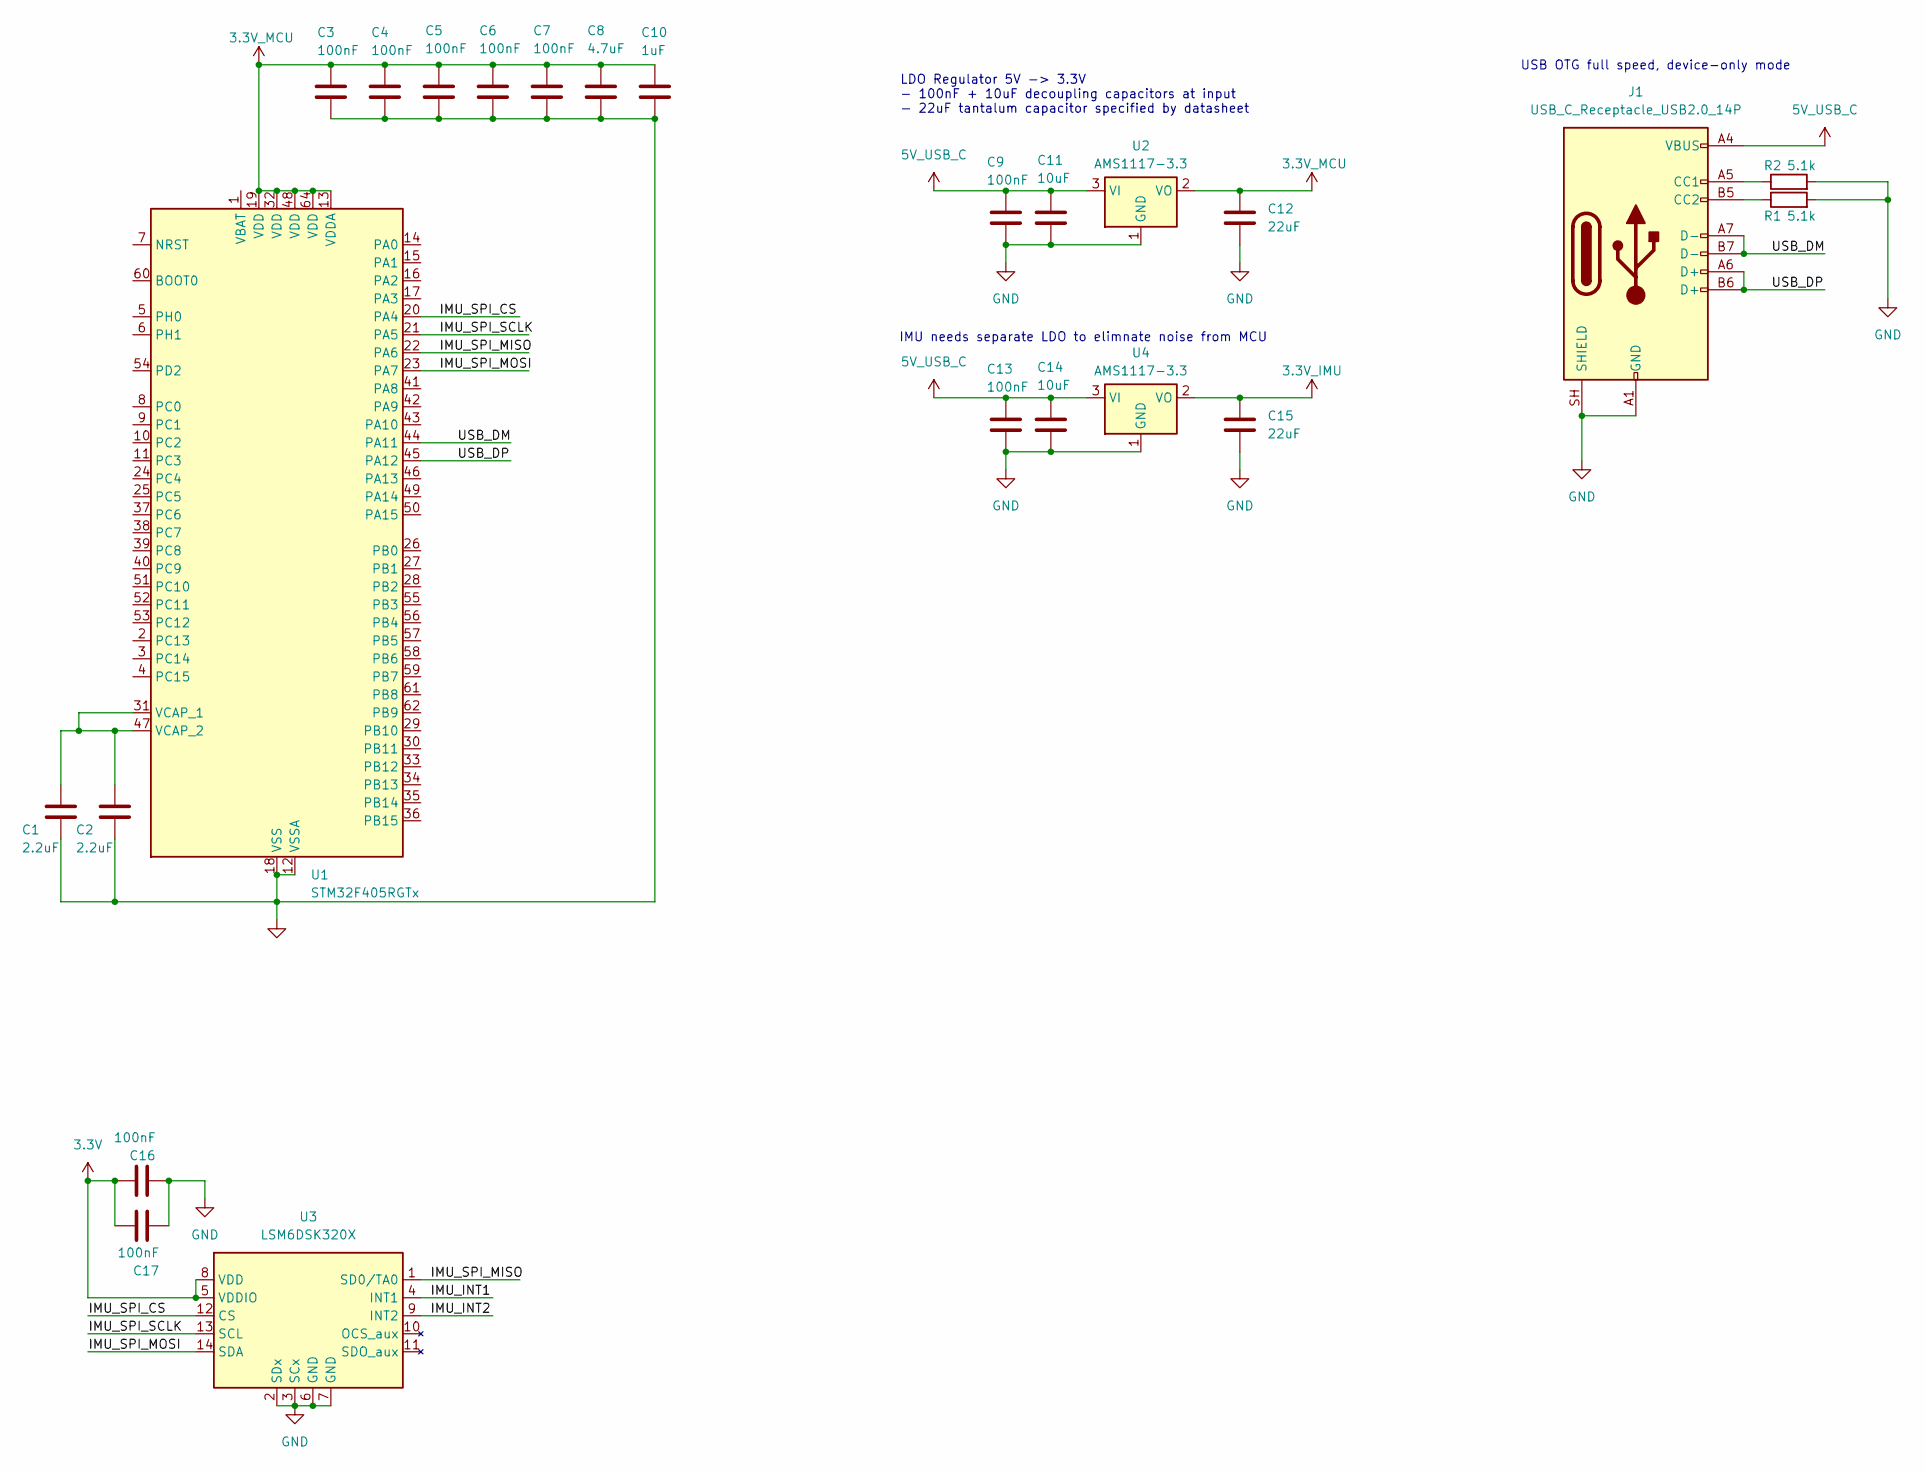
[picture p43: schematic DroneFlightController.kicad_sch]

Parts:
C1, C2: 2.2uF
C3, C4, C5, C6, C7, C9, C13, C16, C17: 100nF
C8: 4.7uF
C10: 1uF
C11, C14: 10uF
C12, C15: 22uF
J1: USB_C_Receptacle_USB2.0_14P
R1, R2: 5.1k
U1: STM32F405RGTx; LQFP-64_10x10mm_P0.5mm
U2, U4: AMS1117-3.3; SOT-223-3_TabPin2
U3: LSM6DSK320X

Connections:
3.3V: C16.1, C17.1, U3.5 (VDDIO), U3.8 (VDD)
3.3V_IMU: C15.1, U4.2 (VO)
3.3V_MCU: C3.1, C4.1, C5.1, C6.1, C7.1, C8.1, C10.1, C12.1, U1.13 (VDDA), U1.19 (VDD), U1.32 (VDD), U1.48 (VDD), U1.64 (VDD), U2.2 (VO)
5V_USB_C: C9.1, C11.1, C13.1, C14.1, J1.A4 (VBUS), J1.A9 (VBUS), J1.B4 (VBUS), J1.B9 (VBUS), U2.3 (VI), U4.3 (VI)
GND: C1.2, C2.2, C3.2, C4.2, C5.2, C6.2, C7.2, C8.2, C9.2, C10.2, C11.2, C12.2, C13.2, C14.2, C15.2, C16.2, C17.2, J1.A1 (GND), J1.A12 (GND), J1.B1 (GND), J1.B12 (GND), J1.SH (SHIELD), R1.2, R2.2, U1.12 (VSSA), U1.18 (VSS), U1.63 (VSS), U2.1 (GND), U3.2 (SDx), U3.3 (SCx), U3.6 (GND), U3.7 (GND), U4.1 (GND)
IMU_INT1: U3.4 (INT1)
IMU_INT2: U3.9 (INT2)
IMU_SPI_CS: U1.20 (PA4), U3.12 (CS)
IMU_SPI_MISO: U1.22 (PA6), U3.1 (SD0/TA0)
IMU_SPI_MOSI: U1.23 (PA7), U3.14 (SDA)
IMU_SPI_SCLK: U1.21 (PA5), U3.13 (SCL)
unnamed: C1.1, C2.1, U1.31 (VCAP_1), U1.47 (VCAP_2)
unnamed: J1.A5 (CC1), R2.1
unnamed: J1.B5 (CC2), R1.1
USB_DM: J1.A7 (D-), J1.B7 (D-), U1.44 (PA11)
USB_DP: J1.A6 (D+), J1.B6 (D+), U1.45 (PA12)

Notes on the sheet:
LDO Regulator 5V -> 3.3V - 100nF + 10uF decoupling capacitors at input - 22uF tantalum capacitor specified by datasheet
IMU needs separate LDO to elimnate noise from MCU
USB OTG full speed, device-only mode
