NathanSpalding/wdd2-pick-and-place-arm/electronics/schematic/wdd2-pick-and-place-schematic/wdd2-pick-and-place-schematic.kicad_pcb

## KiCad design DroneFlightController/mcu.kicad_sch

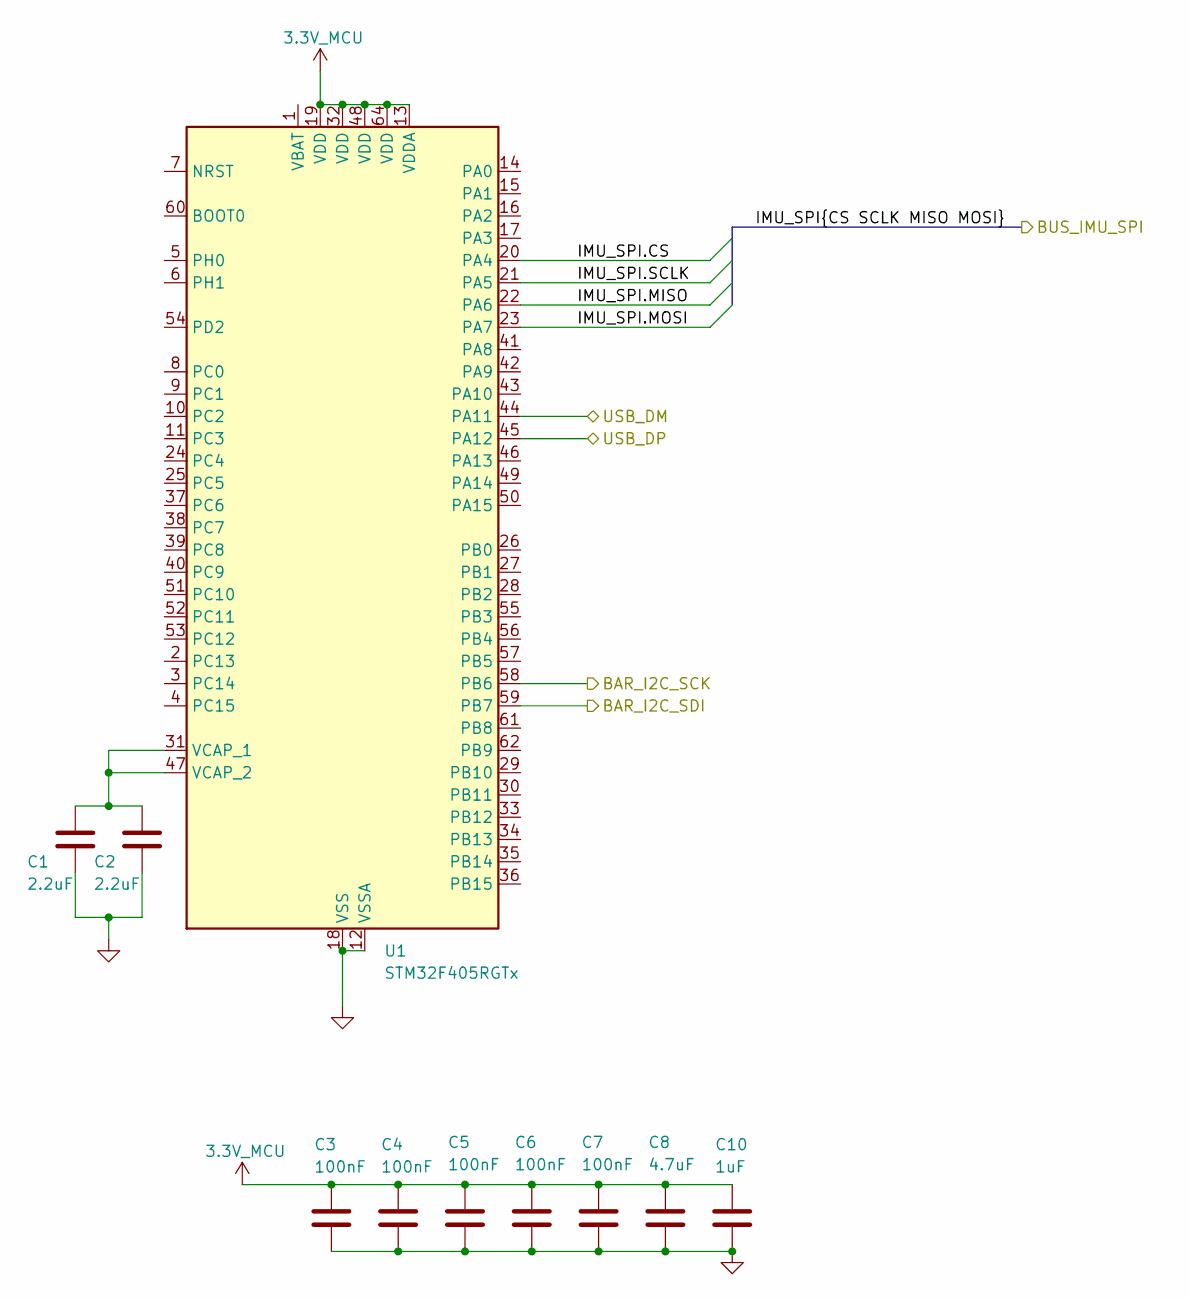
[picture p44: schematic mcu.kicad_sch]

Parts:
C1, C2: 2.2uF
C3, C4, C5, C6, C7: 100nF
C8: 4.7uF
C10: 1uF
U1: STM32F405RGTx; LQFP-64_10x10mm_P0.5mm

Connections:
3.3V_MCU: C3.1, C4.1, C5.1, C6.1, C7.1, C8.1, C10.1, U1.13 (VDDA), U1.19 (VDD), U1.32 (VDD), U1.48 (VDD), U1.64 (VDD)
BAR_I2C_SCK: U1.58 (PB6)
BAR_I2C_SDI: U1.59 (PB7)
GND: C1.2, C2.2, C3.2, C4.2, C5.2, C6.2, C7.2, C8.2, C10.2, U1.12 (VSSA), U1.18 (VSS), U1.63 (VSS)
IMU_SPI.CS: U1.20 (PA4)
IMU_SPI.MISO: U1.22 (PA6)
IMU_SPI.MOSI: U1.23 (PA7)
IMU_SPI.SCLK: U1.21 (PA5)
unnamed: C1.1, C2.1, U1.31 (VCAP_1), U1.47 (VCAP_2)
USB_DM: U1.44 (PA11)
USB_DP: U1.45 (PA12)
