NathanSpalding/wdd2-pick-and-place-arm/electronics/schematic/wdd2-pick-and-place-schematic/wdd2-pick-and-place-schematic.kicad_pcb

## KiCad design DroneFlightController/power_supply.kicad_sch

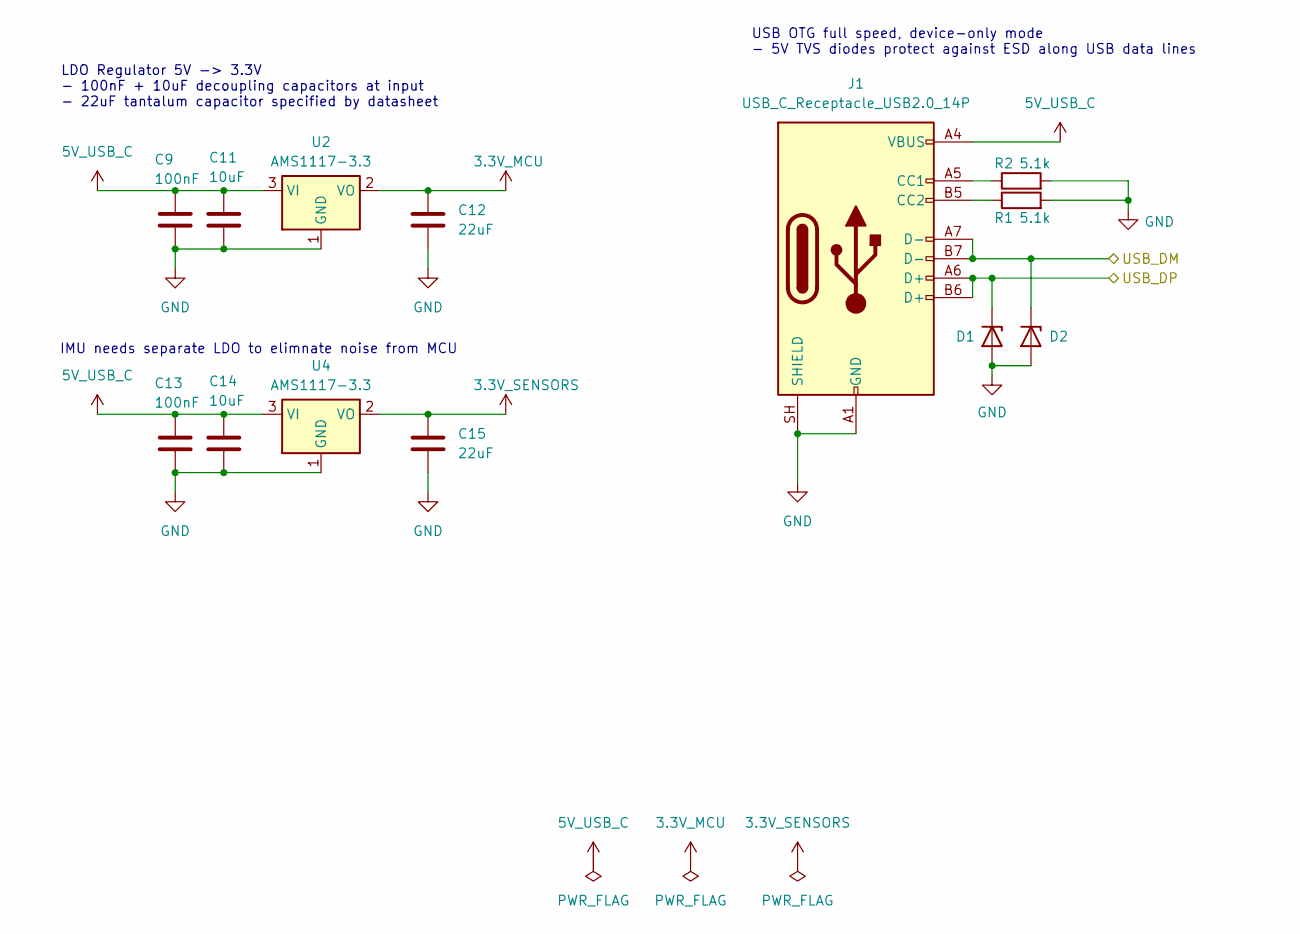
[picture p45: schematic power_supply.kicad_sch]

Parts:
C9, C13: 100nF
C11, C14: 10uF
C12, C15: 22uF
D1, D2: PTVS5V0Z1USK; Nexperia_DSN1608-2_1.6x0.8mm
J1: USB_C_Receptacle_USB2.0_14P
R1, R2: 5.1k
U2, U4: AMS1117-3.3; SOT-223-3_TabPin2

Connections:
3.3V_MCU: C12.1, U2.2 (VO)
3.3V_SENSORS: C15.1, U4.2 (VO)
5V_USB_C: C9.1, C11.1, C13.1, C14.1, J1.A4 (VBUS), J1.A9 (VBUS), J1.B4 (VBUS), J1.B9 (VBUS), U2.3 (VI), U4.3 (VI)
GND: C9.2, C11.2, C12.2, C13.2, C14.2, C15.2, D1.2 (A), D2.2 (A), J1.A1 (GND), J1.A12 (GND), J1.B1 (GND), J1.B12 (GND), J1.SH (SHIELD), R1.2, R2.2, U2.1 (GND), U4.1 (GND)
unnamed: J1.A5 (CC1), R2.1
unnamed: J1.B5 (CC2), R1.1
USB_DM: D2.1 (K), J1.A7 (D-), J1.B7 (D-)
USB_DP: D1.1 (K), J1.A6 (D+), J1.B6 (D+)

Notes on the sheet:
IMU needs separate LDO to elimnate noise from MCU
USB OTG full speed, device-only mode - 5V TVS diodes protect against ESD along USB data lines
LDO Regulator 5V -> 3.3V - 100nF + 10uF decoupling capacitors at input - 22uF tantalum capacitor specified by datasheet
