NathanSpalding/wdd2-pick-and-place-arm/electronics/schematic/wdd2-pick-and-place-schematic/wdd2-pick-and-place-schematic.kicad_pcb

## KiCad design DroneFlightController/sensors.kicad_sch

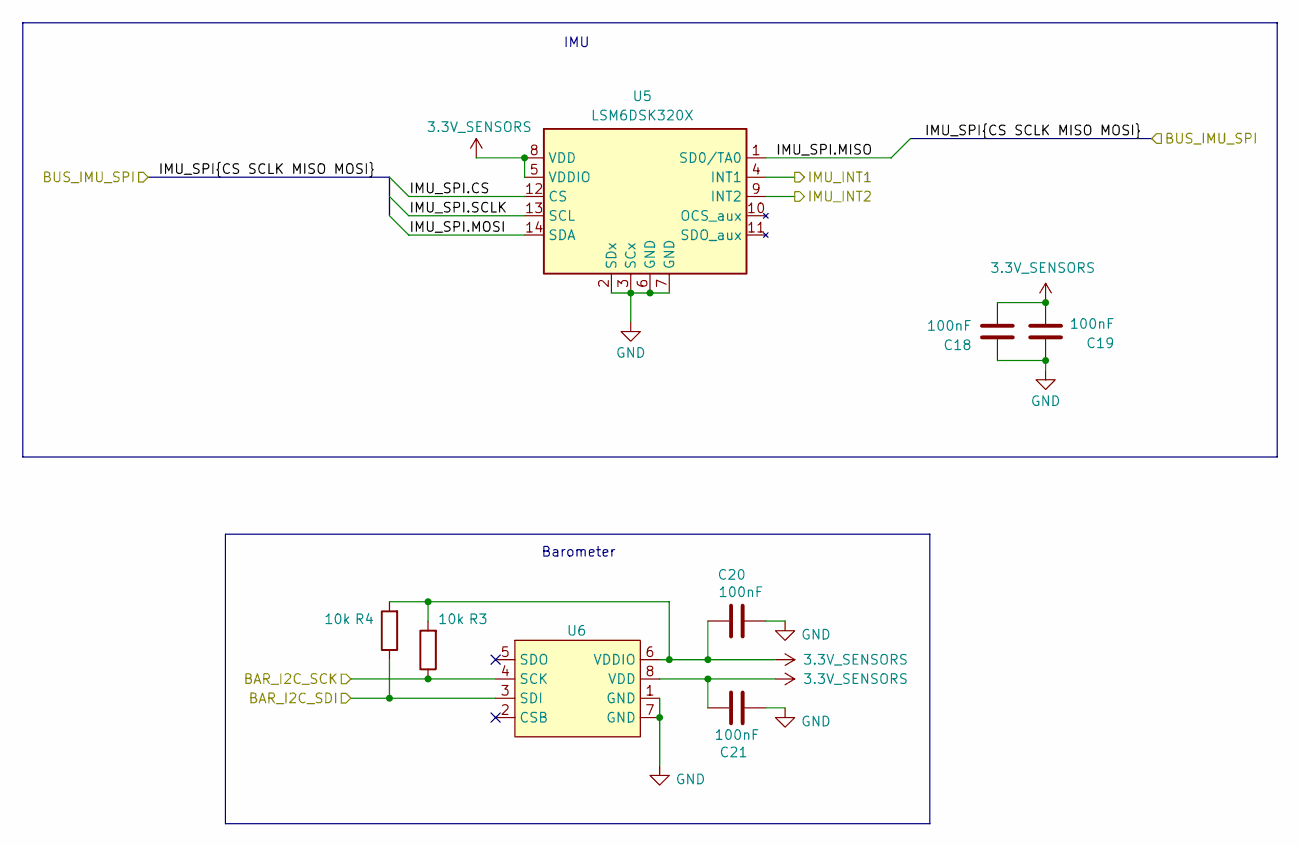
[picture p46: schematic sensors.kicad_sch]

Parts:
C18, C19, C20, C21: 100nF
R3, R4: 10k
U5: LSM6DSK320X
U6: (no value)

Connections:
3.3V_SENSORS: C18.1, C19.1, C20.1, C21.1, R3.2, R4.2, U5.5 (VDDIO), U5.8 (VDD), U6.6 (VDDIO), U6.8 (VDD)
BAR_I2C_SCK: R3.1, U6.4 (SCK)
BAR_I2C_SDI: R4.1, U6.3 (SDI)
GND: C18.2, C19.2, C20.2, C21.2, U5.2 (SDx), U5.3 (SCx), U5.6 (GND), U5.7 (GND), U6.1 (GND), U6.7 (GND)
IMU_INT1: U5.4 (INT1)
IMU_INT2: U5.9 (INT2)
IMU_SPI.CS: U5.12 (CS)
IMU_SPI.MISO: U5.1 (SD0/TA0)
IMU_SPI.MOSI: U5.14 (SDA)
IMU_SPI.SCLK: U5.13 (SCL)

Notes on the sheet:
IMU
Barometer
