NathanSpalding/wdd2-pick-and-place-arm/(commit log)

2026-10-21 Added CAD files, firmware, test data and Schematics
    [01_Power_Input.kicad_sch, 02_Power_Servo_Rails.kicad_sch, 03_Stepper_Driver.kicad_sch, 04_Encoders.kicad_sch, 05_MCU.kicad_sch, 06_Servo_Connectors.kicad_sch, AS5600Cover-Print.stl, AS5600Cover-print.step]
2026-10-21 Organised Test data, added firmware, BOM, Electronic schematics
    [8.2_encoder_vs_reference_sweep1.csv, 8.3_encoder_noise_60s.csv, 8.3_servo_deadband.csv, 8.4_loop_timing.csv, 8.4_step_metrics_all_steps.csv, 8.4_timeseries_base_0g.csv, 8.4_timeseries_elbow_0g.csv, 8.4_timeseries_elbow_500g.csv]
2026-10-21 added arm image
